Amir10202010/neuromove/hardware/models/enclosure/ПРОВЕРКА-v3.md

# Проверка корпусов v3, 27 октября 2026

Как проверены корпуса для датчиков со штырьками и ESP32 на макетной плате, пока их никто
не напечатал. Проведены три уровня автоматизированной проверки:
геометрия сборки в модели, расчёт защёлки, 1000 случайных отпечатков на корпус. Плюс проверка STL.
Пересчитать: `python3 korpus_v3.py` и `python3 proverka_v3.py` (нужны build123d, scikit-fem, trimesh).
Seed 20261027.

**Итог.** В модели прошли все 60 проверок. На принтере, на котором 15 октября печатали первую
версию, все условия выполняются у 88% отпечатков датчика и 92% отпечатков корпуса ESP32. Почти все
провалы — разброс защёлки, тот же, что у v2. На незнакомом принтере 75%: там чаще всего бортик
крышки не входит в корпус, это лечится XY-компенсацией крышки. Печатью не проверено.

## Что исходные данные, а что допущение

Замер Амирхана 27 октября: датчик со штырьками 22 × 19 × 7 мм, наклон на столе около 11°;
макетная плата 45 × 33 × 9 мм; ESP32 51 × 28 × 13 мм, вместе с макетной платой 51 × 38 × 17 мм;
ремешок не шире 25 мм.

Из замера выведено: хвосты выводов под платой около 2,9 мм. Если плата лежит дальним краем на столе,
а хвостами в 1,3 мм от другого края, то при наклоне 11° под хвостами 14,7 × tg 11° ≈ 2,9 мм. Высота
7 мм с этим сходится: 2,9 + плата 1,6 + пластик штырьков 2,5.

Расхождение с замером: вдоль ряда выводов 19 мм, а восьми выводам с шагом 2,54 мм нужно 20,3 мм.
Ширина корпуса взята по v1, который 15 октября сел на плату. Длина ESP32 51 мм против 52,3 мм
по фото 23 октября: полость рассчитана на плату до 53 мм.

Не мерилось: толщина жилы провода (взято 1,4 мм; в расчёте 1,3–1,5 и отдельно 1,2–1,7), высота гнезда
«папа» над макетной платой (14 мм; в расчёте 13,5–15), где у макетной платы первый ряд и столбец
(по шагу дырок).

## Найдено и исправлено до печати

- **Висящий ряд ESP32 не годится для проводов.** Гнездо «мама» на штырьке висящего ряда уходит на 14 мм
  вниз, а до дна там 9 мм. На этом ряду D32 и D33, шина груди. Шина 1 перенесена на D19 и D18
  правого ряда. Позже, 27 октября, прошивка перешла на три шины по умолчанию (D21/D22, D19/D18, программная
  на GPIO16/17), опция `NM_BUS1_RIGHT` убрана; прежняя разводка — `NM_TWO_BUSES`.
  Тест прошивки на компьютере: 108 проверок прошли; с опцией шина 1 на 19 и 18, без неё на 32 и 33.
- **У вывода 3V3 три свободные дырки, а нужно четыре**: VCC трёх датчиков и AD0 «ПР». Ряд d закрывает
  край ESP32: модель показывает, что гнездо в нём упирается в плату на 0,4 мм. Выход — плоская перемычка
  по ряду d из столбца 15 в свободный столбец 16, она проходит под краем ESP32.
- **Опора под висящим краем ESP32 была впритык.** Высота макетной платы гуляет на ±0,3 мм, и у 27%
  отпечатков опора поднимала край ESP32. Теперь опора ниже на 1,6 мм, на ней два слоя вспененного
  скотча: касается у 99,5%.
- **Полость ESP32 53,6 мм была коротка** для платы 53 мм у 8% отпечатков. Стала 54,4 мм.
- **Язычок датчика прижимал провода слабо** у 5% отпечатков при нажиме 0,25 мм. Стал 0,3 мм: прижимает
  у 97,8%, мешает крышке сесть у 1,3%.
- **Над гнёздами на изгиб провода было 4,5 мм**, у 4% гнёзд выше 14,5 мм этого мало. Стало 5 мм.
- **Плата датчика на вспененном скотче гуляла бы по высоте** на ±0,4 мм, вместе с ней провода в пазу.
  Теперь скотч тонкий, а под хвосты выводов канавка в дне.

## 1. Геометрия сборки, `korpus_v3.py`

Датчик, 32 проверки. Плата, хвосты, пластик штырьков и гнёзда входят и корпус не задевают. Плата лежит
на площадке, ниже на 0,3 мм упирается: значит, лежит ровно, не на хвостах. Хвосты не достают дна
канавки и с запасом 0,3 мм. Гнёзда отъезжают не дальше 1,5 мм, на штырьке остаётся 4,5 мм. Ни одна из
трёх крышек не задевает плату, детали до 1,9 мм, пластик и гнёзда. Пять проводов ложатся в паз, язычок
каждой крышки прижимает каждый провод. Гнездо в паз не пролезает: паз 6,52–7,82 мм по высоте, гнездо
6,10–8,64. Защёлка: крышка садится, на 1 мм выше упирается с обеих сторон, повёрнутая не садится,
балки отделены прорезью. Ремешок 25 мм проходит, 28 мм нет.

ESP32, 28 проверок. Макетная плата, ESP32, модуль, USB-C, оба ряда штырьков на месте и ничего не задевают.
Макетная плата, сдвинутая на 1 мм в любую сторону, упирается. Висящий край лежит на опорах через пену,
выше на 0,5 мм упирается в штыри крышки. Все 13 гнёзд по таблице из [`ПЕЧАТЬ-v3.md`](ПЕЧАТЬ-v3.md) стоят
и не задевают ESP32, корпус и крышку. Перемычка в ряду d лежит под ESP32. Три ленты по пять жил лежат
в своих ложбинках, дверца прижимает каждую жилу. Штекер USB-C 12 × 6,5 мм входит. Ремень 40 мм проходит.

## 2. Защёлка и 1000 отпечатков, `proverka_v3.py`

Балки защёлки те же, что в v2. Датчик: балка 24 × 1,3 × 1,8 мм, натяг 0,3 мм, 5,6 Н на выступ,
закрыть около 17 Н, держит около 26 Н, растяжение 1,1%. ESP32: балка 28 × 1,6 × 1,8 мм, 5,9 Н,
закрыть около 18 Н, держит около 28 Н, растяжение 0,9%.

Сверх разброса принтера, как в v2, у каждого отпечатка случайные: плата GY-521 20,0–21,2 × 15,6–16,4 мм,
хвосты 2,5–3,4 мм, пластик штырьков за краем платы на 0–1 мм, ось штырька 1,15–1,4 мм над платой,
гнездо 13,6–14,6 мм длиной и 2,45–2,6 мм в сечении, скотч 0–0,2 мм; макетная плата ±0,3 мм по каждому
размеру; ESP32 51–53 × 28,5–28,9 мм, пластик её штырьков 2,4–2,6 мм; пена на опоре 1,8–2,4 мм.

| Корпус | Все условия |
|---|---|
| Датчик, жила 1,4 ± 0,1 мм | 74,6% |
| Датчик, принтер как 15 октября | 88,3% |
| Датчик, провод не мерили: 1,2–1,7 мм | 70,0% |
| ESP32, жила 1,4 ± 0,1 мм | 75,2% |
| ESP32, принтер как 15 октября | 91,8% |

Что проваливается чаще всего: бортик крышки не входит в корпус на незнакомом принтере (82–84%), это
XY-компенсация; держит слабее 10 Н (около 96%); растяжение балки датчика больше 2% (91,6% на незнакомом,
97,7% на знакомом). Условия про плату, провода и гнёзда выполняются у 97–100% отпечатков.

## 3. STL

Все шесть сеток замкнуты, обход граней верный, каждая деталь из одного куска, лежит на столе плоской гранью.
Снизу без опоры почти ничего: мосты 5 мм² у корпусов (потолок прорезей), у крышек 175–200 мм² — дно букв
и прорези над балками, как в v2.
