Amir10202010/neuromove/железо.md

# NeuroMove — железо

Этот файл описывает аппаратную часть и формат взаимодействия с программной частью
([`софт.md`](софт.md), раздел 1). Актуальные схемы и инструкции по устройству находятся в [`hardware/`](hardware/README.md).

Схема простейшего прототипа для трекера — способ А на одной руке: компоненты, крепление,
запись данных, стоимость и риски — [`прототип.md`](прототип.md).

---

## 1. Что в питче (слайды 5, 6, 11)

- 4–6 блоков размером ~5×3×1 см и весом 30–50 г на эластичных ремешках с липучкой.
- Батарея на 2–3 часа, зарядка через USB-C.
- IMU — 9-осевой модуль Trema на BMX055: акселерометр, гироскоп, магнитометр.
  На скриншоте «Чип и Дип» на слайде 6 — 10 800 ₸.
- Смета команды на один датчик: IMU $4–6, микроконтроллер с Bluetooth $4–6, батарея
  и зарядка USB-C $4–6, корпус и ремешок $3–4, плата и сборка $3–5 — итого ~$18–27.
  Комплект из 4–6 датчиков — ~$70–160, от 100 комплектов — ~$50–100.

⚠️ Смета питча — цена **чипов для своей платы в серии**. Прототип собирают из готовых
модулей в магазине, и стоит он иначе (раздел 6).

## 2. Какой IMU брать для прототипа

| | MPU-6050 (модуль GY-521) | BMX055 (модуль Trema) |
|---|---|---|
| Оси | 6: акселерометр и гироскоп | 9: плюс магнитометр |
| Цена | 1 050–1 650 ₸ | 10 800 ₸ (слайд 6) |
| 5 датчиков | ~5 000–8 000 ₸ | ~54 000 ₸ |
| Ориентацию считает сам | нет — считаем в софте | нет — считаем в софте |
| Где купить | Alash Electronics, AmperMarket, Kaspi; скорее всего есть в запасах | «Чип и Дип» |

Предложение — прототип на MPU-6050. Магнитометр, ради которого берут 9 осей, в помещении
врёт рядом с металлом: кровати, коляски, тренажёры. Для угла в суставе он не нужен — угол
между двумя сегментами считается по гравитации и гироскопу. Если позже понадобится
ориентация «по компасу» — BNO085: он сам сводит датчики внутри чипа, но с ESP32
подключается только по SPI.

## 3. Три способа собрать прототип

| | Как | Плюсы | Минусы | Когда |
|---|---|---|---|---|
| **А. Провода** | один ESP32 на туловище, IMU на плече и предплечье — по проводам (I2C); ESP32 → USB → ноутбук | дёшево; все датчики на одних часах — синхронизация бесплатно; без Bluetooth | провода мешают; ребёнку неудобно | стенд и демонстрация на себе: октябрь — ноябрь |
| **Б. Каждый датчик сам по себе** | в каждом блоке свой ESP32, IMU и аккумулятор; каждый по Bluetooth к компьютеру | как в питче; без проводов | у каждого блока свои часы — нужна синхронизация; 5 подключений Bluetooth одновременно | пилот |
| **В. Датчики и хаб** | блоки шлют данные хабу-ESP32 по ESP-NOW, хаб по USB — в ноутбук | без проводов на ребёнке; одно надёжное подключение к компьютеру; хаб задаёт общее время | ещё один ESP32 и прошивка хаба | если в варианте Б сбоит связь |

Предложение: **А** — к живой демонстрации «датчик на руке → отчёт на экране»,
**Б** или **В** — к пилоту на детях.

## 4. Где стоят датчики

| Датчик | Место | Для чего |
|---|---|---|
| Туловище | грудина | компенсаторные наклоны; опора для угла в плечевом суставе |
| Плечо, левое и правое | середина плеча снаружи | подъём руки: плечо относительно туловища |
| Предплечье, левое и правое | ближе к запястью | сгибание локтя: предплечье относительно плеча |

Одна рука — 3 датчика, две руки — 5. Ноги — следующим шагом: бедро, голень, стопа
дают колено и голеностоп.

## 5. Подключение стенда — способ А

Два MPU-6050 висят на одних и тех же четырёх проводах шины I2C. Различаются только
выводом AD0: он задаёт адрес, по которому ESP32 отличает датчики.

| Вывод GY-521 | IMU №1 — плечо, рядом с ESP32 | IMU №2 — предплечье, по кабелю | ESP32 DevKit |
|---|---|---|---|
| VCC | 3V3 | 3V3 | 3V3 |
| GND | GND | GND | GND |
| SCL | GPIO22 | GPIO22 | GPIO22 |
| SDA | GPIO21 | GPIO21 | GPIO21 |
| AD0 | GND → адрес 0x68 | 3V3 → адрес 0x69 | — |

- Третий и четвёртый датчик (туловище, вторая рука) — на вторую шину I2C: у ESP32 их две,
  выводы второй назначаются программно, например 32 и 33. Адреса там снова 0x68 и 0x69.
- Arduino Uno или Nano на стенде: VCC → 5V, SDA → A4, SCL → A5, остальное так же.
- Кабель до дальнего датчика — до ~50 см, шина на 100 кГц. Если связь сбоит — укоротить кабель.
- ⚠️ LiPo 3.7 В нельзя подавать на вход VIN платы DevKit: её стабилизатор (обычно AMS1117)
  при входе ниже ~4.3 В не держит 3.3 В, и плата перезагружается. Для блока с аккумулятором —
  плата с зарядкой LiPo (XIAO ESP32C3) или пауэрбанк.
- **Плата стенда — классический ESP32 DevKit** (ESP32-WROOM-32, CH340C, USB Type-C), куплена 9 октября:
  выводы как в таблице выше, вторая шина на 32 и 33. Если стенд соберут на ESP32-S3 N16R8, у неё другие
  выводы — шина 0 на GPIO 8 и 9, шина 1 на GPIO 4 и 5. Таблица, сборка и прошивка — [`firmware/README.md`](firmware/README.md).
- Датчики ставятся одинаково: ось X вдоль кости, стрелка на корпусе. Перед тестом —
  3 секунды неподвижно в исходной позе: это ноль.

## 6. Цены на прототип

Цены в тенге — магазины Казахстана на 24 сентября 2026; в долларах — у производителя, без доставки.
Строки «оценка» по магазинам не проверены.

| Компонент | Что | Цена |
|---|---|---|
| Микроконтроллер, **куплен 9.10** | ESP32 DevKit: ESP32-WROOM-32, CH340C, USB Type-C | 3 498 ₸ (Kaspi, MILTECH) |
| IMU, **куплены 9.10** | GY-521 (MPU-6050), 4 шт. | 882 ₸ за штуку (Kaspi, Alash Electronics) |
| Микроконтроллер | ESP32 DevKit (Wi-Fi и Bluetooth LE) | 3 450–4 500 ₸ |
| Микроконтроллер, выбор Малики для стенда | ESP32-S3 N16R8: две шины I2C, 2 × USB-C | 6 500 ₸ (AmperMarket, 29.09) |
| Плата для беспроводного блока, выбор Малики | ESP32-C3 Super Mini: одна шина I2C, зарядки LiPo нет | 1 900 ₸ (AmperMarket, 29.09) |
| IMU | MPU-6050, модуль GY-521 | 1 050–1 650 ₸ за штуку; в AmperMarket 29.09 — 1 950 ₸ |
| IMU, вариант питча | BMX055, модуль Trema | 10 800 ₸ за штуку (слайд 6) |
| IMU, если нужен компас | BNO085 — с ESP32 только по SPI | $29.50 за штуку (Adafruit) |
| Плата для беспроводного блока | XIAO ESP32C3 — с зарядкой LiPo | $4.90 (Seeed Studio) |
| Аккумулятор | LiPo 3.7 В, 300–500 мА·ч | оценка ~1 000–2 000 ₸ |
| Провода | 4-жильный кабель до ~50 см, дюпоны | оценка ~500 ₸ |
| Корпус и крепление | 3D-печать, липучки, мягкая подкладка | оценка ~1 000–2 000 ₸ за блок |
| Эталон для проверки | гониометр — взять у центра; видео сбоку, угол по видео в Kinovea (бесплатная программа) | 0 |

**Стенд способа А** (ESP32 + 3 × MPU-6050 + провода): ~7 000–10 000 ₸,
а если MPU-6050 и ESP32 есть в запасах — почти ноль. Куплено 9 октября: плата и 4 датчика за 7 026 ₸;
полный список стенда с проверенными ценами — [`прототип.md`](прототип.md), раздел 2.

## 7. Безопасность — для детей обязательно

- Только питание от аккумулятора или пауэрбанка; ничего на ребёнке не подключено к розетке.
- Корпус закрыт, аккумулятор недоступен, нет мелких деталей (дети тянут в рот) и острых краёв.
- Провода способа А — только на стенде и на себе, не на ребёнке.
- Прибор только измеряет: никакого тока в тело.
- Датчики на ребёнке — только при враче или инструкторе.

## Источники цен — проверено 24 сентября 2026

- MPU-6050 (GY-521): [Alash Electronics — от 1 050 ₸](https://alash-electronics.kz/product/giroskop-gy-521-na-baze-mpu-6050),
  [AmperMarket](https://ampermarket.kz/sensors/proximity/gyroscope-gy-521-mpu-6050/),
  [Kaspi](https://kaspi.kz/shop/p/akselerometr-arduparts-kz-giroskop-gy521-mpu-6050-1023--136326815/)
- ESP32 DevKit: [Alash Electronics — от 3 450 ₸](https://alash-electronics.kz/product/esp-woom-32),
  [с USB Type-C — от 4 500 ₸](https://alash-electronics.kz/product/esp-wroom-32-wi-fi-bluetooth-usb-type-c),
  [AmperMarket](https://ampermarket.kz/arduino/esp32-wi-fi-bluetooth/)
- XIAO ESP32C3 — [$4.90, Seeed Studio](https://www.seeedstudio.com/Seeed-XIAO-ESP32C3-p-5431.html)
- ESP32-S3 N16R8 — [AmperMarket, 6 500 ₸](https://ampermarket.kz/boards/esp/esp32-s3-n16r8/);
  ESP32-C3 Super Mini — [AmperMarket, 1 900 ₸](https://ampermarket.kz/boards/esp/esp32-c3-super-mini-weld/);
  GY-521 — [AmperMarket, 1 950 ₸](https://ampermarket.kz/sensors/proximity/gyroscope-gy-521-mpu-6050/) — проверено 29 сентября 2026
- BNO085 — [$29.50, Adafruit](https://www.adafruit.com/product/4754);
  про I2C с ESP32 — [руководство Adafruit](https://learn.adafruit.com/adafruit-9-dof-orientation-imu-fusion-breakout-bno085/arduino)
- BMX055 (Trema) — цена со скриншота на слайде 6, по магазину не сверялась.
