Amir10202010/neuromove/питч/README.md

# Питч NeuroMove — сентябрь 2026

15 слайдов питча команды для НИШ-инкубатора, получены 24 сентября 2026.
Слайды 1 и 15 заменены 26 сентября по PDF из Canva от 24 сентября (автор — Малика):
на титуле добавлен Амирхан, у слайда 15 новый заголовок. Остальные слайды в PDF те же.
Разбор, что в нём поправить, — [`../README.md`](../README.md), раздел 6.

| Слайд | Что на нём |
|---|---|
| [01](01.jpg) | Титул: «Система объективной оценки движения у детей с ДЦП на основе носимых IMU-сенсоров». NIS IB & NIS Nura Astana; капитан — Кеуденбай Малика, hardware — Хасенов Санжар, software — Сағындық Амирхан; выпуск 2028 |
| [02](02.jpg) | Проблема: «больше 20 тыс. детей с ДЦП в Казахстане»; по протоколу РК оценивают шкалами GMFCS, GMFM и модифицированной шкалой Эшворта; шкалы балльные и субъективные |
| [03](03.jpg) | Проблема: шкалы не дают градусов объёма движений, симметрии, ротации, компенсаторных наклонов; врач не видит, где терапия работает, а где плато; родители не видят динамику |
| [04](04.jpg) | Решение: 4–6 датчиков на запястьях, локтях, коленях, голеностопах; отчёт за 10–15 минут; ROM, симметрия, плавность, компенсации; «не замена шкалам, а дополнение». Фото — коммерческий датчик из MedicalEXPO |
| [05](05.jpg) | Датчики: ~5×3×1 см, 30–50 г, ремешок на липучке; приложение на ПК, казахский и русский, PDF и веб-интерфейс; батарея 2–3 часа, USB-C. Картинка сгенерирована OpenAI |
| [06](06.jpg) | Как работает IMU: акселерометр, гироскоп, магнитометр; модуль Trema на BMX055 («Чип и Дип», 10 800 ₸); таблица «метрика → датчик → как считаем» |
| [07](07.jpg) | Макет интерфейса «NeuroMove KZ»: датчики на плечах и предплечьях, ROM, симметрия, плавность, наклон туловища, MotorScore 72/100, история тестов, экспорт PDF. Сгенерирован OpenAI |
| [08](08.jpg) | Второй макет, на английском: анализ руки, индекс симметрии, тренд прогресса, MotorScore. Сгенерирован OpenAI |
| [09](09.jpg) | Ребёнок с датчиками и планшетом с отчётом — «связка датчиков и веб-интерфейса на ПК». Сгенерировано OpenAI |
| [10](10.jpg) | Целевая аудитория: родители и дети, врачи («10–15 минут вместо 30–60»), реабцентры |
| [11](11.jpg) | Смета: ~$18–27 за датчик, $70–160 за комплект, $50–100 при серии от 100; «на стадии идеи, ищем спонсоров и команду» |
| [12](12.jpg) | Как встраиваться: пилот в 1–2 центрах, B2B «оборудование + подписка», B2G с Минздравом, обезличенная статистика; модель сотрудничества с центрами |
| [13](13.jpg) | План на инкубацию: прототип на 2–4 датчиках, алгоритм ROM/симметрии/плавности, веб-интерфейс с отчётом, пилот на 5–10 детях, согласие центра, живая демонстрация на Demo Day |
| [14](14.jpg) | Что нужно от программы: менторство по медтеху, экспертиза в железе и обработке сигналов, финансирование, выход на B2G |
| [15](15.jpg) | «Отзыв врача-реабилитолога»: сообщение в мессенджере от 15 сентября 2026 — заведующий отделением реабилитации Центра неврологии и реабилитации «Aspasia», Алматы |

Картинки на слайдах 5, 7, 8, 9 сгенерированы — это макеты, не работающий прибор.
На слайдах 2, 3, 10 — стоковые фото.
