Amir10202010/neuromove/website/src/assets/README.md

# Картинки стартовой страницы

| Файл | Что на нём | Где |
|---|---|---|
| `movement-study-1536.webp` (100 КБ), `-768` (27 КБ) | Рука взрослого с датчиком на предплечье и ремешком на плече | первый экран, `features/welcome/HeroPhoto.tsx` |
| `sensor-concept-1536.webp` (173 КБ), `-768` (57 КБ) | Датчик: светлый корпус на тканевом ремешке | сцена «Датчики», `features/welcome/sections/Kit.tsx` |

**Это концепт-изображения, сгенерированные 27 сентября 2026** для версии страницы, сделанной
на другом компьютере. Модель и датчик вымышлены: это не снимки настоящего устройства, не пациент
и не участник исследования. На странице так и подписано — «концепт-изображение», «концепт корпуса».
Корпус, материалы и размеры — направление дизайна, а не характеристики: прототип собирает команда
(`../../../железо.md` — там реальные датчики, цены и способы сборки).

Чего по этим картинкам **не говорить**: что устройство готово, что его носили дети, что это фото
с занятий или из клиники.

Картинки подключены через `import`, а не лежат в `public/`: так Vite кладёт их в обычную сборку
с хешем в имени, а в демо одним файлом (`npm run build:demo`) — прямо внутрь HTML. Иначе
`demo/NeuroMove.html`, открытый с диска, остался бы без фото.

⚠️ На фото — взрослый, а продукт — для детей с ДЦП. Если жюри или врач спросит — честный ответ:
это иллюстрация того, где стоят датчики, снимков с детьми нет и без согласия родителей и этического
комитета не будет.

Знак NeuroMove — `src/ui/Logo.tsx` (для приложения) и `public/brand/` (SVG для презентаций:
знак, знак со словом, иконка вкладки). В `index.html` иконка вкладки вшита строкой — так она есть
и в демо одним файлом.

Монограмма `nm` — плавная линия с терракотовой точкой соединения. SVG без пустых полей;
в интерфейсе линия наследует цвет текста, а в тёмной шапке точка становится светлее.
`LogoMark` встроен в страницу и не требует загрузки отдельной картинки, в том числе в офлайн-демо.
При изменении геометрии обновлять также SVG в `public/brand/`; компактный знак для вкладки
хранится в `favicon.svg` и дублируется как data URL в `index.html`.
