Amir10202010/neuromove/website/docs/DESIGN_SYSTEM.md

# Дизайн-система NeuroMove

Одна система на стартовую страницу и приложение. Токены — `src/styles/tokens.css` (приложение)
и переменные `--lp-*` в `src/styles/landing.css` (страница); рисунки — `src/figures/`;
секции с данными — `src/styles/instrument.css`. История решений — `EXPERIENCE.md`, аудит перед
этим проходом — `DESIGN_AUDIT.md`, референсы — `REFERENCE_STUDY.md`.

## 1. Направление — выбор 17 октября 2026

Сравнивали три разных направления, а не три оттенка одного.

| | A. «Протокол измерения» | B. «Кино» | C. «Клинический журнал» |
|---|---|---|---|
| Суть | Сайт и приложение — откалиброванный прибор: шкалы, риски, моно-подписи, волосяные линии, числа из системы, один цвет у измеряемого | Тёмные полноэкранные кадры, огромная светлая типографика, закреплённые сцены, разборное устройство | Страница как научная статья: заголовки с засечками, «Методы → Результаты → Ограничения», таблицы, сноски |
| Связь с продуктом | Прямая: продукт и есть измерительный прибор | Слабая: нужна настоящая съёмка, которой нет | Сильная для врачей и жюри |
| Отличие от рынка | Высокое: никто из референсов не показывает работающий алгоритм | Низкое: так выглядят Neuralink и Palantir | Среднее |
| Честность | Высокая: визуал рисуется из данных | Низкая: держится на сгенерированных картинках | Высокая |
| Семьям | Понятно, если числа сопровождаются словами | Холодно | Сухо, много текста |
| Риски | Перегрузить деталями | Пустая красота, «ИИ-лендинг» | Скучно, мало продукта; кириллица и казахские буквы у шрифтов с засечками проверены хуже |
| Производительность | SVG и DOM, без библиотек | Видео и WebGL | Лёгкая |

**17 октября выбрано A** — с дисциплиной доказательств из C. **18 октября Амирхан это отверг**:
страница «выглядит как фигня», «как в neuralink» — и попросил вернуть сцену «Как это работает»
с разборной моделью датчика и сделать тёмные фоны чисто чёрными. Ошибка была в выборе: я разобрал
Neuralink и пошёл в «инженерную документацию» (плотные графики, моно-подписи, рамки), а Амирхану
нужен язык самого Neuralink. Поэтому с 18 октября основа — **B «Кино»** по замерам neuralink.com
(раздел 4): чёрный и белый, тонкие крупные заголовки, мало текста на экран, крупный предмет.
От A остались данные там, где они уже есть («Проверка», «Данные»), и честные подписи.

**Вечером 18 октября — второй проход** по просьбе Амирхана: «картинки, анимации и иллюстрации
ужасно выглядят», страницу сократить. Референсы — сайты носимых медицинских приборов
(Apple Health, Oura, Whoop, Hinge Health, Sword Health; `REFERENCE_STUDY.md`, раздел «18 октября,
вечер»). Что взяли: у каждого утверждения своя картинка, а не абзац (Hinge Health: точки, дуга);
число крупно и тонко рядом с маленькой инфографикой; сноска, откуда число (Apple, Oura); скелет
из линий как язык движения (Sword) — у нас кадрами во времени, из модели движения.
Одиннадцать сцен стали девятью: «Отчёт» слит с «Семьям», «Данные» — карточка в «Проверке».

**Поздно вечером 18 октября** светлые секции стали чисто белыми вместо тёплой «бумаги» `#f3f1eb`,
серые на них — нейтральными, без зелени (просьба Амирхана: «как у Neuralink»). Страница теперь
в двух цветах, белом и чёрном, и одном акценте. Экраны приложения внутри планшета остаются в своих
токенах (`tokens.css`): это настоящий интерфейс, страница не должна его перекрашивать.

## 2. Принципы

1. **Каждое число — из системы.** Цифры страницы считаются функциями приложения на демо-данных
   (`story.ts`), график «Проверки» — из сырых файлов прогона (`proofData.ts`, сверка — тест).
2. **Рисунок вместо слова, слово рядом с числом.** «145°» без картинки ничего не говорит, картинка
   без подписи — украшение.
3. **Подпись говорит, что настоящее, а что нет.** «Пример из демо, данные смоделированы»,
   «схема-концепт датчика», «независимая модель, не люди».
4. **Цвет только у измеряемого.** Правая рука — оранжевый, левая — синий (`--right`, `--left`),
   киноварь — результат проверки, правила, «смотрите сюда» в гиде. Остальное на странице —
   белый, чёрный и нейтральный серый; в приложении — графит и бумага.
5. **Линии вместо карточек.** Секции, списки, шаги разделены волосяными линиями 1 px.
   Карточка — только у того, что в жизни лист или экран (отчёт, планшет, рисунок движения).
6. **Одна главная кнопка на экране.** На странице — «Попробовать демо».
7. **Тексты без длинного тире**, имена вместо кодов, «демо» в приложении говорит одна полоса
   (решения Амирхана 15 и 17 октября).

## 3. Цвет

### Приложение (`tokens.css`)

| Слой | Токен | Значение |
|---|---|---|
| Рамка окна, боковая панель | `--frame`, `--side` | `#eeebe4` |
| Рабочий лист | `--sheet` | `#faf9f6` |
| Карточка | `--surface` | `#ffffff` |
| Текст: основной, второй, третий | `--text`, `--text-2`, `--text-3` | `#1d211f`, `#4d534b`, `#5c6159` (не ниже 4,5:1 на всех слоях) |
| Линия | `--border`, `--border-strong` | `#e5e1d8`, `#d3cdc1` |
| Стороны тела | `--left`, `--right` (+ `-soft`, `-text`) | `#2a78d6`, `#eb6834` |
| Демо и гид | `--demo` | `#b7452c` (киноварь знака) |
| Состояния | `--good`, `--warn`, `--critical`, `--info` | всегда с иконкой и словом |

### Страница (`landing.css`, `.lp`)

| Тема секции | Фон | Текст / приглушённый / подпись | Где |
|---|---|---|---|
| `lp-white` | `#ffffff` (с позднего вечера 18 октября — все светлые секции; до того часть была «бумагой» `#f3f1eb`) | `#0b0b0c` / `#55555c` (7,4:1) / `#6e6e76` (5,1:1) | первый экран, «Сегодня», датчики, тест вживую, «Семьям», «Проверка», подвал |
| `lp-dark` | `#000000` (с 18 октября; до того графит `#191c1a`) | `#ffffff` / 72 % / `#86868e` | «Как это работает», «Специалистам», финал |
| карточка `lp-card`, `lp-study` | `#0b0b0c` / `#0a0a0b` | `#ffffff` / 74 % / `#8e8e96` | карточки «Проверки» на белом, рисунки движений на чёрном |

Ритм: белые и чёрные секции чередуются, соседние белые секции сливаются в одно поле, как у Neuralink; на белой «Проверке» — почти чёрные карточки, как
карточки исследований у Hinge Health (у них тёмно-зелёные). Киноварь на тёмном — `#dc6440` (`--lp-accent-hi`), на светлом — `#b7452c`.
Серые тона модели датчика на чёрном — нейтральные, без зелени; зелёная только плата.

## 4. Типографика

| Роль | Шрифт | Размер, начертание |
|---|---|---|
| Заголовки страницы | Inter Display (ось оптического размера) | `lp-d1` 44–104 px / 300, `lp-d2` 36–76 px / 300, трекинг −0,05…−0,055 em, интерлиньяж 1,0 |
| Подпись раздела | Inter | 16 px / 400, серая (`--lp-faint`) — как «Implant» у Neuralink; без капслока и моно |
| Абзац страницы | Inter Display | `lp-lead` 17–19 px / 400, интерлиньяж 1,42 |
| Интерфейс | Inter | 14,5 px основной, 13 px подписи, кнопки 38 px высотой (44 px пальцем) |
| Числа-приборы | Inter Display, цифры одной ширины | угломер, таймер, показание прибора 46 px / 330 |
| Выноски модели, оси графиков, даты на линии времени | JetBrains Mono | 10,5–12 px, прописные с разрядкой |
| «Рис. N» и подписи под рисунками | Inter | 13 px / 400 |

Замеры neuralink.com 18 октября (1440 × 900): один шрифт (UntitledSans) на всё; заголовок первого
экрана 48 px / 500, заголовки секций 44 px / 300, заголовки шагов на странице Technology 80 px / 300,
трекинг −0,06 em, интерлиньяж 1,0; абзац 16–18 px, интерлиньяж 1,15–1,2; подписи 16 px, серые
`#797981`; фон тёмных секций `#000`. Кириллица шире латиницы, поэтому у нас трекинг −0,05…−0,055 em
и интерлиньяж абзаца 1,42.

Почему не другой шрифт: рассматривали Onest, Golos, Manrope, IBM Plex Sans, Geologica и шрифт
с засечками для направления C (Source Serif 4). Inter остаётся: полная кириллица с казахскими
буквами, ось оптического размера в одном файле (Inter Display на заголовках без второго
семейства), шрифт вшит в офлайн-демо. Смена шрифта сейчас — переделка всех экранов и демо
без выигрыша для человека. У JetBrains Mono 17 октября добавлена расширенная
кириллица: казахские буквы в моно-подписях раньше брались из системного шрифта (аудит, A7).

## 5. Сетка, отступы, скругления, глубина

- Страница: колонка до 1320 px, поля `clamp(20px, 5vw, 72px)`, секции `clamp(110px, 16svh, 180px)`
  сверху и снизу. Заголовок секции — `lp-split`: слева подпись и заголовок, справа абзац по нижнему краю.
- Приложение: шаг 4 px (`--s-1` … `--s-12`), лист с отступом 8 px от рамки.
- Скругления: 6, 9, 12, 16 px в приложении; 14–22 px у листов страницы; 999 px у кнопок-«пилюль».
- Глубина: тоном и линией. Тень — только у того, что лежит поверх (окна, меню, гид) и у листа отчёта.

## 6. Рисунки и приборы

**Система рисунков** (`src/figures/`, подробно — `EXPERIENCE.md`): одна геометрия ребёнка ~8 лет,
контур 1,5 px при любом размере, датчик — светлый корпус на тёмном ремешке со светодиодом.
С 8 ноября 2026 части тела — рисованные кривые (`geometry.smooth`) в системе координат сегмента:
голова в профиль с ухом и короткой стрижкой (`--fig-hair`), кисть с большим пальцем, колено, стопа.
Спереди руки лежат под корпусом — плечо продолжает линию трапеции. Датчики стоят как на прототипе
(`прототип.md`, корпус v3): грудина — корпус «портретом» на ремне 38 мм, стрелка вниз; плечо —
наружная сторона посередине; предплечье — тыльная сторона ближе к запястью; основание с «ушками»
под ремешок, стрелка оси X к кисти. Провода не рисуются: тот же рисунок служит и проводному
стенду (способ А), и беспроводным блокам (способ Б).

**Сцена «Как это работает»** (`SensorModel.tsx`, `HowItWorks.tsx`) — разборная модель датчика
на чёрном, четыре шага (надеть, двигаться, измерить, увидеть), слои расходятся по шагам. Это
схема-концепт корпуса, так и подписано. Прибор «Из сигнала в градусы», стоявший здесь 17 октября,
снят по просьбе Амирхана; код — в коммите `a15749b`.

**Рисунки и инфографика страницы** (с вечера 18 октября; стили — `instrument.css` и `landing.css`):

| Где | Рисунок | Что показывает | Откуда данные |
|---|---|---|---|
| Тест вживую | планшет с экраном теста и тур из трёх пунктов | выбранный пункт подсвечивает свою часть экрана: угломер, отметки «прошлый раз» и «цель» на дуге, фигурку | экран — компоненты приложения (`ProductScreen.tsx`); подсветка встаёт по настоящим размерам частей |
| Семьям | лист отчёта со шкалой угла | рука сейчас (оранжевая), как было в начале курса (пунктир), прибавка (сектор), цель врача (ромб) | история Алихана (`story.ts`) |
| Специалистам | хронофотография, 4 рисунка | один повтор каждого движения, кадр каждые 0,1 с: веер руки, след кисти точками через равное время, шкала от сустава, пунктир — пик другой руки | модель движения демо (`studyData.ts`, тест `studyData.test.ts`) |
| Проверка | клин угла | ошибка локтя до правки 41° (штриховка) и после 1,6° (киноварь), предел 5° пунктиром | `proofData.ts` ← `docs/ENGINEERING_10H/data/*.json`, сверка `proofData.node.test.ts` |
| Проверка | 60 точек | 55 выполненных сценариев — белые, 5 известных ограничений — кольцом | тот же тест сверяет 60 / 55 / 5 с файлом прогона |
| Проверка | путь данных | граница «компьютер клиники», датчики → NeuroMove → хранилище, перекрытый выход в интернет | CSP из `vite.config.ts`, тест `e2e/trust.spec.ts` |
| Проверка | шкала стенда | полоса ±5° — критерий против ручного угломера | критерий записан до замера |

Правила рисунков: SVG в «родной» рамке, линии 1–2,5 px, подписи и числа — HTML поверх рисунка
(не растягиваются, берут шрифт страницы); у каждого рисунка подпись, что настоящее, а что модель.
Хронофотография — по снимкам Этьена-Жюля Марея (1880-е): тело в промежуточных кадрах втрое
бледнее руки, чтобы главным был веер движения, а не стопка голов.

## 7. Движение — как на страницах-презентациях Apple

С 18 октября (ночь). Амирхан: «хочу, чтобы сайт был как на презентации Apple». Записал видео
прокрутки страниц Apple Watch Series 12 и iPhone 18 Pro, разобрал по кадрам и замерил стили
в браузере (`REFERENCE_STUDY.md`, раздел «Движение Apple»). Цвет и шрифты остаются как у Neuralink
(чёрный, белый, тонкие заголовки); движение — как у Apple.

**Что делает Apple — пять приёмов.**

1. **Появление текста.** Заголовок или абзац оживает, когда его верх доходит до ~80 % высоты экрана:
   подъём на 30 px за 0,65 с и прозрачность 0 → 1 за 0,8 с, оба с плавным разгоном и торможением.
   Блок целиком, без разбивки на слова.
2. **Сцена от прокрутки.** Экран закреплён на 1,1–1,5 высоты прокрутки; картинка в нём
   увеличивается, отъезжает или поворачивается ровно настолько, насколько прокрутили; заголовок
   проявляется посреди сцены («Heartcore innovation», «Eye-opening control», «Witness your fitness»).
3. **Раскрытие во весь экран.** Скруглённая карточка с фото или видео растёт до краёв экрана.
4. **Устройство поднимается и встаёт.** Снизу, под углом, к середине экрана — ровно («Our finest
   unibody of work»).
5. **Видео, которое «проигрывает» прокрутка.** Кадр зависит от положения страницы; прокрутка
   назад отматывает.

**Как это у NeuroMove.**

| Где | Приём Apple | Как |
|---|---|---|
| Весь текст | 1 | `data-reveal`: подъём на 30 px, прозрачность за 0,8 с, `cubic-bezier(.42, 0, .58, 1)`, линия появления — 82 % высоты экрана. Заголовки целиком: «слова из-под шторки» убраны |
| Первый экран | 1 + анимация на открытии | заголовок, фраза, кнопки, сноска появляются по очереди с шагом 0,15 с; шкала угла рисуется на фото, угол считается до 144°; при прокрутке фото чуть приближается и гаснет под «Сегодня» |
| «Сегодня» | 5 | слова фразы темнеют вместе с прокруткой |
| «Датчики» | 2 + 3 | фото закреплено и раскрывается из карточки (поля 17 % и 23 %, скругление 34 px) во весь экран, картинка отъезжает с 1,16 до 1; с середины сцены поверх поднимается заголовок; сцена — экран и 1,3 экрана прокрутки |
| «Как это работает» | 2 + 4 | модель поднимается снизу и вырастает, пока сцена въезжает; дальше слои расходятся и собираются вместе с прокруткой, «камера» приближается к плате на «измерить» и отходит на «увидеть»; текст шагов прокручивается рядом |
| «Тест вживую» | 4 | планшет поднимается снизу под углом 30° и выпрямляется к середине экрана; тур под ним — как галерея Apple с полосой хода |
| «Семьям» | 3 + 5 | лист отчёта поднимается и растёт до середины экрана; рука на шкале идёт от начала курса к «сейчас» вместе с прокруткой |
| «Специалистам» | 5 | хронофотографию «проигрывает» прокрутка: кадры появляются по мере пути карточки, след тянется за ними, в конце — дуга и число |
| «Проверка» | 4 + 1 | карточки поднимаются вместе с прокруткой (без прозрачности: чёрное на белом не проходит через серый); клин ошибки, точки и стрелка стенда оживают, когда карточка доходит до линии появления |
| Финал | 2 | дуга угломера заполняется, пока секция поднимается |
| Верхняя панель | — | полупрозрачная с размытием, как у Apple: под ней видно, как проезжает страница |

Сцены от прокрутки — без библиотек: `position: sticky`, CSS-переменные прогресса (`data-progress`
в `motion.ts`, один обработчик прокрутки на кадр), `useStepProgress` для модели и
`useScrollProgress` для числа на шкале. Двигаются только `transform`, `opacity` и `clip-path`.

«Уменьшить движение» в системе: текст сразу на месте, фото датчика сразу во весь экран и не
закрепляется, модель меняется шагами без «камеры», рука на шкале и рисунки движений сразу целиком,
тур не идёт сам.

## 8. Взаимодействие и доступность

- Шаги сцены «Как это работает» можно нажать под моделью — страница прокрутится к тексту шага.
- Тур под планшетом — кнопки с `aria-pressed`: нажатие показывает свою часть экрана, и тур
  дальше сам не идёт; фокус с клавиатуры и наведение ставят тур на паузу.
- Открытое окно (вступление демо, подтверждение) держит фокус: переход между экранами его не отнимает.
- Рисунки — `aria-hidden`: всё, что на них, сказано текстом рядом (число, подпись, легенда).
- Фокус с клавиатуры виден на всех элементах; цели не меньше 40 px.
- Контраст подписей не ниже 4,5:1 на всех трёх темах секций.

## 9. Тексты

- Не выдумывать: клиентов, отзывов, сертификатов, «точности на людях» нет и на странице нет.
- Где факта нет — сказать, что будет проверено и как («критерий для стенда 5°, записан до замера»).
- Без длинного тире, без «впервые», без «революционный». Сначала смысл, потом термин.
- Даты — из журнала (`log/`), а не «недавно».
- Казахский — вычитывает носитель (открытый вопрос, `README.md`).
