Amir10202010/neuromove/website/docs/DESIGN_AUDIT.md

# Аудит дизайна NeuroMove — 17 октября 2026

Что проверено: стартовая страница (`#/`) и экраны врача в браузере на 1440 × 900 и 375 × 812
(сервер разработки, демо-данные), код `src/features/welcome/`, `src/styles/`, `src/figures/`,
словари. Каждая находка ниже увидена на экране или подтверждена в консоли браузера, а не выведена
из кода.

## Что уже сильное и остаётся

| Что | Почему держим |
|---|---|
| Честность: «прототип», «концепт», демо отделено от клиники | Для медицинского продукта на стадии прототипа это и есть доверие. Ни одного выдуманного клиента, отзыва, сертификата |
| Каждое число страницы — из данных демо | `story.ts` считает теми же функциями, что карточка пациента. Поменялись данные — поменялась страница |
| Простой вид экранов врача, «Показать подробности», гид-подсказка | Решения Амирхана 15 и 17 октября. Не трогаем |
| Система рисунков `src/figures/` | Одна геометрия ребёнка, контур 1,5 px. Её и берём для новых визуализаций |
| Палитра «бумага, графит, киноварь», токены, контраст | Уже в питче и в знаке. Контраст проверяет axe в сквозных тестах |
| CSP `connect-src 'none'` | Обещание «данные не уходят» закреплено технически и проверено тестом |

## Находки

Серьёзность: **критично** — ломает главный смысл страницы; **высоко** — заметит жюри, трекер или
врач; **средне** — портит качество; **низко** — мелочь.

| # | Где | Что не так | Серьёзность | Решение |
|---|---|---|---|---|
| A1 | Стартовая, «Сегодня» | Сравнение «На глаз: кажется, лучше» и «NeuroMove: на 17° выше» **никогда не показывается**. Блок появляется после загрузки демо-данных, а наблюдатель появления раздаёт отметки только тем блокам, что были на странице при первой отрисовке. В браузере: блок в окне (`top: 92`), `opacity: 0`, отметки `data-in` нет. На месте главного довода страницы — 600 px пустой бумаги | критично | Наблюдатель следит и за блоками, которые появились позже (`MutationObserver`) |
| A2 | Стартовая, «Тест вживую» | Экран теста на странице не совпадает с приложением после 17 октября: в квадрате значка 42 px написано полное имя «Алихан», есть «Симулятор», «Запись», «Шаг 2 из 4 · поражённая», старая раскладка (этапы в шапке). В приложении шаг слева с дорожкой шагов, угломер и фигурка справа | высоко | Экран собран заново по раскладке `LiveMain` из тех же компонентов |
| A3 | Стартовая, «Как это работает» | Разборная модель корпуса на чёрном с закреплёнными шагами повторяет страницу Technology у Neuralink (открыта 17 октября) и показывает корпус, которого нет. Сигнал под моделью — синусоиды «для вида» (`SignalLines`: «иллюстрация, не запись пациента»). На шаге 4 отчёт лежит поверх тени модели. Сцена длиной 3 168 px. То, что отличает продукт, — как сырые числа датчика становятся градусами и фразой отчёта, — не показано | высоко | ~~Сцена заменена прибором «Из сигнала в градусы»~~. **18 октября отменено**: Амирхан попросил вернуть сцену с моделью, она ему нравилась. Модель подписана «схема-концепт датчика», фон — чисто чёрный |
| A4 | Стартовая, телефон | На первом экране 375 × 812 фото взрослой руки занимает 60 % высоты. Под ним заголовок, а фраза о продукте обрывается на краю, кнопки демо не видно: за первые 812 px не понятно, что это и что нажать | высоко | Фото ниже, заголовок плотнее: заголовок, фраза и кнопка демо помещаются в первый экран |
| A5 | Стартовая | Доверие держится на словах. Самое сильное, что есть у команды, — проверка формул на независимом эталоне 2 октября (60 сценариев, критерии записаны до прогона, найдена и исправлена тихая ошибка локтя до 41°) — лежит в `docs/ENGINEERING_10H/` и на странице не видно. Гарантия «данные не уходят» показана одной строкой текста | высоко | Новые секции «Проверка» (график из сырых данных прогона) и «Данные» (путь данных и граница) |
| A6 | Стартовая | Три секции подряд построены одинаково: заголовок и строки с линейками («Семьям», «Специалистам», «Честно»). «Специалистам» — пять строк текста без единого изображения продукта, хотя у приложения есть значки четырёх движений | средне | «Специалистам» — четыре движения рисунками из системы, «Честно» разделено на «Проверку» и «Данные» |
| A7 | Казахский язык | JetBrains Mono подключён без расширенной кириллицы (`fonts.css`). Қ, Ғ, Ә, Ө, Ү, Ң, Һ в моно-подписях («ШЫНТАҚТАҒЫ БҰРЫШ», «4 ҚАДАМНЫҢ 1-ҚАДАМЫ») берутся из системного шрифта: буквы разного рисунка и ширины в одном слове | средне | Добавлен набор `cyrillic-ext` |
| A8 | Стартовая, финал | ~~Шкала угломера уходит за нижний край секции~~. **При перепроверке не подтвердилось**: шкала целиком, полукруг стоит на нижнем крае намеренно. Первый снимок был сделан посреди прокрутки, когда дуга ещё заполнялась | — | Не меняли |
| A9 | Тексты | «Понятно без врача» («Семьям») спорит с «Что они значат для ребёнка, объясняет врач» («Отчёт») и «Выводы делает врач» | средне | «Понятно без медицинских слов» |
| A10 | `index.html` | Нет Open Graph: ссылка в Telegram или WhatsApp (так её отправят трекеру и жюри) придёт без заголовка и описания | низко | `og:title`, `og:description`, `og:type`, `og:locale` |
| A11 | Стартовая | Длина 14 176 px на 1440 × 900 (15,7 экрана), из них 3 168 px — одна сцена с моделью | низко | 17 октября стало 13 763 px. 18 октября сцена с моделью вернулась, заголовки стали крупнее: **15 514 px** — длиннее, чем до прохода. Открыто |
| A12 | Первый экран | Фото — сгенерированное изображение взрослого спортсмена, продукт — для детей. Выбор Амирхана 28 сентября, подписано «концепт» | к сведению | Фото остаётся. Новых сгенерированных картинок не добавляем: новые визуализации рисуются из данных |

## Экраны приложения

Экраны врача после 14–17 октября — одна система: лист поверх рамки окна, статус-кольца, одна главная
кнопка, простой вид. Пересобирать их не нужно, решения Амирхана о простом виде, именах и «демо в одной
полосе» остаются. Что найдено:

| # | Где | Что | Серьёзность | Решение |
|---|---|---|---|---|
| B1 | Казахский, моно-подписи | см. A7: «4 ҚАДАМНЫҢ 1-ҚАДАМЫ», «ДЕНЕ» в шапках шагов и подписях схемы датчиков | средне | шрифт |
| B2 | Подробности теста и отчёта, три языка | Подпись «что меряем» у сгибания локтя: «подъём предплечья минус подъём плеча». Это формула до 2 октября; с правки F1 локоть — поворот в плоскости шарнира (`core/pipeline.ts`, `elbowFlexion`). Текст врал о методе | средне | «Сгибание в плоскости локтевого сустава от прямой руки» на ru, kk, en |
| B3 | Вход в демо | Найдено при проверке, было и раньше (сверено на файле демо из прошлого коммита): после «Попробовать демо» приложение переводило фокус в `<main>` через кадр после открытия окна вступления — фокус уходил с кнопки «Начать» на экран под окном, Tab шёл по странице за окном | высоко для клавиатуры | Открытое окно держит фокус (`App.tsx`), сквозной тест |
| P1 | Скорость, телефон | Замер на рабочей сборке, 375 × 812, процессор ×4, «медленный 4G» (`scripts/perf-landing.mjs`): LCP 2,96 с — фото первого экрана ждёт весь скрипт 857 КБ. CLS 0,32 на первом открытии: сравнение «на глаз / NeuroMove» и лист отчёта появляются после расчёта демо и сдвигают страницу (так было и до прохода), плюс 0,035 дала колонка показаний нового прибора — моя ошибка, найдена этим же замером | высоко | Предзагрузка фото, экраны приложения — отдельным куском, место под поздние блоки и показания занято заранее |

Что ещё проверено и в порядке: консоль без ошибок на стартовой странице и в приложении, тест вживую
на симуляторе от «Надеть датчики» до отчёта, угломер и фигурка двигаются вместе (локоть 26° и 99°
сверены по кадрам).

## Чего на странице нет и не будет

Логотипов клиентов, отзывов, числа пользователей, сертификатов, партнёрств и «точности на людях»:
их нет на самом деле. Пустые страницы «Безопасность», «Цены», «Компания» тоже не создаём — у
прототипа нет фактов для них. Где факта нет, страница говорит, что он будет проверен и как.

## Итог прохода 17 октября

| # | Сделано | Как проверено |
|---|---|---|
| A1 | Наблюдатель появления следит и за блоками, появившимися после загрузки данных (`motion.ts`) | сквозной тест `e2e/landing.spec.ts`: блок виден, `opacity: 1` |
| A2 | Экран теста на странице собран по раскладке `LiveMain`: буквы имени, этапы, шаг, повторы, ход теста, угломер, фигурка | сквозной тест: значок — две буквы, нет «Симулятор», «Запись», «поражённая» |
| A3 | ~~Сцена с моделью корпуса заменена прибором «Из сигнала в градусы»~~ — снято 18 октября, код прибора и его тесты в коммите `a15749b` | — |
| A4 | Первый экран на телефоне: заголовок, фраза и кнопка демо помещаются в 375 × 812 | снимок 375 × 812 |
| A5 | Секции «Проверка» (график из сырых файлов прогона, три числа, линия времени с датами) и «Данные» (схема границы и правило браузера) | `proofData.node.test.ts` сверяет все 24 числа графика с файлами прогона; сквозной тест подписей графика и дат |
| A6 | «Специалистам» — четыре движения рисунками системы; «Честно» разделено на «Проверку» и «Данные» | снимки 1440 и 390 на трёх языках |
| A7 | У JetBrains Mono подключена расширенная кириллица | снимок казахской страницы |
| A9 | «Понятно без медицинских слов» | — |
| A10 | Open Graph в `index.html` | — |
| A11 | Страница 14 176 → 13 763 px на 1440 × 900, хотя секций на одну больше | замер в браузере |
| B2 | Подпись метода у локтя исправлена на трёх языках | — |
| B3 | Фокус остаётся в открытом окне | сквозной тест: после «Попробовать демо» и Tab фокус внутри окна вступления |
| P1 | LCP 2,96 → 2,42 с, CLS 0,32 → 0,006, скрипт первого экрана 857 → 629 КБ (257 → 197 КБ сжатого); экраны приложения (231 КБ) грузятся в свободное время после отрисовки | `scripts/perf-landing.mjs` на `vite preview`: три замера подряд 2,42–2,45 с; длинных задач во время работы прибора нет |

## 18 октября: направление отвергнуто

Амирхан посмотрел страницу после прохода 17 октября: «до сих пор сайт выглядит как фигня»,
«почему ты не посмотрел reference». Просьбы: вернуть «Как это работает» с разборной моделью датчика
и сделать тёмные фоны чисто чёрными, «как в neuralink».

Почему так вышло. Neuralink я открывал, но взял у него доказательства с датами, а язык страницы —
у Linear и Stripe: моно-подписи прописными, «Рис. N», плотные графики, рамки. Получилась
инженерная документация. Neuralink делает обратное: чёрный и белый, тонкие крупные заголовки,
серые подписи обычным регистром, одна мысль на экран.

| Что | Было 17 октября | Стало 18 октября |
|---|---|---|
| «Как это работает» | прибор «Из сигнала в градусы» | разборная модель датчика, как 28 сентября; серые тона модели нейтральные, без зелени |
| Тёмные секции | графит `#191c1a`, текст цвета бумаги | `#000`, белый текст, серые подписи |
| Заголовки | 370, трекинг −0,04 em | 300, трекинг −0,05…−0,055 em, интерлиньяж 1,0 — по замерам neuralink.com |
| Подписи разделов | моно 11 px прописными | 16 px обычным регистром, серые |
| Меню | разделы по центру | знак слева, разделы и пилюля «Демо» с обводкой справа |

Замеры — `REFERENCE_STUDY.md`, раздел «Замеры Neuralink». Что не сделано и почему —
`log/2026-10-18-neuromove-как-у-neuralink.md` в корне репозитория.

## 18 октября, вечер: картинки и анимации

Амирхан: «нынешние анимации, инфографика и иллюстрации ужасно выглядят, нет ощущения, что это
сильная компания», страницу сократить. Разбор по блокам, со снимков 1440 × 900 до правки:

| Блок | Почему выглядело дёшево | Что стало |
|---|---|---|
| Тест вживую | под планшетом три колонки текста с чёрными кружками-номерами; такие же кружки на самом экране — читалось как инструкция к прибору | тур из трёх пунктов: выбранный подсвечивает свою часть экрана (угломер, отметки на дуге, фигурку), остальное приглушено; полоса пункта заполняется, пока он показан. Планшет — тонкая рамка, светлый край корпуса, тень в три слоя, наклон 20° выпрямляется при прокрутке |
| Отчёт | полоска «начало → сейчас → цель» с кружком: обычный индикатор загрузки, к руке отношения не имеет | шкала угла: рука сейчас, пунктир — как было, сектор — прибавка, ромб — цель; число внутри шкалы, подписи — легендой |
| Семьям | планшет с экраном для ребёнка и три строки текста — третья секция подряд «картинка + список» | слито с «Отчётом»: заголовок, абзац и лист |
| Специалистам | четыре мелких значка-фигурки в карточках на бумаге — как иконки в приложении, а не довод | хронофотография на чёрном: один повтор из модели движения, кадр каждые 0,1 с, след кисти, шкала от сустава, пик другой руки пунктиром. Видно не только «144°», но и то, что рука идёт в два приёма и корпус помогает |
| Проверка | график в осях с сеткой, подписями осей и легендой у концов линий — как в научной статье, мелко | карточки: клин угла 41° → 1,6° с пределом 5°; 60 точек (55 белых, 5 кольцом); 5° со шкалой стенда |
| Данные | схема из пяти рамок со стрелками и подписью «Рис. 2» мелким шрифтом | карточка в «Проверке»: граница «компьютер клиники», три узла, перекрытый выход в интернет, четыре правила |
| Анимации | у всех блоков одно и то же: подъём на 32 px и проявление | у каждого рисунка свой жест: кадры хронофотографии по очереди, клин раскрывается, точки выщёлкиваются, стрелка стенда успокаивается в полосе; заголовки секций — словами из-под шторки; общий подъём — 20 px |

Длина страницы: 15 514 → 13 814 px на 1440 × 900, сцен 11 → 9.

Найдено при проверке и исправлено:

- подпись «Интернет» на карточке данных была полупрозрачной — контраст 3,4:1, axe отметил как серьёзное;
  стала серой `#8e8e96` (6:1);
- на телефоне число «41°» налезало на подпись карточки, «1,6°» — на сноску под рисунком: у рисунка
  поля сверху и снизу на узком экране;
- шкала у хронофотографии локтя уходила за край рамки — рисунок локтя крупнее и выше.

## 18 октября, ночь: движение как на презентациях Apple

После отката ночного прохода «как у Neuralink» (коммит `d5a703d`) Амирхан попросил: «посмотри
презентации Apple и сделай, чтобы у меня было так же». Разбор Apple — `REFERENCE_STUDY.md`,
раздел «Движение Apple».

| Было (вечер 18 октября) | Почему не как у Apple | Стало |
|---|---|---|
| Блок всплывал на 20 px за 0,9–1,1 с с быстрым стартом и длинным хвостом, ещё до середины экрана | у Apple движение короче и плавнее, начинается, когда текст дошёл до 80 % экрана | подъём на 30 px, 0,65–0,8 с, плавный разгон и торможение, линия 82 % |
| Заголовки секций выезжали словами из-под «шторки» | у Apple заголовок появляется целиком | целиком |
| Фото датчика стояло в колонке рядом с текстом | у Apple главная картинка — во весь экран, и прокрутка её «снимает» | сцена: фото раскрывается из карточки во весь экран, заголовок поднимается поверх |
| Модель датчика меняла положение по таймеру (1,2 с) при смене шага | у Apple разборная модель следует за прокруткой | слои и «камера» — от прокрутки, модель въезжает снизу |
| Рука на листе отчёта считалась по таймеру, когда лист показался | у Apple такие вещи «проигрывает» прокрутка | рука и число идут вместе с прокруткой, лист поднимается и растёт |
| Кадры хронофотографии проявлялись по таймеру через 70 мс | — | кадры «проигрывает» прокрутка, назад — отматывает |
| Чёрные карточки «Проверки» проявлялись на белом | по пути были серыми | поднимаются вместе с прокруткой, без прозрачности |
| Точки «выщёлкивались», стрелка стенда качалась на пружине | у Apple нет пружин | точки заполняются по очереди, стрелка плавно встаёт в полосу |
| Сплошная верхняя панель | у Apple — полупрозрачная с размытием | полупрозрачная с размытием |
