Amir10202010/neuromove/website/docs/ENGINEERING_10H/FINAL_REPORT.md

# Итог инженерного прохода 2 октября 2026

Старт 07:04 (+05). Работа шла с 07:04 до 09:41 по отметкам часов, потом проверка в браузере
(конец не записан), затем перерыв до сообщения Амирхана; закрытие — по часам до 19:47.
Ход по времени — `LIVE_PROGRESS.md`. Время в документах только по `date`; три раза за день оно
было записано «наперёд» или примерно, и каждый раз исправлено (`DECISION_LOG.md`).

## 1. Что сделано

Главное — независимый эталон углов (`src/verification/`): своя кинематика на кватернионах, другие
оси мира, модель MPU-6050 по даташиту. Прежняя проверка шла на симуляторе с теми же допущениями,
что и формулы, и не могла их опровергнуть. Эталон нашёл ошибку локтя до 41°.

| Блок | Итог |
|---|---|
| Точность углов | 60 сценариев C1–C17 и крайние случаи на 8 датчиках; критерии записаны до прогона; 55 выполнены, 5 — известные ограничения (F2, F3, F4) |
| Инварианты | пропавший датчик не выглядит живым, демо не становится клиникой, нет двойного сохранения, нет нулей вместо пропусков, чужие поправки не применяются, перевёрнутый датчик замечается |
| Хранилище | схема по версиям, проверка записей при загрузке, нехватка места, предпросмотр архива |
| Прошивка | отпечаток модуля, таймаут шины 10 мс, модель времени шины, образцы протокола для приложения |
| Корпус | найдено, что кабель упирался в крышку; исправлено, проверка сборки в `render.mjs` |
| Проверки | 240 юнит-тестов, 25 сквозных, 16 из 16 мутаций, 108 проверок прошивки, 5 сборок, fuzz |
| Документы | план, бэклог, эксперименты, находки F1–F21, решения, блокеры, оси, трассировка, приёмка железа, стартап-документ |

## 2. Находки

21 находка, `FINDINGS.md`. Критичные: F1 (локоть до −41° без пометки), F5 и F18 (пропавший
датчик выглядел живым), F6 (нули в выгрузке). Две находки — мои собственные регрессии, пойманные
тестами до коммита (F12, F18). Одна найдена глазами в браузере (F21), одна — ревью кода (F19).

## 3. Что проверено и что нет

| Проверено | Не проверено |
|---|---|
| формулы на независимой модели тела и датчика | настоящая плата, датчики, кабель |
| разбор потока на выводе самой прошивки (образцы от поддельных датчиков) | Web Serial с настоящим ESP32 |
| прошивка на компьютере и сборкой на двух ядрах | прошивка на плате |
| корпус: сетки и сборка в OpenSCAD | печать и примерка |
| приложение в Chrome на компьютере и в раскладке телефона | Firefox, WebKit, Safari, экранный диктор |
| | люди: добровольцы, реабилитологи, дети |

## 4. Ответы на вопросы задания

**Насколько точен прибор?** На модели в покое средняя ошибка 0,05–1,1° на восьми датчиках
с ошибками по даташиту, в быстром движении средняя квадратичная около 3°. На железе и людях —
неизвестно.

**Что было опаснее всего?** Тихие ошибки: число без пометки. Локоть при плече назад (F1),
замёрзший датчик (F5, F18), нули в выгрузке (F6), калибровка с движением (F7).

**Что изменилось в алгоритме?** Только локоть (поворот в шарнире) и проверки вокруг угла.
Версия алгоритма `nm-core 0.2.0`. Остальные формулы не трогались: эксперименты показали,
что они в пределах критериев.

**Какие ограничения остались?** Перекрёстная чувствительность датчика (около 1°), переразгибание
локтя при висящем плече, вальгус с пронацией (−8…−10°), углы как дуга от позы калибровки
(теперь видно в отчёте).

**Что делать Санжару?** Купить детали и пройти `HARDWARE_ACCEPTANCE.md`, особенно шаг 6:
станок с «плечом», отклонённым на 10°.

**Что делать команде?** Решить, какой проект главный; показать демо реабилитологам; задать
новые вопросы интервью (`STARTUP.md`, разделы 7 и 9).

**Как повторить проверки?** `npm test`, `npm run e2e`, `npm run experiments`, `npm run mutate`
в `website`; `test/run.sh` в `firmware`.

## 5. Что дальше

| Порядок | Что | Кто |
|---|---|---|
| 1 | Приёмка железа, шаги 1–6 | Санжар |
| 2 | Станок: «плечо» вертикально и с отклонением | Санжар, Амирхан |
| 3 | Показ демо двум реабилитологам | Малика |
| 4 | Добровольцы против гониометра (SMART M1, M2) | команда |
| 5 | Оси сустава по движению для F3 и F4, если станок подтвердит F4 | Амирхан |

## 6. После закрытия

Вечером 2 октября, при подготовке документа для команды, найдена F22: карточка пациента и отчёт для семьи
называли разную прибавку за курс (17° и 18°). Исправлено, добавлен сквозной тест: теперь 240 юнит-тестов
и 26 сквозных. Документ — `NeuroMove-бизнес-и-тех-план.docx`; исходники генератора документа в репозитории больше не хранятся.
