Amir10202010/neuromove/основа-и-план.md

# NeuroMove: научно-техническая основа и план развития

> Справочная версия научно-технического документа команды от 9 октября 2026 года.
> Текущую реализацию смотрите в README папок `website/`, `firmware/` и `hardware/`.

Прототип для оценки движений руки у детей с ДЦП.
Версия от 9 октября 2026 года.

*Документ фиксирует раннюю проектную основу; отдельные планы и состав участников могли измениться.*

## 1. Научно-техническая основа

### 1.1. Какую задачу решаем

Сейчас движения руки у ребенка с ДЦП оценивают по шкалам и ручным угломером - гониометром. Шкалы дают баллы, а не градусы. Гониометр у детей со спастическим ДЦП ошибается на 10-14° при повторном замере в тот же день и до 18-28° в разные дни [1]. Разные специалисты к тому же меряют по-разному [2]. Поэтому прибавку в 5-10° за месяц занятий врач просто не видит.

Мы делаем прибор, который меряет движения руки в градусах: подъем руки вперед и в сторону, сгибание в локте и наклон корпуса, которым ребенок помогает себе поднять руку. Прибор не ставит диагноз и не заменяет шкалы. Он добавляет к ним точные цифры и динамику по занятиям. В исследованиях носимые датчики и 3D-анализ движения тоже рассматривают как дополнение к клинической оценке руки при ДЦП [3, 4].

### 1.2. Физический принцип

Мы используем инерциальные датчики MPU-6050 на модуле GY-521. В одном чипе два прибора:

- акселерометр меряет ускорение. Когда рука не двигается, он видит силу тяжести и по ней понимает, как наклонен датчик. Со временем он не уплывает, но дергается при каждом рывке;
- гироскоп меряет скорость поворота. Он гладкий, но его ошибка накапливается, и угол понемногу уплывает.

Мы объединяем их фильтром. На каждом шаге поворачиваем прежнее направление «вверх» по гироскопу и на 2% подтягиваем его к акселерометру. Получается гладкий угол без дрейфа. Датчик опрашивается 100 раз в секунду, диапазоны - 4 g и 1000 °/с, встроенный фильтр датчика - около 44 Гц.

Магнитометр (компас) мы не используем. В зале реабилитации рядом металл: кровати, коляски, тренажеры, и компас там врет. Для угла в суставе он не нужен.

### 1.3. Как считаем углы

Перед тестом человек сидит прямо, руки вдоль тела, и 3 секунды не двигается. Это калибровка позы: углы в этой позе считаются нулем, а среднее показание гироскопа - его смещением, которое мы вычитаем весь тест. Если за эти 3 секунды было движение, калибровка повторяется.

| Что в отчете | Как считаем | Что проверили |
|---|---|---|
| Подъем руки вперед и в сторону | Угол между направлением «вверх» в датчике плеча сейчас и в позе калибровки. Не зависит от того, вперед, в сторону или по диагонали поднята рука. | На модели с перекосом ремешка на 2-5° средняя ошибка 0,1-1,5°, самая большая 3°. Простая формула по наклону одной оси датчика давала до 10°, поэтому мы ее заменили. |
| Сгибание в локте | Поворот в шарнире локтя. Ось шарнира берем из датчика на плече, углы плеча и предплечья считаем в плоскости этого шарнира. | Первая формула, разница наклонов плеча и предплечья, ошибалась до 41°, если плечо отведено назад или в сторону. Мы нашли это 2 октября на независимой модели и заменили формулу. Сейчас при отклонении плеча до 20° ошибка не больше 1,6°. |
| Наклон корпуса | Наклон датчика на груди от позы калибровки во время подъема руки. | Нужен, чтобы видеть, поднимает ребенок руку сам или помогает себе корпусом. |

### 1.4. Калибровка датчиков

У каждого MPU-6050 есть заводская ошибка нуля: до 50 мg по осям X и Y и до 80 мg по оси Z, а масштаб может отличаться на 3% [5]. Без поправок угол в покое ошибается в среднем до 4,2°, отдельные значения - до 6,5°. Поэтому каждый датчик один раз калибруем в шести положениях, это около 2 минут. Поправки хранятся в плате вместе с отпечатком датчика: если датчики перепутать местами, плата это заметит. С поправками средняя ошибка в покое - до 1,1°.

### 1.5. Показатели в отчете

| Показатель | Как считаем |
|---|---|
| Объем движения (ROM) | Наибольший угол в каждом повторе. В отчет идет медиана повторов, чтобы один неудачный повтор не портил число. |
| Повторы | Повтор засчитывается, когда угол поднялся выше 80% ожидаемого размаха и вернулся ниже 20%. Два порога не дают дрожанию руки считаться повтором. |
| Плавность | SPARC - мера плавности по профилю скорости [6]. Рывок (jerk) не используем: у детей с ДЦП он ненадежен [7]. |
| Компенсация корпусом | Наибольший наклон корпуса во время подъема руки, в градусах. |
| Симметрия | Объем движения слабой руки, деленный на объем сильной, в процентах. Нужен второй комплект датчиков, поэтому в прототипе на одну руку ее пока нет. |
| Качество записи | Каждый отсчет пронумерован, поэтому любая потеря видна. Если данных не хватает, отчет так и пишет, а не выдает число. |

Общий индекс MotorScore из питча мы пока не считаем. Его можно вводить только с открытой формулой и после сверки с оценкой врачей на пилоте.

### 1.6. Как устроен прототип

Три датчика стоят на груди, на плече и на предплечье. Они соединены проводами с платой ESP32 на поясе, а плата по USB-кабелю - с ноутбуком. У MPU-6050 только два адреса, поэтому на одной линии связи помещаются два датчика. Плечо и предплечье сидят на первой линии, грудь на второй. У ESP32 две такие линии.

Плата ничего не считает. 100 раз в секунду она отправляет сырые числа с каждого датчика и номер отсчета. Углы считает приложение в браузере Chrome. Так мы можем исправить формулу без перепрошивки платы и пересчитать старые записи. Сырые записи храним всегда, даже неудачные.

Имен в записях нет, только код участника. Данные не уходят с компьютера: в приложении нет кода, который отправляет их в интернет, и это проверено тестом.

Плата ESP32 и 4 датчика куплены 9 октября за 7 026 ₸. Весь стенд вместе с проводами, ремешками, корпусами с 3D-принтера и станком для проверки выходит около 11 тысяч тенге.

### 1.7. Что уже сделано и что еще не проверено

| Часть | Что сделано | Что еще не проверено |
|---|---|---|
| Приложение | Работает с 26 сентября на симуляторе датчиков: тест в реальном времени, отчеты, история занятий, отчет для семьи. 240 автоматических тестов и 26 сквозных. | Работа с настоящей платой. |
| Расчет углов | Проверен на независимой модели тела и датчика: 60 сценариев, 55 в пределах критериев, 5 - известные ограничения. В покое средняя ошибка 0,05-1,1°, в быстром движении около 3°. | Настоящие датчики и люди. |
| Прошивка платы | Готова с 2 октября: 108 проверок на компьютере с поддельными датчиками. Сборка под купленную плату проверена 7 октября. | Запуск на плате. |
| Корпус датчика | Модель для 3D-печати готова. | Печать и примерка. |

Известные ограничения формул: при переразгибании локтя с опущенным плечом и при вальгусе локтя вместе с поворотом предплечья ошибка может доходить до 8-10°. Мы показываем это в отчете и проверяем на станке.

### 1.8. Почему точность достижима

По обзору 66 работ, носимые датчики меряют сгибание локтя и запястья с ошибкой меньше 5°, если продумать крепление и калибровку. В сравнении с оптической системой на живых людях ошибка на локте бывает до 15° [8]. По метаанализу, сгибание локтя и поворот предплечья - самые трудные движения для таких датчиков [9]. Поэтому локоть мы проверяем первым и показываем с оговоркой, пока нет своих данных.

### 1.9. Как доказываем точность

Пороги мы записали до первого замера и после замера не меняем. Они совпадают с нашей SMART-целью.

| Проверка | Как | Порог |
|---|---|---|
| Станок | Две рейки на петле с известным углом: 0°, 30°, 60°, 90° и 120°, каждый угол 3 раза. Потом то же, когда «плечо» отклонено на 10° назад и в сторону. | Ошибка не больше 3° на каждом угле. С отклоненным плечом не больше 5°. |
| Добровольцы | 10 здоровых добровольцев по 3 повтора, рядом гониометр. | В среднем не больше 5°. |
| Повторяемость | Снять датчики, надеть заново и повторить. | Разница не больше 5°. |
| Время | Надеть датчики, откалибровать, пройти тест. | Не больше 15 минут. |
| Связь | 10 минут записи с резкими движениями. | Потерь меньше 0,1%. |

Точность мы доказываем на станке и на здоровых людях, а не на детях. У ребенка с ДЦП сам гониометр ошибается больше, чем наш порог [1]. На пилоте с детьми мы проверим другое: повторяемость, время и то, как дети переносят датчики.

### 1.10. Безопасность

- Прибор только измеряет. Никакого тока в тело.
- Стенд на проводах на детей не надеваем. Для детей будет беспроводная версия с аккумулятором в закрытом корпусе, без мелких деталей и острых краев.
- Датчики на человеке - только при враче или инструкторе.
- Прибор не ставит диагноз и не заменяет врача.

## 2. План развития

### 2.1. Задания трекера с 7 октября по 8 ноября

Для каждого задания мы заранее записали, что будем считать результатом.

| Задание и срок | Что делаем | Результат | Кто |
|---|---|---|---|
| 1. Закупить компоненты - до 11 октября | Плата ESP32 и 4 датчика GY-521 куплены 9 октября за 7 026 ₸. До 11 октября докупаем липучку 20 мм для ремешков, провода и термоусадку, около 1 800 ₸. Кабель для датчиков берем из старых USB-кабелей. | Все детали стенда на руках. | Санжар |
| 2. Собрать прототип: железо и программа - до 16 октября | Прошиваем плату и проверяем ее без датчиков. Паяем кабели прямо к датчикам и подключаем их к плате. Калибруем каждый датчик в шести положениях. Подключаем плату к приложению по USB. | Приложение видит 3 датчика из 3. Запись 60 секунд без потерь, это 6 000 отсчетов. Угол в локте меняется вживую, когда сгибаем руку. | Санжар - железо, Амирхан - подключение к программе, Арман - консультация |
| 3. Апробировать демо на Санжаре, Амирхане и Малике - до 23 октября | Каждый надевает датчики, проходит калибровку и тест: подъем руки вперед, в сторону и сгибание в локте, по 3 раза. Потом снимаем датчики, надеваем заново и повторяем. Засекаем время и записываем все проблемы. | Тест у каждого записан полностью. Время с надеванием не больше 15 минут. После переодевания датчиков угол отличается не больше чем на 5°. Если не уложились, записываем, сколько вышло. | вся команда |
| 4. Рабочая демонстрация сгибания локтя и других показателей - 23-30 октября | Проверяем точность на станке. Показываем вживую угол в локте, число повторов, объем движения, наклон корпуса и плавность. Снимаем видео демонстрации. | Станок: ошибка не больше 3° на каждом угле, с отклоненным плечом не больше 5°. Видео на 1-2 минуты: датчик на руке, угол на экране. | Санжар и Амирхан |
| 5. Апробация на реальном кейсе под присмотром реабилитолога - до 8 ноября | Реабилитолог сам проводит тест: надевает датчики, калибрует, смотрит отчет и сравнивает угол со своим гониометром. Мы записываем время, проблемы и его ответы: какое решение он принял бы по отчету и какая прибавка в градусах для него важна. | Тест прошел полностью при специалисте. Записаны его отзыв и разница с гониометром. Это первый из трех специалистов для нашей SMART-цели. | Малика договаривается со специалистом до 30 октября, на встрече вся команда |

Кого меряем 8 ноября. Стенд на проводах на ребенка мы не надеваем, это наше правило безопасности. Поэтому реальный кейс - это взрослый: сам специалист, его коллега или взрослый пациент с письменным согласием. Детей меряем только на пилоте после 11 декабря, беспроводными датчиками, с согласием родителей и одобрением центра. Если трекер ждет кейс с ребенком, это надо заранее обсудить с ним и с центром.

С 20 октября по 10 ноября у Амирхана школьный этап олимпиады по информатике и подготовка к нему. Поэтому программа должна заработать с платой до 16 октября. Дальше Амирхан только исправляет ошибки, а стенд ведет Санжар.

### 2.2. До Demo Day 11 декабря

| Срок | Что делаем | Результат |
|---|---|---|
| 9 ноября - 4 декабря | Проверяем точность на 10 здоровых добровольцах против гониометра и повторяемость. Печатаем корпуса датчиков. Показываем демо еще минимум двум специалистам, хотя бы один из них из Астаны. | Результат проверки записан, даже если порог не выполнен. Есть отзывы трех специалистов. |
| до 4 декабря | Договариваемся с центром в Астане о пилоте. | Письмо центра о пилоте на 5-10 детях: дата начала, условия, ответственный специалист. |
| 11 декабря | Demo Day. | Демонстрация вживую, результаты проверки точности, письмо центра. |

### 2.3. После Demo Day

| Когда | Что делаем | Зачем |
|---|---|---|
| декабрь - январь | Собираем один пробный беспроводной блок: плата ESP32-C3 Super Mini, датчик, аккумулятор 300-500 мА·ч, модуль зарядки с защитой, закрытый корпус. Проверяем связь и время работы, потом собираем 3 блока. | Безопасная версия для детей. Цель: потерь не больше 1% на расстоянии 3 м и 2-3 часа работы без зарядки. |
| январь - март 2027 | Пилот на 5-10 детях с ДЦП от 4 лет, уровни MACS I-III, в центре Астаны. При враче, с согласием родителей и одобрением центра. | Доля полных записей, время теста, как дети переносят датчики, повторяемость у детей, отзывы врачей. |
| после пилота | Вторая рука и симметрия, отчет в PDF на казахском и русском. MotorScore - только если его формула совпадет с оценкой врачей. | Готовый продукт для центра, а не прототип. |
| до продажи | Разбираемся, считается ли прибор медицинским изделием и как его регистрировать в Казахстане. | Продавать центрам можно только после этого. |

Пилот не докажет, что ребенку стало лучше благодаря прибору. Он покажет, что прибор меряет точно и повторяемо и укладывается во время приема.

### 2.4. Риски плана

| Риск | Что делаем |
|---|---|
| Датчик или плата пришли нерабочими. | Один датчик запасной. Плата и датчики есть в AmperMarket в Астане, их можно купить в тот же день. |
| Провод отходит, когда рука двигается. | Паяем, закрываем термоусадкой, у корпуса прихватываем стяжкой. Плата сама перезапускает связь и считает потери. |
| Датчик съезжает на руке, и угол меняется от надевания к надеванию. | Ставим метки маркером, затягиваем ремешок, датчик предплечья ставим ближе к запястью. Проверяем, надевая датчики 5 раз подряд. |
| Станок не проходит порог 3°. | Записываем результат как есть. Проверяем, как стоят датчики и откалиброваны ли они. Если нужно, находим ось локтя по самому движению, как в статье [10]. |
| Нет реабилитолога к 8 ноября. | Малика договаривается заранее, до 30 октября. Запасной вариант - специалист из нашего списка в Астане или врач «Aspasia» по видеосвязи. |
| У Амирхана мало времени с 20 октября. | Программа работает с платой до 16 октября. Дальше нужны только исправления. |

### 2.5. Бюджет

Бюджет команды - 25 тысяч тенге. На плату и датчики потрачено 7 026 ₸. Еще около 4 тысяч уйдет на ремешки, провода, термоусадку, печать корпусов и станок, так что весь стенд стоит около 11 тысяч. Остаток, около 14 тысяч, идет на пробный беспроводной блок.

## Источники

1. McDowell B.C., Hewitt V., Nurse A., Weston T., Baker R. The variability of goniometric measurements in ambulatory children with spastic cerebral palsy. Gait & Posture, 2000, 12(2), 114-121. https://pubmed.ncbi.nlm.nih.gov/10998607/
2. Herrero P. и др. Reliability of goniometric measurements in children with cerebral palsy: A comparative analysis of universal goniometer and electronic inclinometer. A pilot study. BMC Musculoskeletal Disorders, 2011, 12:155. https://pmc.ncbi.nlm.nih.gov/articles/PMC3160434/
3. Mailleux L. и др. Clinical assessment and three-dimensional movement analysis: An integrated approach for upper limb evaluation in children with unilateral cerebral palsy. PLOS ONE, 2017, 12(7), e0180196. https://doi.org/10.1371/journal.pone.0180196
4. Francisco-Martínez C. и др. Upper Limb Movement Measurement Systems for Cerebral Palsy: A Systematic Literature Review. Sensors, 2021, 21(23), 7884. https://www.mdpi.com/1424-8220/21/23/7884
5. InvenSense. MPU-6000 and MPU-6050 Product Specification, PS-MPU-6000A-00, rev. 3.4, раздел 6.2. https://www.radiolocman.com/datasheet/pdf.html?di=102365&p=12
6. Balasubramanian S., Melendez-Calderon A., Roby-Brami A., Burdet E. On the analysis of movement smoothness. Journal of NeuroEngineering and Rehabilitation, 2015, 12, 112. https://link.springer.com/article/10.1186/s12984-015-0090-9
7. Vanmechelen I. и др. Reliability and Discriminative Validity of Wearable Sensors for the Quantification of Upper Limb Movement Disorders in Individuals with Dyskinetic Cerebral Palsy. Sensors, 2023. https://pmc.ncbi.nlm.nih.gov/articles/PMC9921560/
8. Walmsley C.P. и др. Measurement of Upper Limb Range of Motion Using Wearable Sensors: A Systematic Review. Sports Medicine - Open, 2018, 4, 53. https://pmc.ncbi.nlm.nih.gov/articles/PMC6265374/
9. Li J. и др. Concurrent validity of inertial measurement units in range of motion measurements of upper extremity: A systematic review and meta-analysis. Wearable Technologies, 2024. https://www.cambridge.org/core/journals/wearable-technologies/article/concurrent-validity-of-inertial-measurement-units-in-range-of-motion-measurements-of-upper-extr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
10. Seel T., Raisch J., Schauer T. IMU-Based Joint Angle Measurement for Gait Analysis. Sensors, 2014, 14(4), 6891-6909. https://doi.org/10.3390/s140406891
