Amir10202010/neuromove/website/docs/DEMO.md

# NeuroMove — сценарий показа

Состояние на 17 октября 2026. Два сценария: короткий, 3 минуты по гиду, и полный, 7 минут для
трекера и жюри. Все цифры на экране принадлежат демо-пациентам и **воспроизводимы**: история каждого
посчитана симулятором с зерном `ключ ребёнка + номер сеанса + зерно движений` (`data/seed/demo.ts`),
поэтому после «Сбросить демо» на экране те же числа (даты сдвигаются на сегодня). Ключ P01–P06
внутренний: на экране у детей имена, и от имени числа не зависят.

Что это демо, на экране говорит только тёмная полоса сверху. Пометок «Демо-данные» и «Симулятор»
на экранах нет, гид не повторяет «это симуляция». Сказать вслух, что ребёнок и датчики
смоделированы, ведущему стоит один раз, в начале (шаг 1). Второстепенное (протокол, диагноз,
длительность, полнота записи) лежит за «Показать подробности»: открыть, если спросят.

Подготовка за 10 минут — `docs/DEPLOYMENT.md`, раздел 8.

## Демо-пациенты — что на ком показывать

Все вымышлены, данные смоделированы тем же движком, что и живой тест.

| Ребёнок (ключ) | История | Что показать |
|---|---|---|
| Алихан (P01) | 8 лет, гемиплегия справа, 9 сеансов, рост 127° → 144° | главный путь, гид, отчёт для семьи |
| Айша (P02) | плато | наблюдение «плато»: 4 сеанса в пределах 6° |
| Нурислам (P03) | обе стороны, потери связи | полнота записи, качество данных |
| Томирис (P04) | откат после перерыва | наблюдение «откат к прошлому сеансу» |
| Данияр (P05) | только исходный тест | что видно после первого визита |
| Амина (P06) | новый пациент | пустые состояния: истории ещё нет |

## Сценарий 1 — 3 минуты, по гиду

Гид не дублирует кнопки приложения. На каждом шаге светлым остаётся только то, о чём он говорит,
остальное приглушено; рядом — подсказка: заголовок и не больше одной короткой фразы. Если шаг
просит действие, заголовок говорит, что сделать («Начните тест»), а настоящая кнопка обведена
киноварью. Если шаг только объясняет — в подсказке «Далее».

| # | Что нажать | Что сказать | Что на экране |
|---|---|---|---|
| 0 | Стартовая страница, «Попробовать демо» | «Сейчас за три минуты проведём тест руки, как специалист на занятии» | вступление: одна фраза и три кадра (пациент, тест, итог), кнопка «Начать» |
| 1 | «Начать», затем «Далее» в подсказке | «Это демо: ребёнок и датчики смоделированы. Алихану 8 лет, правая рука слабее» | светлая карточка «Главное» с тремя рисунками, подсказка «Карточка пациента» |
| 2 | обведённая «Начать тест» в шапке пациента | «Проведём сегодняшний тест» | светлая — одна кнопка, подсказка «Начните тест» |
| 3 | обведённая «Надеть датчики» | «Быстрая проверка: подъём руки и локоть, сначала здоровой рукой» | светлый — план из 4 шагов со значками движений, подсказка «Наденьте датчики» |
| 4 | обведённая «Начать тест», когда все датчики на связи | «Пять датчиков выходят на связь: зелёные огоньки» | схема тела с выносками, справа три пункта подключения; кнопка обводится, когда все пять на связи |
| 5 | в подсказке «Показать обрыв связи» | «Угол в реальном времени. Если связь рвётся, тест встаёт на паузу, прерванный повтор не засчитывается» | калибровка 3-2-1, угломер и фигурка; «Связь с устройством потеряна» → «Связь восстановлена» → «Продолжить» |
| 6 | дождаться конца теста, «Далее» | «Итог одной фразой и строка на движение» | светлый итог сеанса |
| 7 | «Далее» | «Сегодняшний сеанс уже в динамике курса» | светлая — карточка «Главное» с обновлёнными числами |
| 8 | «Готово» | «Кто прибавляет, у кого плато и откат» | список пациентов, затем итог гида «Вы прошли весь путь» и «Пройти ещё раз» |

Тест вживую идёт около минуты (замер 14 октября: 55 с от «Начать тест» до отчёта). Гид переживает
перезагрузку страницы: если вкладку случайно обновили, он продолжит с того же шага. Если ведущий
ушёл с шага на другой экран, гид так и скажет — «Вы ушли с шага…» — и вернёт кнопкой «Вернуться к шагу».

## Сценарий 2 — 7 минут, трекер и жюри

**0:00 — проблема (стартовая страница).** «Сегодня руку ребёнка с ДЦП оценивают на глаз и угломером.
Угломер у таких детей расходится на 10–14 градусов между замерами (McDowell, 2000). Врач видит
„кажется, лучше“ — а прибавка в 5 градусов теряется в ошибке.» Показать сцену «На глаз — NeuroMove».

**0:45 — честно о стадии.** Прокрутить до «Честно»: «Это прототип. Датчики — симулятор, железо
собирает команда, фото — концепт. Точность на людях — следующий шаг.»

**1:15 — живой тест.** Сценарий 1, шаги 1–5. На обрыве связи: «Вот так он ведёт себя в кабинете,
где ребёнок отошёл дальше, чем ловит Bluetooth».

**3:30 — отчёт.** Отчёт сеанса → «Показать подробности»: таблица «движение × сторона», SPARC,
запись угла каждого шага. «Каждую фразу черновика можно сверить с таблицей. ИИ здесь нет.»

**4:30 — семья.** «Отчёт для семьи», затем печать: крупно, простыми словами, на бумаге водяной знак «ДЕМО» (на экране его нет).
«Выводы делает врач.»

**5:15 — доверие к данным.** Заранее, до показа: в отчёте сеанса, записанного вживую в демо,
«Показать подробности» → выгрузка сырых данных CSV (у сгенерированной истории сырых данных нет,
кнопка неактивна). Файл получит имя `neuromove-DEMO-Алихан-….csv`. На показе: «Настройки» → «Клиника»
(в первый раз — онбординг из 4 шагов) → «Новый тест» → «Показать подробности» → источник «Запись CSV»
→ этот файл. На экране: «Это запись из демо: данные смоделированы. В пространство клиники её
загрузить нельзя.» — «Демо никогда не смешивается с настоящими детьми.»

**6:15 — что дальше.** «Датчики» → «Проверка точности» → «Пример: станок на симуляторе» → «Посчитать»:
«Этим инструментом посчитаем точность на стенде. Запись с датчиков, на каждом угле станка — отметка,
на выходе таблица „эталон — прибор — ошибка“ и итог против порога 5°, записанного до замера.
Сейчас это симулятор — так и написано: проверены формулы, а не прибор». SMART v2: стенд из трёх датчиков и ESP32-S3,
проверка на станке и десяти добровольцах к 11 декабря; пилот на 5–10 детях — с согласием родителей
и этическим комитетом центра. Цифр точности на людях не показывать — их ещё нет.

## Если что-то пошло не так

| Что | Что сделать |
|---|---|
| Экран не грузится дольше 5 с | приложение само перейдёт на работу в памяти; показ продолжается |
| Случайно закрыли вкладку посреди теста | открыть снова → «Сеанс был прерван» → «Продолжить сеанс» |
| Демо «испорчено» прошлым показом | «Сбросить демо» в тёмной полосе — мгновенно |
| Нет интернета | `demo/NeuroMove.html` с диска, всё внутри |
| Файл открылся в Safari (на маке так по умолчанию) | Safari не проверяли. Закрыть, правой кнопкой по файлу → «Открыть в программе» → Google Chrome |
| Гид мешает | «Свернуть» (стрелка вниз) в подсказке — затемнение уходит; вернуть — кнопка «Гид · N/8» внизу справа |
| Ушли с шага на другой экран | в карточке гида — «Вернуться к шагу»; если тест уже закрыт — «Начать тест заново» |
| Нужно показать ещё раз | в итоге гида — «Пройти ещё раз»: демо сбросится и откроется вступление |

## Вопросы, которые зададут, и честные ответы

| Вопрос | Ответ |
|---|---|
| Насколько точно? | На симуляторе — ошибка 0.1–1.5°, пик ±3°. На людях не проверено: это первый пункт SMART, порог — не больше 5° против гониометра на здоровых добровольцах |
| Почему не на детях проверяете точность? | У детей с ДЦП сам угломер ошибается на ±10–14°: против такого эталона точность не доказать. На детях проверим повторяемость и переносимость |
| Это медицинское изделие? | Нет, прототип для исследований. Он не ставит диагноз. Какой класс будет у прибора, решит экспертиза; правила — приказ МЗ РК ҚР ДСМ-281/2020 |
| Фото — ваше устройство? | Нет, концепт; так и подписано. Корпуса ещё нет |
| Где хранятся данные? | Только в браузере компьютера центра, без интернета; браузеру запрещено отправлять запросы (CSP). Пароля пока нет — сказано прямо в приложении |
| Чем вы лучше K-Move или Opal? | Не утверждаем, что точнее. Отличие — фокус: рука ребёнка с ДЦП, туловище, курс терапии, отчёт для семьи на казахском и русском, работа без интернета |
| Почему не камера? | Видео детей — чувствительные данные, а камера плохо видит поворот предплечья. Камера (OpenCap и др.) — хорошая альтернатива для исследований, мы её назвали в аналогах |
| Сколько стоит? | Стенд на одну руку — 14 850–18 850 ₸ (цены AmperMarket, 29 сентября). Цену продукта ещё не считали |
