Amir10202010/neuromove/website/docs/EXPERIENCE.md

# NeuroMove — дизайн и опыт

Как выглядит и ведёт себя NeuroMove и почему. Код — `src/features/welcome/` (стартовая страница),
`src/layout/`, `src/features/demo/` (вступление и гид), `src/figures/` (система рисунков),
токены — `src/styles/tokens.css`, стили рисунков — `src/styles/figures.css`.

## Что это сейчас

Прототип в браузере: модель движения даёт сырые сигналы датчиков, приложение считает углы,
повторы и метрики. Нейросигналов нет, ИИ нет, сервера нет, клинической проверки нет, датчики —
на симуляторе (настоящие — по контракту, на стенде не проверены). Всё, что на экране, должно
этому соответствовать: никаких партнёрств, отзывов, одобрений и «точности», которых нет.

## Стартовая страница: движение как на презентациях Apple — 18 октября 2026, ночь

Ночной проход «как у Neuralink» (в покое ничего не движется) Амирхан отверг: «верни анимации,
я хотел, чтобы сайт был как на презентации Apple». Откат — коммит `d5a703d`. Дальше — разбор
страниц Apple по кадрам и замерам (`REFERENCE_STUDY.md`, «Движение Apple») и движение по их
приёмам (`DESIGN_SYSTEM.md`, раздел 7): текст появляется подъёмом на 30 px, когда доходит до
82 % экрана; фото датчика раскрывается во весь экран; модель датчика, рука на листе отчёта
и рисунки движений идут вместе с прокруткой; планшет поднимается и встаёт; панель полупрозрачная.
Цвет и шрифты — прежние, как у Neuralink.

## Стартовая страница: рисунки и анимации — 18 октября 2026, вечер

Амирхан: «картинки, анимации и иллюстрации ужасно выглядят», страницу сократить. Референсы —
сайты носимых медицинских приборов (`REFERENCE_STUDY.md`, раздел «18 октября, вечер»), разбор
по блокам — `DESIGN_AUDIT.md`, тот же раздел.

| Было | Стало | Почему |
|---|---|---|
| Под планшетом три колонки текста с чёрными кружками-номерами, такие же кружки на экране | Тур: выбранный пункт подсвечивает свою часть экрана, полоса пункта заполняется; планшет с тонкой рамкой выпрямляется при прокрутке | номера читались как инструкция; подсветка показывает, о чём пункт, прямо на продукте |
| «Отчёт» и «Семьям» — две секции; на листе полоска «начало → сейчас → цель» | Одна секция «Семьям» с листом; на листе шкала угла с рукой | полоска — индикатор загрузки, к руке отношения не имеет |
| «Специалистам» — четыре мелких значка движений | Хронофотография каждого движения из модели: кадр каждые 0,1 с, след кисти, шкала, пик другой руки | значок говорит «какое движение», рисунок — «как рука его делает» |
| «Проверка» — график в осях; «Данные» — схема из рамок | Карточки: клин ошибки 41° → 1,6°, 60 точек сценариев, путь данных, шкала стенда ±5° | одно утверждение — одна карточка с инфографикой, как у Hinge Health |
| Все блоки появлялись одинаково: подъём на 32 px | У каждого рисунка свой жест; заголовки — словами из-под шторки | одинаковое движение везде выглядит шаблоном |

Сцен стало девять вместо одиннадцати, страница — 13 814 px вместо 15 514 на 1440 × 900.

Поздно вечером светлые секции стали чисто белыми вместо тёплой «бумаги», серые — нейтральными
(просьба Амирхана: «как у Neuralink»). Страница — белый, чёрный и киноварь. Приложение не меняли:
его экраны внутри планшета — в своих токенах.

## Стартовая страница: как у Neuralink — 18 октября 2026, утро

Амирхан отверг проход 17 октября (ниже): «выглядит как фигня», нужно «как в neuralink». Вернули
сцену «Как это работает» с разборной моделью датчика, тёмные секции стали чисто чёрными, заголовки,
подписи разделов и меню — по замерам neuralink.com (`REFERENCE_STUDY.md`, раздел «Замеры
Neuralink»; `DESIGN_AUDIT.md`, раздел «18 октября»).

| Было 17 октября | Стало | Почему |
|---|---|---|
| Прибор «Из сигнала в градусы» | Разборная модель датчика, четыре шага; серые тона модели без зелени | просьба Амирхана: модель ему нравилась |
| Графит `#191c1a` и текст цвета бумаги | `#000`, белый текст, серые подписи | «чисто чёрные, как в neuralink» |
| Заголовки 370, подписи разделов моно прописными | Заголовки 300, интерлиньяж 1,0; подписи 16 px обычным регистром | так у Neuralink, замерено в браузере |
| Меню по центру | Знак слева, разделы и пилюля «Демо» справа | так у Neuralink |

## Стартовая страница: «Протокол измерения» — 17 октября 2026

> Направление отвергнуто 18 октября (раздел выше). Сцена с прибором снята, остальное в таблице
> ниже — сделано и осталось.

Задание: довести страницу до уровня сильной технологической компании, без шаблонов «ИИ-лендинга»
и без выдуманного. Аудит — `DESIGN_AUDIT.md`, референсы — `REFERENCE_STUDY.md`, система —
`DESIGN_SYSTEM.md`. Экраны врача не перестраивали: простой вид, имена и «демо в одной полосе» —
решения Амирхана 15 и 17 октября.

| Было | Стало | Почему |
|---|---|---|
| Сравнение «на глаз / NeuroMove» не показывалось никогда: блок появлялся после загрузки данных, а наблюдатель появления его не видел | Наблюдатель замечает и поздние блоки | главный довод страницы был пустым местом (A1) |
| «Как это работает»: разборная модель корпуса на чёрном, синусоиды «для вида», 3 168 px | ~~Прибор «Из сигнала в градусы»~~ — снят 18 октября, модель вернулась | (A3) |
| Экран теста на странице — версия до 17 октября: «Алихан» в квадрате значка, «Симулятор», «Запись» | Раскладка простого вида приложения, выноски 1–3 к подписям | страница не должна обещать другой продукт (A2) |
| «Специалистам» — пять строк текста | Четыре движения рисунками системы, три строки | в разделе для врачей не было ни одного рисунка (A6) |
| «Честно» — четыре крупные строки и абзац статуса | «Проверка»: график ошибки локтя до и после правки из сырых данных 2 октября, три числа, линия времени с датами. «Данные»: схема границы «компьютер клиники» и правило браузера | доверие числами и схемой, а не словами (A5) |
| Телефон: фото на 60 % экрана, кнопки демо не видно | Заголовок, фраза и кнопка в первом экране 375 × 812 | A4 |

Что отвергли: кинематографичное видео и новые сгенерированные картинки (нет настоящей съёмки),
стены логотипов и «точность на людях» (нет), шрифт с засечками для «журнального» направления
(хуже проверен на казахских буквах, а смена шрифта переделала бы все экраны и демо).

## Направление «Инструмент» — 14 октября 2026

Задача: человек без объяснений за 10–15 секунд понимает, для чего NeuroMove, что сделать первым,
где главное действие, что происходит сейчас и какой будет результат. Палитра и знак прежние
(бумага, графит, киноварь); поменялись композиция, рисунки, состояния и демо.

### Референсы

| | Что взяли | Где у нас |
|---|---|---|
| **Linear** — основной ([linear.app](https://linear.app), [статусы задач](https://linear.website/docs/configuring-workflows.md)) | рабочая область — лист поверх рамки окна, меню на рамке; статус как геометрия — круг заполняется: пусто → сектор → галочка; крупный заголовок над мелкими метаданными; одна главная кнопка; быстрые ответы на действие | каркас (`layout.css`), статус-кольцо `StatusRing` у этапов, шагов теста, подключения, расписания; «Следующий пациент» на главной |
| **Teenage Engineering**, OP–1 field guide ([teenage.engineering/guides/op-1](https://teenage.engineering/guides/op-1)) | одна толщина контура на всех рисунках; светлая заливка, сплошной цвет — только у главного; один кадр — один факт; тонкие выноски с моно-подписями; действие нарисовано (палец, кабель) | вся система рисунков: фигура ребёнка, датчики на ремешках, схема с выносками, значки движений со стрелкой, кадры вступления |
| **Neuralink**, страница Technology ([neuralink.com/technology](https://neuralink.com/technology/)) | технология по одной части за раз: заголовок и одна-две фразы; видно, сколько разделов прошли; можно пропустить | вступление к демо из трёх кадров; этапы теста; лента гида; «Осмотреться без гида» |

Чужие логотипы, тексты и иллюстрации не копировались: взяты принципы, рисунки нарисованы заново
по своей геометрии тела.

### Слои и цвет

Рамка окна и боковая панель `#eeebe4` → рабочая область — лист `#faf9f6` с отступом 8 px,
тонкой линией и скруглением 14 px → карточки белые, плоские, с линией `#e5e1d8` вместо тени.
Тень — только у того, что лежит поверх (окна, меню, уведомления, гид). Контраст текста проверен
на каждом слое: третий уровень `#5c6159` — не ниже 5:1. Цвета сторон тела — только у данных;
текст цветом стороны темнее отметок (`--left-text`, `--right-text`, не ниже 5.7:1 на белом).

### Типографика

Inter — текст интерфейса; **Inter Display** (ось оптического размера того же пакета) — заголовки
страниц, главные фразы, числа-приборы (угломер, обратный отсчёт, таймер); **JetBrains Mono,
прописные с разрядкой** — подписи разделов («ГЛАВНОЕ», «ШАГ 2 ИЗ 4», «СЛЕДУЮЩИЙ ПАЦИЕНТ»)
и выноски на рисунках: интерфейс и рисунки говорят одним голосом.

### Состояния

Каждый экран отвечает на три вопроса: что это (заголовок), что происходит (статус словами и
кольцом), что дальше (одна главная кнопка).

| Состояние | Как видно |
|---|---|
| Ждём (поиск, подключение) | кольцо пунктиром, у датчика — импульс, пока ждём |
| Идёт (этап, шаг, повторы) | кольцо с сектором — доля сделанного |
| Готово | заполненное кольцо с галочкой «встаёт на место»; светодиод датчика вспыхивает один раз |
| Нет устройства, ошибка | пунктирные датчики, красное кольцо с «!», текст причины и «Повторить» |
| Обрыв связи | светодиоды мигают красным, полоска попыток; восстановилось — зелёные огни и «Продолжить» |
| Пусто | рисунок из той же системы и что сделать: «Провести исходный тест», «Добавить пациента» |
| Ушли с шага демо | «Вы ушли с шага…» и «Вернуться к шагу» |

## Система рисунков (`src/figures/`)

Одна геометрия ребёнка лет восьми (`body.ts`): голова крупнее взрослой, рука до кончиков пальцев
примерно равна корпусу; сегменты — сужающиеся капсулы. Слой рисуется в два прохода: силуэт
тушью с обводкой в две толщины, поверх — заливка, поэтому плечо, предплечье и кисть сливаются
в один контур без швов (`Ink.tsx`, `InkLayer`). Контур не масштабируется
(`vector-effect: non-scaling-stroke`): 1,5 px и у значка 32 px, и у фигуры на весь планшет.

| Рисунок | Где | Что показывает |
|---|---|---|
| `RaiseProgress` | карточка пациента, «Следующий пациент», отчёт для семьи, вступление | подъём руки за курс: серый сектор — начало курса, цветной — прибавка, бледная рука — как было, ромб — цель; рука «выезжает» до угла один раз |
| `ArmsCompare` | карточка, строки отчёта | обе руки в одном движении по настоящим углам; неизмеренная рука — опущена и без цвета, а не «0°» |
| `TrunkLean` | карточка | помощь корпусом: пунктир — прямая спина, линия — спина сейчас, сектор — угол |
| `MoveIcon` | план сеанса, ход теста, «Следующий пациент» | поза в конце движения, бледная — в начале, пунктирная дуга со стрелкой — куда |
| `StickFigure` | тест вживую, лендинг | живая фигура 60 раз в секунду: сбоку (подъём, локоть), спереди (отведение), кулак с торца (поворот предплечья); наклон корпуса от 10° — жёлтая дуга |
| `BodyMap` | подключение, «Датчики», обрыв связи | ребёнок спереди, пять датчиков на ремешках с выносками и зарядом; состояние — светодиодом |
| `CalibrationFigure` | калибровка, загрузка демо, знакомство | поза калибровки внутри шкалы из 60 рисок, отвесная линия; пошевелился — риски желтеют, фигура вздрагивает |
| `StatusRing` | этапы, шаги, подключение, расписание, гид | статус одной фигурой |
| `EmptyArt` | пустые состояния | что здесь появится |

Все рисунки в одном месте и во всех состояниях — страница `#/lab` (только в режиме разработки,
в сборку не попадает).

## Движение

Движение показывает причину и следствие и заканчивается само.

- Датчик вышел на связь → светодиод вспыхивает один раз, пункт подключения закрывается галочкой,
  кнопка «Начать тест» становится доступной.
- Калибровка → риски заполняются за 3 секунды, отсчёт 3-2-1; движение → риски желтеют, фигура
  вздрагивает дважды, отсчёт заново.
- Рисунок итога → рука поднимается от «было» до «сейчас» за 0,7 с один раз.
- Подсветка блока гида пульсирует трижды и замирает; импульс у датчика — только пока ждём связи.
- Кнопка при нажатии проседает на 1 px — действие принято.

«Уменьшить движение» в системе — всё сразу на месте: импульсов, вздрагиваний и «выезда» нет.

## Демо

«Попробовать демо», затем вступление: одна фраза о том, что измеряет NeuroMove, три кадра пути
(пациент, тест, итог) с подписью в одно слово и одна кнопка «Начать».

Дальше — гид из восьми шагов **в виде подсказки у элемента** (`features/demo/Coach.tsx`). Первая
версия гида (14 октября) была карточкой над экраном со своей кнопкой действия. Отзыв 15 октября:
на экране сразу три «стартовые» кнопки (в гиде, в шапке, «Новый тест» в меню) и много текста —
непонятно, что читать и что нажимать. Теперь:

- всё, кроме блока, о котором говорит шаг, приглушено затемнением с «окном» (SVG-маска: окна над
  блоком и кнопкой могут перекрываться);
- подсказка стоит рядом с целью, со стрелкой к ней: под, над, справа или слева — где помещается
  и не закрывает подсвеченное; на телефоне — внизу экрана;
- если шаг просит действие, подсказка показывает на **настоящую** кнопку («Нажмите «Начать тест»»),
  кнопка обведена и пульсирует трижды; своей кнопки у гида нет — нажимать нечего, кроме нужного;
- если шаг только объясняет, в подсказке одна кнопка «Далее»;
- текст — одна-две короткие фразы; во время калибровки — своя фраза («три секунды неподвижно»).

Затемнение не ловит щелчки: по экрану можно ходить, гид заметит, что вы ушли с шага, и вернёт.
В конце «Вы прошли весь путь» с числами сегодняшнего теста и «Пройти ещё раз». Сценарий показа:
`DEMO.md`.

### «Демо» говорит одна полоса (15 октября)

Второй отзыв 15 октября: в демо на каждом шаге напоминали, что это демо, и объясняли симуляцию,
а пациента называли кодом «P01». Теперь о демо говорит **только тёмная полоса сверху**: «Демо»,
одна строка про симуляцию, «Гид», «Сбросить демо». Убрано:

| Где | Было | Стало |
|---|---|---|
| вступление | «Демо · около 3 минут», пометка «ребёнок и датчики смоделированы», «Начать демо» | «Около 3 минут», без пометки, «Начать» |
| подсказки гида | «ДЕМО · ШАГ 2 ИЗ 8», «Это пациент P01», «У P01 быстрая проверка» | «ШАГ 2 ИЗ 8», «Карточка пациента», «Сегодня быстрая проверка руки» |
| итог гида | «Демо пройдено», «Сегодняшний тест P01 сохранён» | «Вы прошли весь путь», «Сегодняшний тест сохранён» |
| карточка пациента, отчёт сеанса | значок «Демо-данные» | нет |
| тест вживую | значок «Симулятор» у кода пациента | нет |
| главная | «Добрый день, Демо-специалист», значок «Демо» у следующего пациента | «Добрый день», без значка |
| боковая панель | «Демо-пространство» под именем, «NeuroMove Kit · симулятор» | имя без подписи (в демо это «Врач-реабилитолог»), «Комплект NeuroMove» |
| загрузка | «Готовим демо-данные», «Симулируем N сеансов…» | «Открываем приложение», «Готовим карточки пациентов» |
| лист печати, отчёт для семьи | водяной знак «ДЕМО» на экране и на бумаге | только на бумаге: лист уходит из приложения без полосы |

Там, где слово «демо» нужно для дела, оно осталось: стартовая страница («Попробовать демо»),
меню пространств, «Настройки», отказ загрузить запись из демо в пространство клиники, имена
выгружаемых файлов `neuromove-DEMO-…`.

В текстах интерфейса нет длинного тире: фразы переписаны на двоеточие, запятую или точку на всех
трёх языках, пустая ячейка таблицы показывает короткое «–».

### Имена вместо кодов и простой вид (17 октября)

Третий отзыв: «не хочу, чтобы пациенты назывались P01, P02, P03», «Без имён: пациенты хранятся
по кодам — может, лучше не код», и список лишнего: протокол у последнего сеанса, «Чем меньше, тем
лучше», «Оранжевым отмечено…», «Около 3 минут», заголовок вступления, «вживую», «Сегодня быстрая
проверка…», «Нажмите «…»», «· поражённая», строка «Четверг, 15 октября · P01 · Правая рука»,
«≈ 2 мин вместе с калибровкой», «Запись», «Шаг завершён», строка диагноза в отчёте о сеансе.
И общее: «облегчи, чтобы кучи всего не было сразу».

**Имена.** Дети в демо — Алихан, Айша, Нурислам, Томирис, Данияр, Амина (вымышленные, только имя).
Значок пациента — две буквы имени («Ал»). В клинике поле «Код» стало «Имя» с подсказкой «Только
имя, без фамилии»; архивы и записи со старыми кодами читаются. Внутри у детей демо остался ключ
P01–P06: от него зависит зерно движений, поэтому числа демо не изменились.

**Простой вид.** Правило: на экране то, что нужно сейчас; второстепенное — за «Показать
подробности», один переключатель на всё приложение.

| Экран | Осталось | Ушло в подробности или убрано |
|---|---|---|
| вступление | одна фраза, три рисунка с подписью в одно слово, «Начать» | «Около 3 минут», заголовок-призыв, описание под каждым кадром |
| гид | номер шага, заголовок, одна фраза там, где она что-то добавляет | «Нажмите «…»» (кнопку показывает обводка), «Ждём все пять датчиков…», фраза на шагах-действиях |
| главная | приветствие, следующий пациент (имя, фраза, рисунок, «Начать тест»), расписание, «Требуют внимания» | цифры дня (в подробности), таблица «Как идут дела» (есть в «Аналитике»), диагноз и протокол у пациентов, план «≈ 2 мин», сноска о наблюдениях |
| карточка пациента | имя, возраст и диагноз, «Главное» с тремя рисунками, наблюдения | курс и следующий визит (в подробности), протокол у последнего сеанса, «Чем меньше, тем лучше» |
| пациенты | имя и возраст, последний сеанс, подъём руки, следующий визит | форма ДЦП, GMFCS/MACS, число сеансов, фильтр (в подробности) |
| новый тест | имя пациента, протокол, план из шагов, «Надеть датчики» | повтор пациента карточкой, подзаголовок, описания протоколов, «прошлый раз», датчики, «≈ 2 мин», строка с датой (в подробности или убраны) |
| тест вживую | имя, этапы, таймер, шаг, инструкция ребёнку, угломер, фигурка | протокол и диагноз в шапке, «Время записи», «Запись», «Шаг завершён», подпись под фигуркой, «Этап 1 из 4», «Дальше калибровка…», строка ожидания |
| отчёт о сеансе | дата, «Главное» и строка на движение, «Печать», «Отчёт для семьи» | протокол и «Завершён» (остались «Неполный» и «Из файла»), строка о пациенте, «· поражённая», «Запись полная · время · повторы» (видна только неполная), «Новый тест» (есть в меню), оговорка (в подробности) |
| сеансы | дата, имя, подъём руки, «Неполный», если так | протокол, длительность, полнота, статус, фильтр протокола (в подробности) |
| аналитика | одна фраза о группе и список | подзаголовок; выгрузка CSV и оговорка (в подробности) |

Ничего из удалённого не было единственным источником данных: всё есть в подробностях, в карточке
пациента или в печатном отчёте.

## Две версии страницы и как их свели — 28 сентября 2026

| | Прежняя (27 сен) | С другого компьютера (27–28 сен) | Итог |
|---|---|---|---|
| Страница | одна история в девяти сценах, три языка, цифры P01 из данных | сайт из семи страниц, только английский, портал выбора пространства | **история прежней страницы**, десять сцен |
| Первый экран | рисунок-скелет ребёнка | фото руки с датчиком | **фото** + шкала угла на локте |
| «Как это работает» | фигурка ребёнка спереди | разборная модель датчика | **модель**, шаги — прежние |
| Знак | угол в суставе на бирюзовом квадрате | два «сустава», метки киноварью | **новый знак** |
| Приложение | бирюза и фиолетовое демо | тёмно-зелёная панель, шрифт 8–12 px | **новая тема**: бумага, графит, киноварь |

## Принципы

- **Сначала человек и предмет, потом механизм.** Фото руки → датчик на ремешке → как он устроен →
  экран теста → отчёт.
- **Каждое число — из данных.** Цифры страницы и рисунков — демо-пациента P01, посчитанные теми же
  функциями, что в приложении.
- **Честные подписи.** «Концепт-изображение», «концепт корпуса», «демо работает на симуляторе».
- **Для обычного человека.** Одна главная кнопка на экране; на кнопках — действия простыми словами
  («Новый тест», «Надеть датчики», «Начать тест»); подписи гида и экрана совпадают; сложное —
  за «Показать подробности».

## Граница

Это рабочее место для показа и исследований, а не медицинское изделие. Перед клиникой нужны:
проверка на стенде против гониометра, согласия и этический комитет, разбор приватности
и безопасности, вход по паролю, резервные копии.
