Amir10202010/neuromove/website/docs/REFERENCE_STUDY.md

# Референсы — что посмотрели и что взяли

> **18 октября 2026 — поправка.** Направление, выбранное по этому разбору 17 октября, Амирхан
> отверг: страница «выглядит как фигня», нужно «как в neuralink». Я смотрел Neuralink, но взял
> у него доказательства с датами, а не язык страницы. Разбор ошибки и замеры neuralink.com —
> раздел «Замеры Neuralink, 18 октября» в конце; что изменилось на странице —
> `log/2026-10-18-neuromove-как-у-neuralink.md` в корне репозитория.

17 октября 2026. Каждый сайт открыт во встроенном браузере на 1440 × 900, первый экран и два-три
экрана ниже просмотрены глазами, у Neuralink прочитан текст страницы. Куки — отказ от необязательных.
Чужие тексты, логотипы, рисунки и раскладки не копировались: ниже принципы и то, как они
переносятся на NeuroMove.

## Что увидели

| Сайт | Что на самом деле на странице | Почему работает |
|---|---|---|
| [Neuralink](https://neuralink.com/) | Первый экран — съёмка устройства в работе, заголовок внизу слева, одна кнопка-«пилюля». Ниже — «пионеры»: настоящие люди с именем, диагнозом и датой операции. В конце две двери: «Пациенты и близкие» и «Инженеры» | Доказательство — люди и даты, а не эпитеты. Аудитории разведены |
| [Neuralink · Technology](https://neuralink.com/technology/) | Чёрный экран, разборная модель настоящего импланта, слева риски прогресса, «Skip This Section» | Одна часть за раз, можно пропустить. Но модель — их настоящий прибор |
| [Linear](https://linear.website/) | Крупный заголовок слева, под ним сразу настоящий интерфейс продукта. Абзац в два тона (главное — светлым, продолжение — серым). Три рисунка тонкой линией с подписями «FIG 0.1–0.3», между колонками волосяные линии, без карточек | Продукт и есть визуал. Подписи рисунков как в инженерном чертеже |
| [Vercel](https://vercel.com/) | Чёрно-белый, сетка из линий. Каждое утверждение привязано к клиенту и числу («Zapier… 100 million monthly visits») | Цифра с источником вместо прилагательного |
| [Stripe](https://stripe.com/) | В первом экране живое число («Global GDP running on Stripe: 1.7338…%»). У утверждения про банкинг сноска «¹». Видимые направляющие сетки. Настоящие экраны оплаты и график расхода | Живая цифра из системы. Сноска делает обещание точным |
| [Attio](https://attio.com/) | Светлая страница, интерфейс с правдоподобными данными. Слева список задач («Build pipeline», «Convert leads»), справа меняется экран продукта | Один экран продукта отвечает на один вопрос |
| [Ramp](https://ramp.com/) | Короткая фраза-обещание, продукт нарисован серыми схемами интерфейса, плитка «$1M+ saved» с именем клиента | Результат в деньгах с именем клиента |
| [Palantir](https://www.palantir.com/) | Кинематографичное фото на весь экран, серьёзный заголовок по центру, плитки историй с моно-категорией | Тон: серьёзно, без восклицаний |
| [Xsens](https://www.xsens.com/products/motion-capture) (Movella) | Ближайшая технология — датчики движения. Первый экран — CGI-персонажи и оранжевая кнопка, о датчиках ни слова | Пример того, чего не делать: технологию спрятали за картинкой |

## Что берём

| Принцип | Откуда | Как у NeuroMove |
|---|---|---|
| Живое число из самой системы | Stripe | Цифры страницы считаются функциями приложения на демо-данных; в сцене «Как это работает» — живой угол из модели движения. Прибор «Из сигнала в градусы» (17 октября) снят 18 октября |
| Сноска к каждой точности | Stripe | У каждой цифры точности строка «на модели, не на людях» прямо под графиком |
| Подписи рисунков как в чертеже | Linear | «Рис. 1», «Рис. 2» под графиком проверки и схемой данных: что это и откуда данные. С 18 октября — обычным шрифтом, не моно |
| Продукт как визуал | Linear, Attio | Экраны на странице — настоящие компоненты приложения на демо-данных |
| Доказательство с датами | Neuralink | Пациентов у нас нет. Есть журнал проверки: 26 сентября, 2 октября, 9 и 12 октября — что сделано, что нет |
| Аудитории разведены | Neuralink | «Семьям» и «Специалистам» — отдельные секции со своим языком |
| Волосяные линии вместо карточек | Linear, Vercel | Секции, таблицы и списки разделены линиями 1 px, не тенями |

## Чего не берём

| Что | Где видели | Почему не нам |
|---|---|---|
| ~~Разборная модель прибора на чёрном~~ | Neuralink Technology | 17 октября сцену сняли: корпус — концепт. **18 октября вернули**: Амирхану она нравилась, а подпись «схема-концепт датчика» говорит правду (аудит, A3) |
| Стены логотипов, «$1M+», число клиентов | Vercel, Ramp, Attio | У прототипа их нет. Выдумывать нельзя |
| Градиентные ленты, свечения | Stripe | Шум без смысла, спорит с бумагой и графитом |
| CGI и стоковые люди | Xsens | Прячут технологию |
| Кинематографичное видео на весь экран | Palantir, Neuralink | Настоящей съёмки нет. Сгенерированное видео было бы неправдой |
| Всплывающие промо поверх страницы | Vercel (Ship SF) | Закрывает содержание |

## Чем NeuroMove отличается после этого прохода

17 октября здесь было написано, что главное отличие — прибор «Из сигнала в градусы», алгоритм прямо
на странице. 18 октября прибор снят: на странице он читался как инженерный график, а не как
продукт. Остаётся одно отличие, и оно настоящее: страница показывает собственную найденную ошибку
(локоть до 41°) и как её исправили. Так говорит команда, которая проверяет себя раньше жюри.

## Замеры Neuralink, 18 октября

neuralink.com и neuralink.com/technology, 1440 × 900, стили прочитаны из браузера
(`getComputedStyle`), не на глаз.

| Что | Neuralink | NeuroMove с 18 октября |
|---|---|---|
| Фон тёмных секций | `#000` | `#000` (был графит `#191c1a`) |
| Фон светлых секций | `#fff` | `#fff` с позднего вечера 18 октября (была тёплая «бумага» `#f3f1eb`) |
| Текст на чёрном | белый; подписи серые `rgb(121, 121, 129)` | белый; приглушённый — 72 % белого; подписи `#86868e` |
| Шрифт | один, UntitledSans, на всё | Inter / Inter Display (кириллица и казахские буквы) |
| Заголовки шагов на Technology | 80 px, начертание 300, интерлиньяж 1,0, трекинг −0,06 em | `lp-d1` до 104 px, `lp-d2` до 76 px, 300, интерлиньяж 1,0–1,02, трекинг −0,05…−0,055 em |
| Заголовки секций на главной | 44 px / 300 | — |
| Подпись раздела («Implant», «Robot») | 16 px / 400, серая, обычным регистром | 16 px / 400, серая, обычным регистром (была моно, прописными, 11 px) |
| Абзац | 16–18 px, интерлиньяж 1,15–1,2 | 17–19 px, интерлиньяж 1,42 — кириллице нужно больше воздуха |
| Меню | знак слева; разделы и кнопка-«пилюля» с обводкой справа, 16 px | так же; «Демо» — пилюля с обводкой |
| Плотность | одна мысль на экран, много пустоты, крупный предмет | ближе, но ещё нет: 11 сцен и много списков (см. журнал 18 октября) |

Чего у нас нет и что не подделываем: съёмки настоящего устройства и людей. Neuralink держится
на них; у нас — концепт-фото с подписью и рисунки системы.

## 18 октября, вечер — сайты носимых медицинских приборов

Амирхан: «картинки, анимации и иллюстрации ужасно выглядят». Neuralink показывает имплант, у нас —
браслеты и цифры движения, поэтому смотрели тех, кто продаёт носимый прибор и данные о теле.
Снимки — Playwright 1440 × 900, по 7–9 экранов на сайт; куки — отказ от необязательных.

| Сайт | Что увидели | Что взяли |
|---|---|---|
| [Apple Health](https://www.apple.com/health/) | синий первый экран «Meaningful insights. Backed by science.»; дальше разделы по темам: значок, крупный жирный заголовок, абзац; под ним карусель карточек — экран часов или телефона, короткий текст и ссылка на исследование в PDF | у каждого утверждения сказано, откуда оно: «Независимая модель, не люди», «Один повтор из модели движения демо» |
| [Oura](https://ouraring.com/) | кремовый фон, заголовки с засечками, фото руки с кольцом; веер из пяти экранов приложения; «86% участников видят улучшение» со сноской, откуда число (опрос 3 501 человека); тёмный раздел о том, как Oura проверяет точность | число со сноской; раздел о точности — на тёмных карточках |
| [Whoop](https://www.whoop.com/) | огромный тонкий заголовок поверх макросъёмки материала; показатели прямо поверх фото людей: кольцо «45.8», линия с процентами, полосы сна | рисунок и число прямо на чёрном, без рамки графика и осей |
| [Hinge Health](https://www.hingehealth.com/) | тёмно-зелёный экран с точками шагов слева и фото с наложенными карточками справа; три карточки исследований с инфографикой: «2M+» — сетка точек, «68%» — дуга «нет боли → сильная боль», «47%» — столбики по месяцам | карточки «Проверки»: 60 сценариев — сеткой точек, ошибка локтя — дугой |
| [Sword Health](https://swordhealth.com/) | поверх фото человека в упражнении — скелет из линий и счёт повторов «9/10»; большое число экономии и карточки показателей со сносками | скелет из линий как язык движения; у нас он из модели движения и разложен кадрами во времени |
| [Linear](https://linear.website/) | заголовок слева, под ним крупно настоящий интерфейс продукта на тёмном | тур под планшетом: пункт внизу — его часть экрана подсвечена |

Не открылись: Withings (проверка Cloudflare «вы не робот» — проходить её не стали), Function Health
(страница не загрузилась за 2,5 минуты). Eight Sleep закрыла страницу всплывающим окном опроса —
видели только первый экран.

Собственный ход, которого нет у референсов: **хронофотография** движения по снимкам Этьена-Жюля
Марея (1880-е), рисунок — из модели движения демо, а не нарисован руками. Она показывает то, чего
не видно в одном числе: рука поднимается в два приёма, корпус помогает, другая рука выше.

## Движение Apple — замеры 18 октября, ночь

Амирхан: «я хотел анимации не как у Neuralink, а чтобы сайт был как на презентации Apple».
Страницы [Apple Watch Series 12](https://www.apple.com/apple-watch-series-12/) и
[iPhone 18 Pro](https://www.apple.com/iphone-18-pro/): видео непрерывной прокрутки (Playwright,
1280 × 800, ~450 px/с), кадры через 0,5 с, и стили из браузера на свежей странице.

**Появление текста** (заголовки «Heartcore innovation», «Ready. Set. Know», «Get the highlights»,
«Take a closer look» и абзац под ними; одинаково у всех):

| мс после того, как верх дошёл до 80 % экрана | 0 | 100 | 250 | 400 | 600 | 900 |
|---|---|---|---|---|---|---|
| прозрачность | 0,02 | 0,08 | 0,27 | 0,57 | 0,88 | 1,00 |
| сдвиг вниз, px | 29,2 | 25,9 | 16,4 | 5,8 | 0,0 | 0 |

То есть подъём на 30 px за ~0,65 с и прозрачность за ~0,8 с, обе с плавным разгоном и торможением
(близко к `cubic-bezier(.42, 0, .58, 1)`). Блок целиком: ни слов по одному, ни «шторок».

**Закреплённые сцены**: экран 100 % высоты, родитель на 1600–2000 px — то есть 850–1200 px
прокрутки на сцену («Witness your fitness», «Wearable AI Assistant», «Pro camera system»).
Внутри — видео или картинка, которую двигает прокрутка: макросъёмка камеры отъезжает до всего
блока камер, датчик часов вырастает во весь экран зелёным светом, рука на запястье становится
тепловой картой. Заголовок появляется посреди сцены.

**Ещё по кадрам**: скруглённые карточки с фото растут, подходя к середине экрана; телефон
поднимается снизу и поворачивается («Our finest unibody of work»); галереи карточек с точками
хода и кнопкой паузы; список «+ особенность» рядом с закреплённым устройством («Take a closer
look»); абзацы серым с выделенными белым словами; местная панель — полупрозрачная с размытием.

Что из этого взято и где — `DESIGN_SYSTEM.md`, раздел 7.
