Amir10202010/neuromove/website/docs/RESEARCH.md

# NeuroMove — исследование: доказательства, аналоги, требования

Собрано 1 октября 2026 на компьютере B. Метод: веб-поиск, затем каждая ссылка открыта —
текстом (WebFetch) или в браузере, если сайт закрыт от ботов (PubMed, MDPI, Wiley, adilet, Springer).
В таблице источников в конце — как именно проверено. Ничего не взято «по памяти».

Это инженерная записка. Раздел о регуляторике — не юридическое заключение, а список норм,
которые должен прочитать специалист, и гипотез, которые он подтвердит или нет.

---

## 1. Что NeuroMove утверждает и на чём это держится

| Утверждение | Статус | На чём держится |
|---|---|---|
| IMU-датчики могут мерить объём движений руки с ошибкой меньше 5° | **доказано в литературе, с оговорками** | Walmsley 2018: ошибка < 5° достижима при своей калибровке; вживую против оптического захвата — до 15° на локте. Li 2024: локоть и ротация плеча — самые трудные |
| Наш алгоритм даёт ошибку 0.1–1.5° (пик ±3°) | **проверено только на симуляторе** | `src/core`, тесты Vitest на модели MPU-6050 с шумом и перекосом крепления. На людях не проверено |
| Ручной угломер у детей с ДЦП ошибается на ±10–14° и больше | **доказано** | McDowell 2000 (ноги, спастический ДЦП): ±10–14° в тот же день, ±18–28° в разные дни; Herrero 2011: согласие разных специалистов низкое (ICC 0.38–0.48) |
| Цифры дополняют шкалы, а не заменяют их | **поддержано литературой** | Mailleux 2017: клиническая оценка и 3D-анализ движения вместе дают полную картину; 3D показывает отклонения в плече и локте, которых нет в шкалах |
| Плавность по SPARC | **метод из литературы** | Balasubramanian 2015; jerk в литературе ненадёжен и у детей с ДЦП (Vanmechelen 2023) |
| Пять датчиков, 100 Гц, надеть за минуту | **цель прототипа** | контракт imu-csv v1 и симулятор; железа нет, время надевания не мерили |
| «Работает» у детей с ДЦП | **неизвестно** | пилота не было; повторяемость у детей с ДЦП нужно мерить самим |
| Наблюдения (откат 10°, плато, наклон 12°) | **правила команды, не клиника** | пороги не согласованы с врачом |
| Данные не уходят с компьютера | **реализовано и проверено** | нет сетевого кода; CSP `connect-src 'none'`; тест Playwright: `fetch` заблокирован |

---

## 2. Доказательства по существу

### 2.1. Датчики против эталона — взрослые и здоровые

- **Walmsley и др., 2018**, *Sports Medicine – Open*. Систематический обзор: 66 работ. Против роботов
  ошибка ниже 5° по сгибанию локтя и запястья (местами 0.06–1.8°). Против оптического захвата
  вживую разброс больше — до 15° на локте. Вывод авторов: точность меньше 5° возможна, но только
  с продуманным креплением и калибровкой.
  **Для нас:** критерий «не больше 5°» на стенде реалистичен, но выполняется не «из коробки».
  Калибровка «руки вдоль тела» и подъём как угол между направлениями «вверх» (`core/pipeline.ts`)
  — это и есть та самая своя калибровка; её нужно проверить на людях.
- **Li и др., 2024**, *Wearable Technologies*. Метаанализ, верхняя конечность. Сгибание плеча:
  r = 0.969, средняя разница −3.19°. Сгибание локтя: r = 0.954, средняя разница 10.61°.
  Ротация плеча: средняя разница −9.13° (p < 0.0001). Пронация и супинация: ICC 0.821.
  **Для нас:** самые рискованные метрики — сгибание локтя и поворот предплечья. Их стоит проверять
  первыми и показывать с оговоркой, пока нет своих данных.
- **Poitras и др., 2019**, *Sensors*. Систематический обзор, 42 работы. Валидность выше на простых
  задачах; надёжность изучена мало.

### 2.2. Дети с ДЦП

- **Francisco-Martínez и др., 2021**, *Sensors*. Обзор 14 работ об объективной оценке объёма
  движений руки у детей с ДЦП 4–18 лет: оптические системы, носимые датчики, Kinect. Датчики
  и Kinect названы дополнением к клинической оценке.
- **Vanmechelen и др., 2023**, *Sensors*. Дискинетический ДЦП, датчики на плече, предплечье
  и кисти, 22 руки. ICC 0.50–0.98 при дотягивании вперёд и в сторону, 0.40–0.95 при
  «дотянуться и взять». Jerk и выборочная энтропия — наименее надёжны.
  **Для нас:** плавность считаем по SPARC, а не по jerk, — это совпадает с выводом. Но повторяемость
  у детей с ДЦП ниже, чем у здоровых, и порог «±5° через 10 минут» придётся проверить на пилоте.
- **Mailleux и др., 2017**, *PLOS ONE*. Односторонний ДЦП: клиническая оценка и 3D-анализ движения
  вместе дают «полное представление» о руке; 3D видит отклонения в проксимальных суставах,
  которых не видят шкалы. Это опора для позиции «дополняет шкалы».

### 2.2а. Локоть: что делает ребёнок и как считают угол — добавлено 2 октября 2026

Проверено при разборе находок F1 и F4 (`ENGINEERING_10H/FINDINGS.md`); каждая ссылка открыта в браузере.

| Утверждение | Источник |
|---|---|
| У детей с односторонним ДЦП при задаче «рука ко рту» плечо поднимается сильнее; с тяжестью (MACS) растут сгибание и пронация в локте вместе с отклонениями подъёма плеча и наклоном туловища | Mailleux L. et al. *PLoS ONE* 2017;12(7):e0180196, [doi:10.1371/journal.pone.0180196](https://doi.org/10.1371/journal.pone.0180196) |
| Угол вальгуса у здоровых детей 2–12 лет — 5,6–18°, в среднем около 12° | *Indian J Orthop* 2024;58(10):1479–1486, [PMC11420424](https://pmc.ncbi.nlm.nih.gov/articles/PMC11420424/) |
| Угол вальгуса растёт с возрастом (0,42–0,60° в год до 15 лет), у девочек больше на 1,3° | Balasubramanian P. et al. *J Pediatr Orthop B* 2006, PMID 16280718 |
| Угол шарнирного сустава по двум датчикам без магнитометра; ось сустава находится по самому движению; на теле ось датчика трудно совместить с осью сустава; ошибка около 3° на колене против оптики | Seel T., Raisch J., Schauer T. *Sensors* 2014;14(4):6891–6909, [doi:10.3390/s140406891](https://doi.org/10.3390/s140406891) |
| Локоть и предплечье как сустав с двумя степенями свободы: оси находятся автоматически из движения | Laidig D., Müller P., Seel T. *Curr Dir Biomed Eng* 2017;3(2), [doi:10.1515/cdbme-2017-0035](https://doi.org/10.1515/cdbme-2017-0035) |
| Параметры MPU-6050: ноль акселерометра ±50/±80 мg, масштаб ±3 %, перекрёстная чувствительность ±2 %, шум 400 мкg/√Гц и 0,005 °/с/√Гц; фильтр DLPF_CFG = 3 — 44/42 Гц, 4,9/4,8 мс | InvenSense PS-MPU-6000A-00 rev 3.1, разделы 6.1–6.2; RM-MPU-6000A-00 rev 4.0, регистр 26 |

### 2.3. Эталон сам ошибается — почему точность доказываем не на детях

- **McDowell и др., 2000**, *Gait & Posture*. 12 детей со спастическим ДЦП, три опытных
  физиотерапевта, ноги. Ошибка измерения в тот же день и в разные дни — ±10–14° (95% границы);
  для части суставов в разные дни — ±18–28°.
- **Herrero и др., 2011**, *BMC Musculoskeletal Disorders*. Один специалист повторяет себя хорошо
  (ICC 0.83–0.95), разные специалисты — плохо (ICC 0.38 и 0.48).

**Вывод для проекта:** против угломера у ребёнка с ДЦП точность прибора не доказать — эталон
ошибается сильнее, чем мы хотим. Поэтому в SMART v2 (`трекер.md`) точность — на здоровых
добровольцах и на станке, а у детей — повторяемость и переносимость.

### 2.4. Шкалы, рядом с которыми работает продукт

- **GMFCS** — Palisano и др., 1997, *Dev Med Child Neurol*: пять уровней крупной моторики.
- **MACS** — Eliasson и др., 2006, *Dev Med Child Neurol*: как ребёнок пользуется руками.
- **Melbourne Assessment 2** — Wallen, 2014, *Dev Med Child Neurol*: качество движения одной руки,
  уровень функции и структуры по МКФ, «лучшее возможное», а не повседневное.

В приложении GMFCS и MACS — поля карточки пациента; Melbourne Assessment 2 и AHA не
встроены — это инструменты врача, мы их не заменяем.

### 2.5. Масштаб

- **McIntyre и др., 2022**, *Dev Med Child Neurol*: в странах с высоким доходом —
  1.6 на 1000 живорождённых; по ограниченным данным из стран с низким и средним доходом —
  до 3.4 на 1000 (пре- и перинатальный ДЦП).
- **Казахстан:** 16 768 детей с ДЦП за 2018 год (newtimes.kz, 2019, пересказ «Хабар 24») и «порядка
  19 тысяч» (liter.kz, 2021, источник цифры не назван). Свежей официальной цифры в открытом доступе
  не нашлось: в динамических рядах Бюро национальной статистики отдельного ряда по ДЦП нет.
  **Цифру «больше 20 тысяч» из питча по-прежнему нечем подтвердить.**

---
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
