Amir10202010/neuromove/hardware/diagrams/схема-1-датчик.png

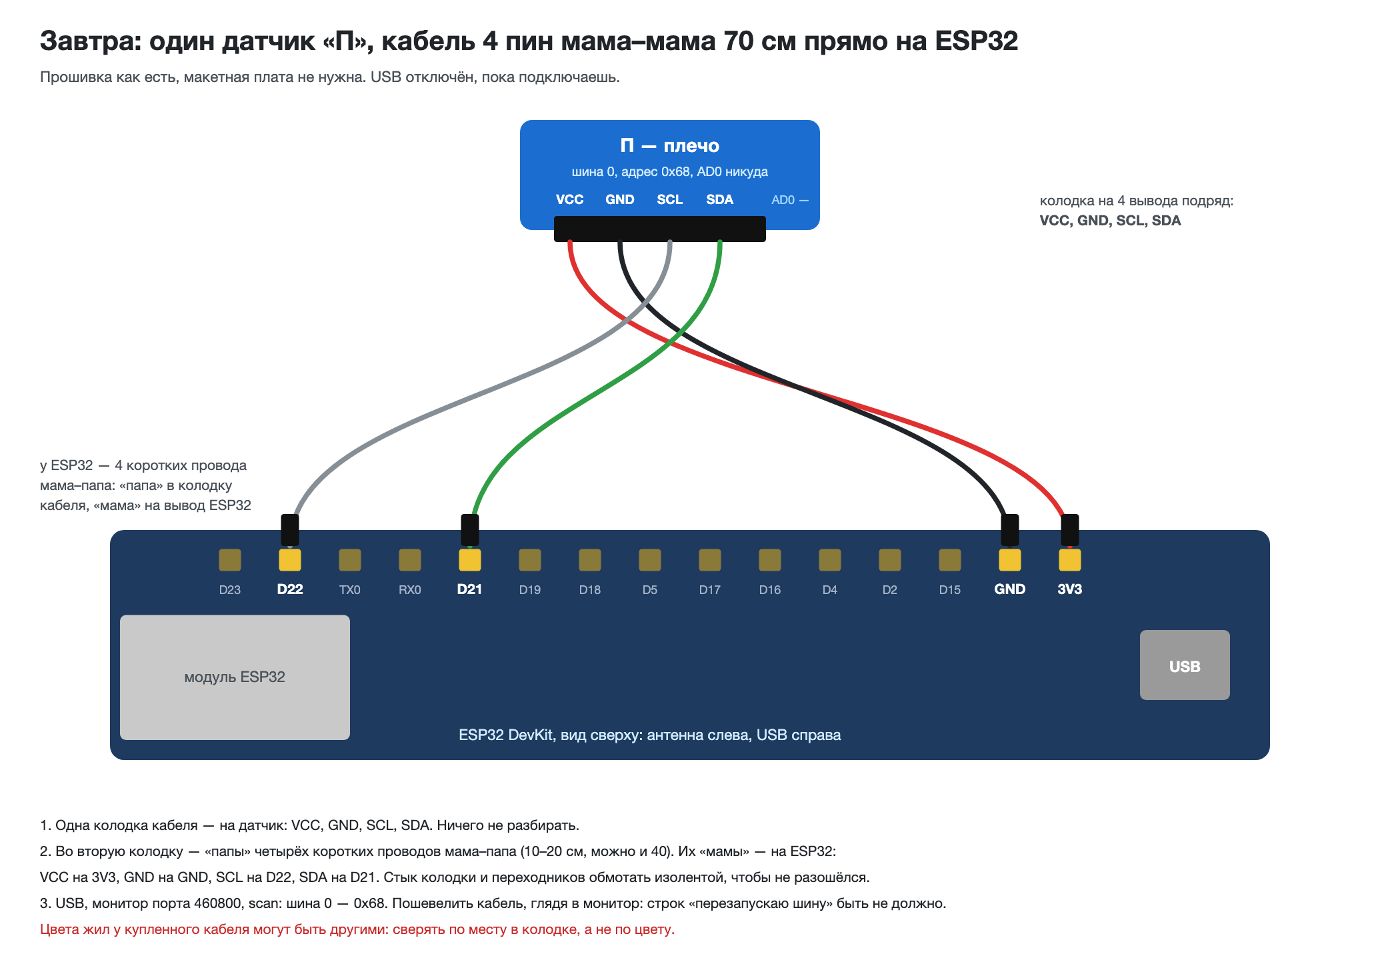
hardware/diagrams/схема-1-датчик.png
