Amir10202010/neuromove/hardware/diagrams/схема-без-пайки.png

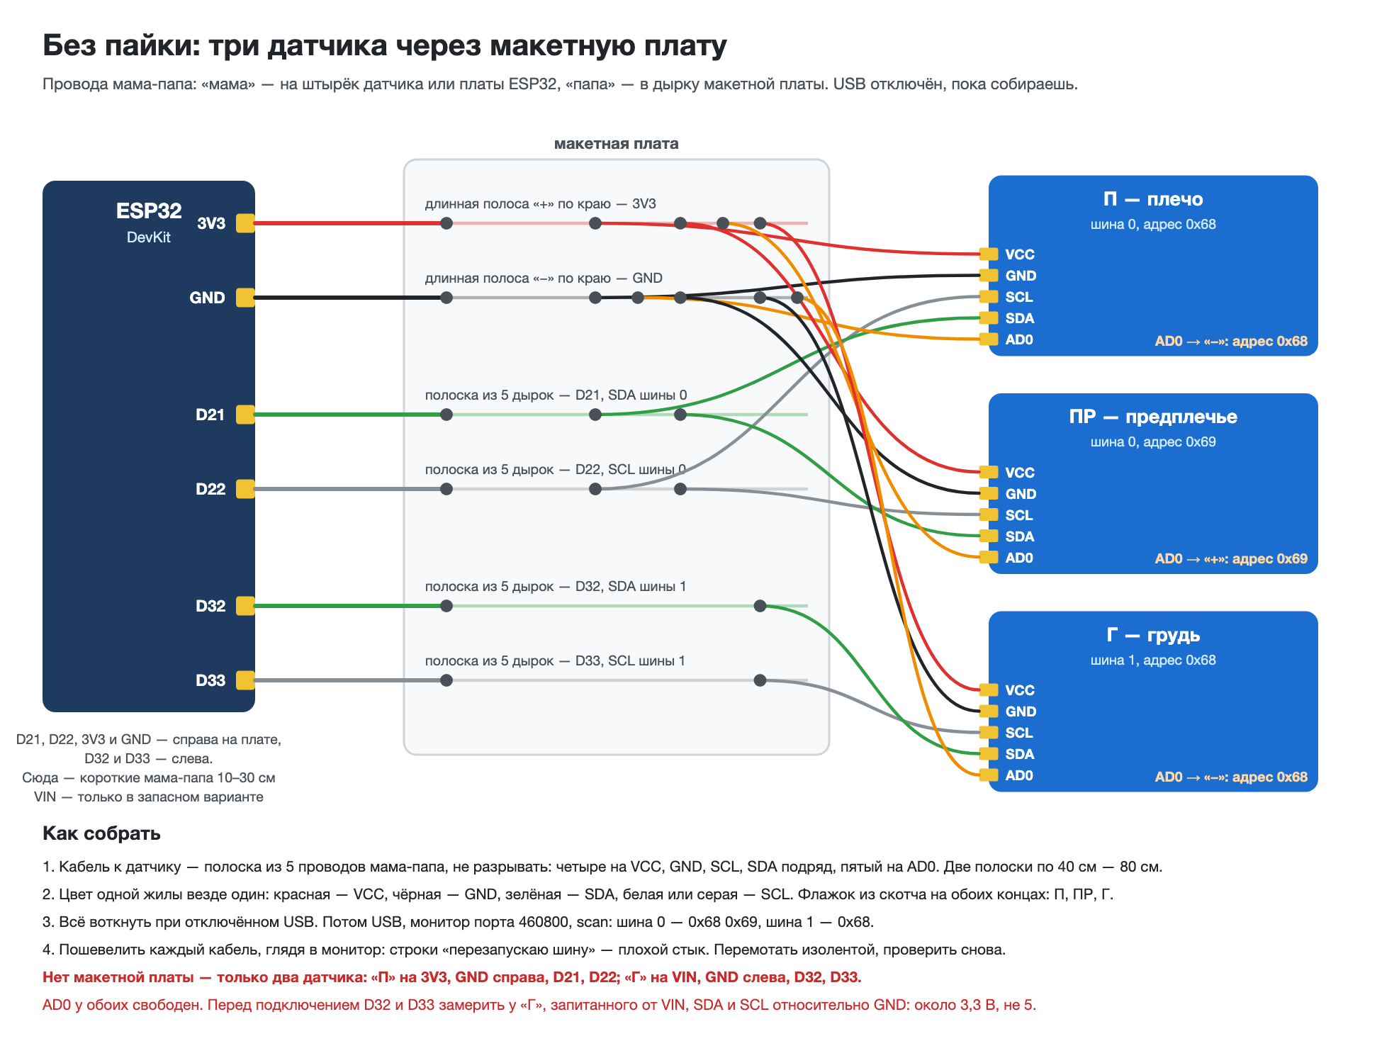
hardware/diagrams/схема-без-пайки.png
