Amir10202010/neuromove/hardware/diagrams/схема-стенда.png

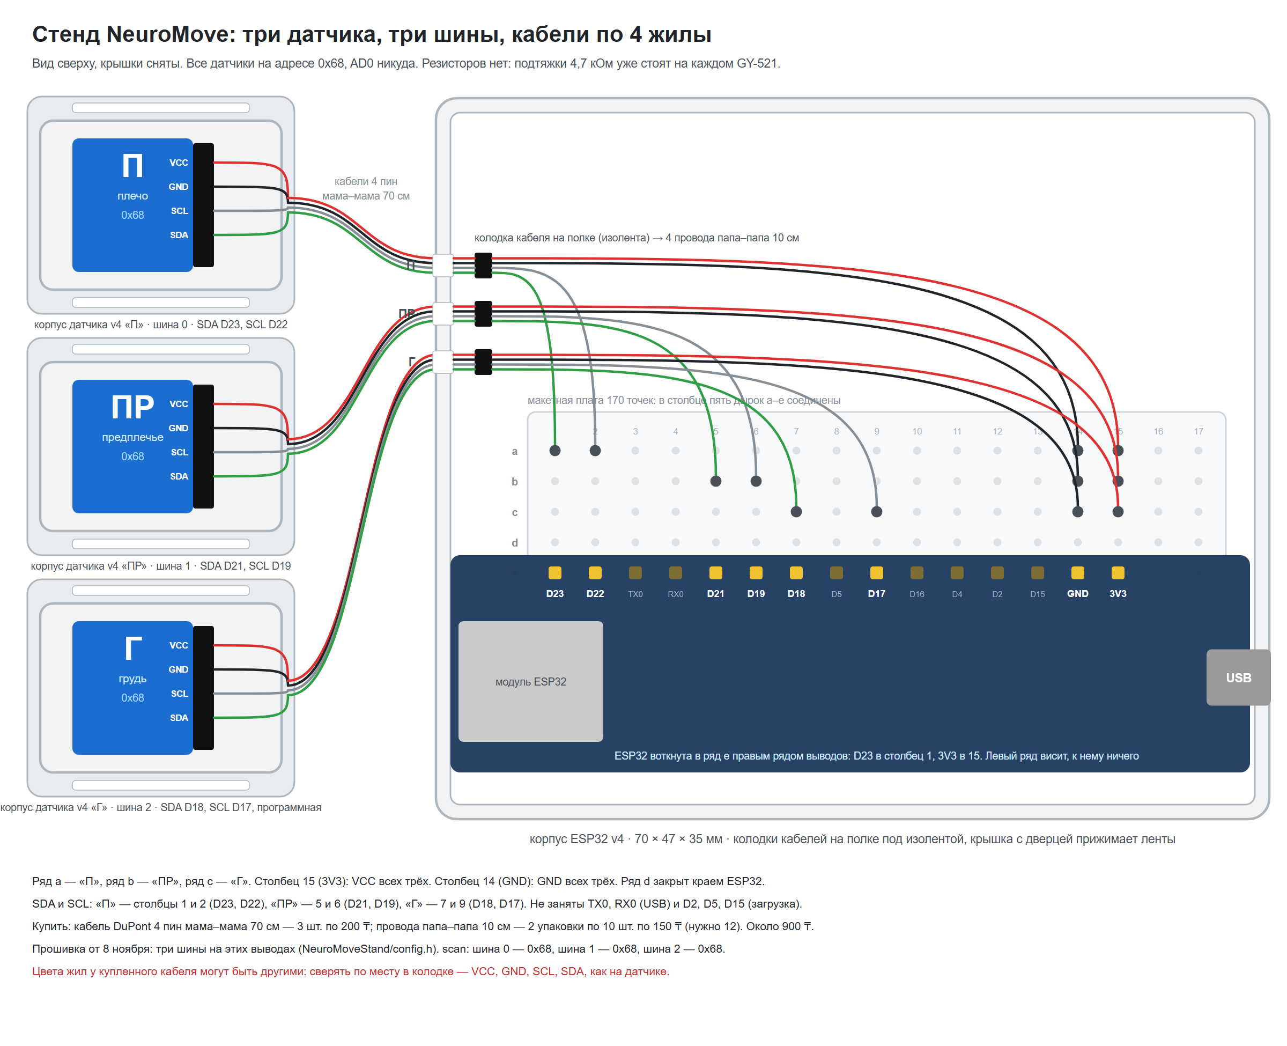
hardware/diagrams/схема-стенда.png
