Amir10202010/neuromove/hardware/models/enclosure/korpus-v3-datchik-vid.png

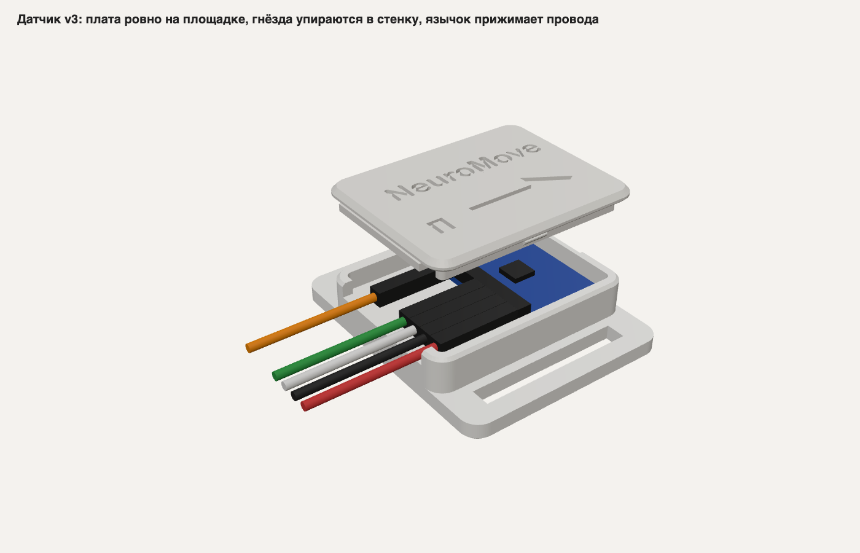
hardware/models/enclosure/korpus-v3-datchik-vid.png
