Amir10202010/neuromove/hardware/models/enclosure/korpus-v3-esp32-sverhu.png

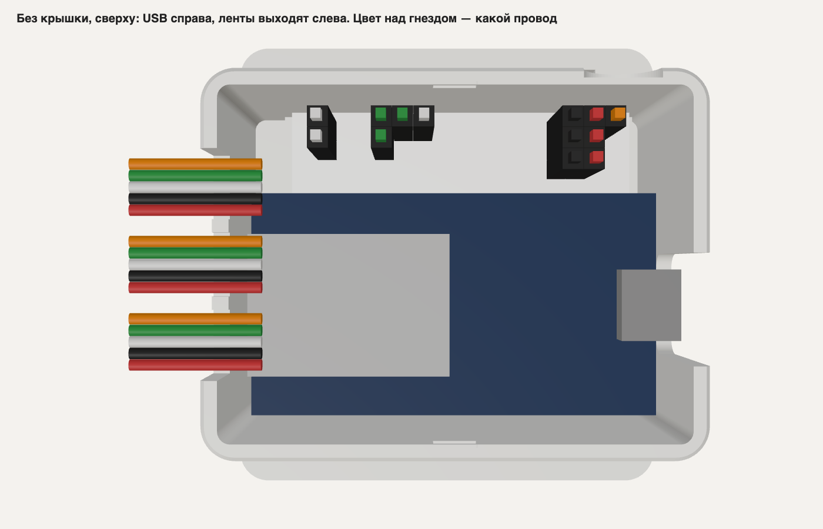
hardware/models/enclosure/korpus-v3-esp32-sverhu.png
