Amir10202010/neuromove/hardware/models/enclosure/korpus-v3-esp32-vid.png

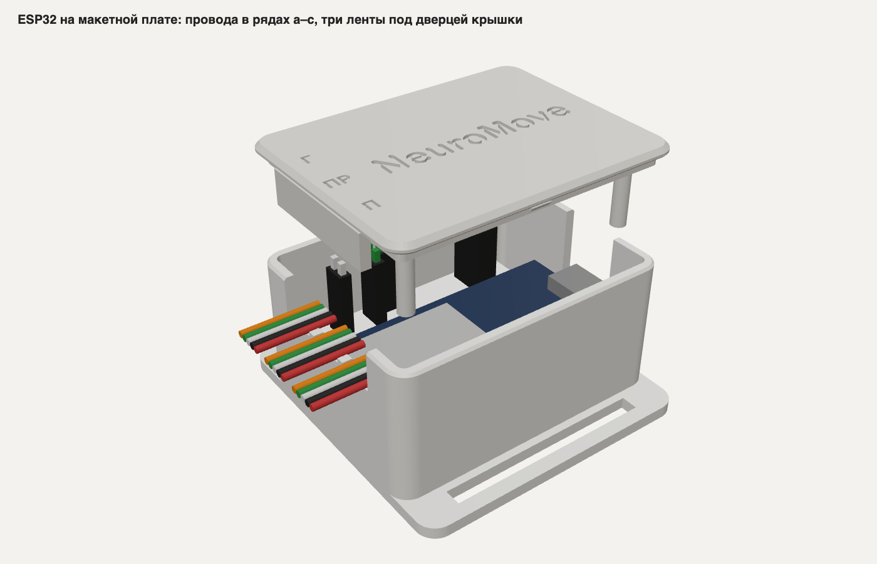
hardware/models/enclosure/korpus-v3-esp32-vid.png
