Amir10202010/neuromove/hardware/models/enclosure/korpus-v3-kryshki-sverhu.png

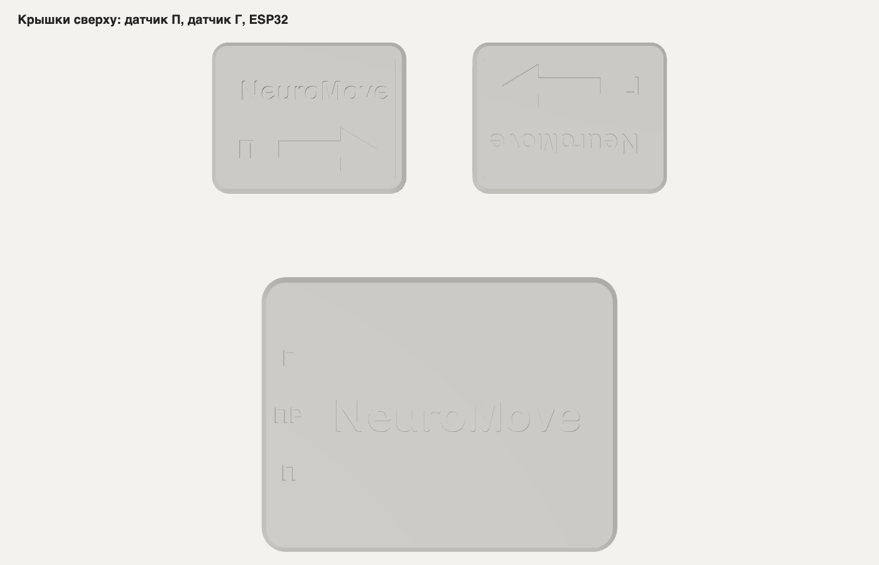
hardware/models/enclosure/korpus-v3-kryshki-sverhu.png
