Amir10202010/neuromove/hardware/models/enclosure/korpus-v4-datchik.png

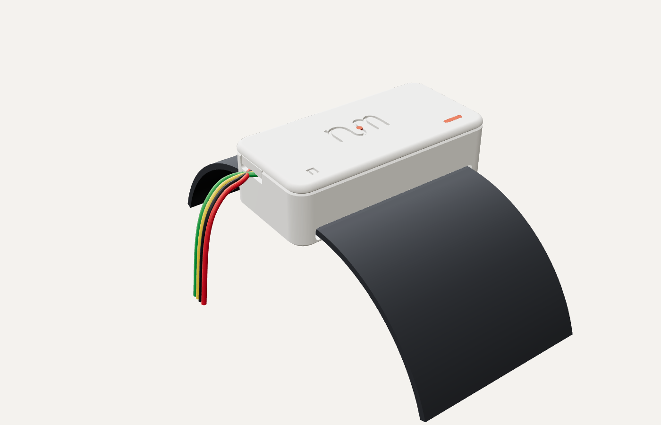
hardware/models/enclosure/korpus-v4-datchik.png
