Amir10202010/neuromove/hardware/models/enclosure/korpus-v4-esp32-usb.png

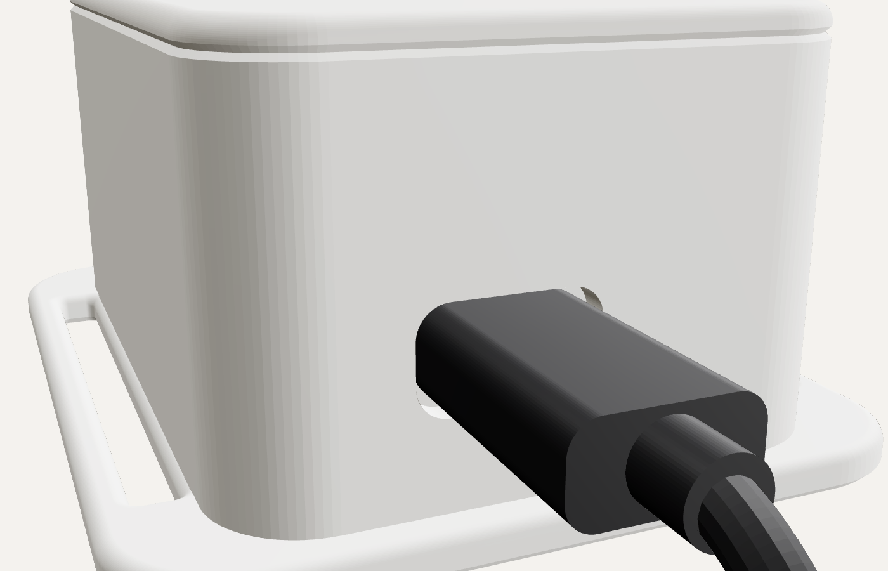
hardware/models/enclosure/korpus-v4-esp32-usb.png
