Amir10202010/neuromove/website/src/assets/movement-study-768.webp

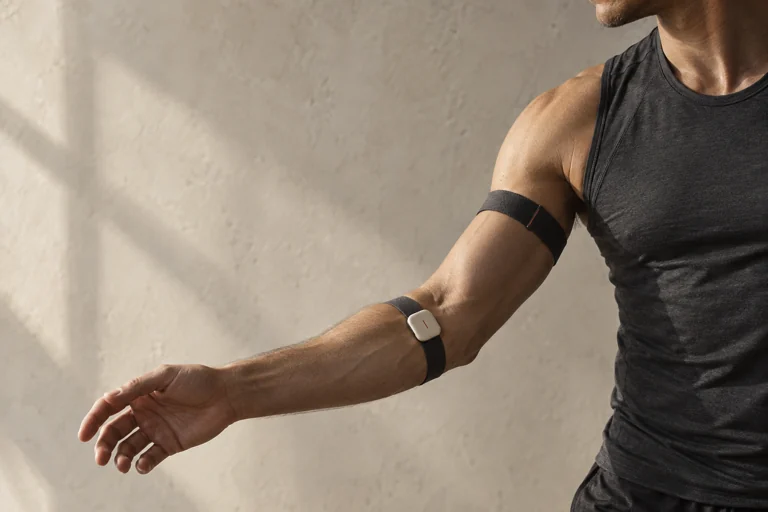
website/src/assets/movement-study-768.webp
