Amir10202010/neuromove/website/src/assets/sensor-concept-768.webp

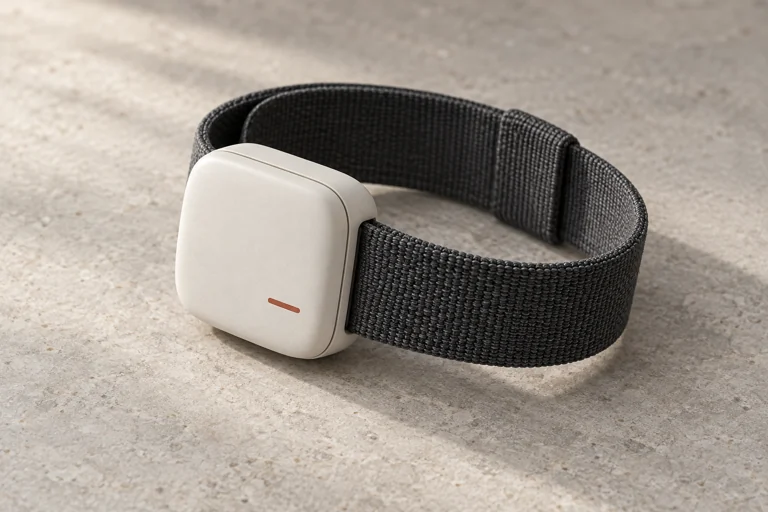
website/src/assets/sensor-concept-768.webp
