Amir10202010/neuromove/питч/01.jpg

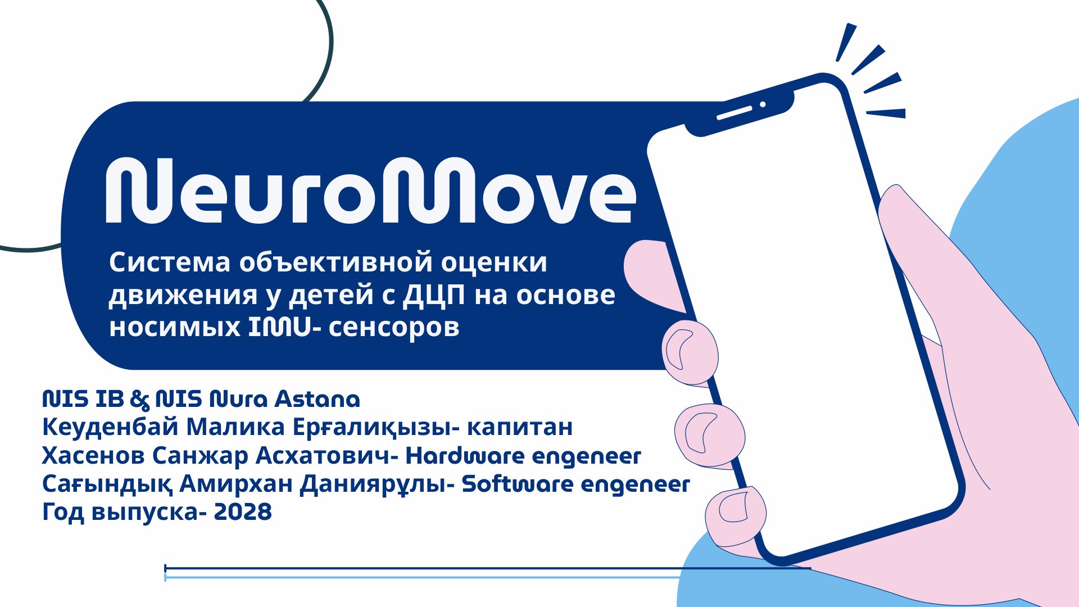
питч/01.jpg
