Amir10202010/neuromove/питч/02.jpg

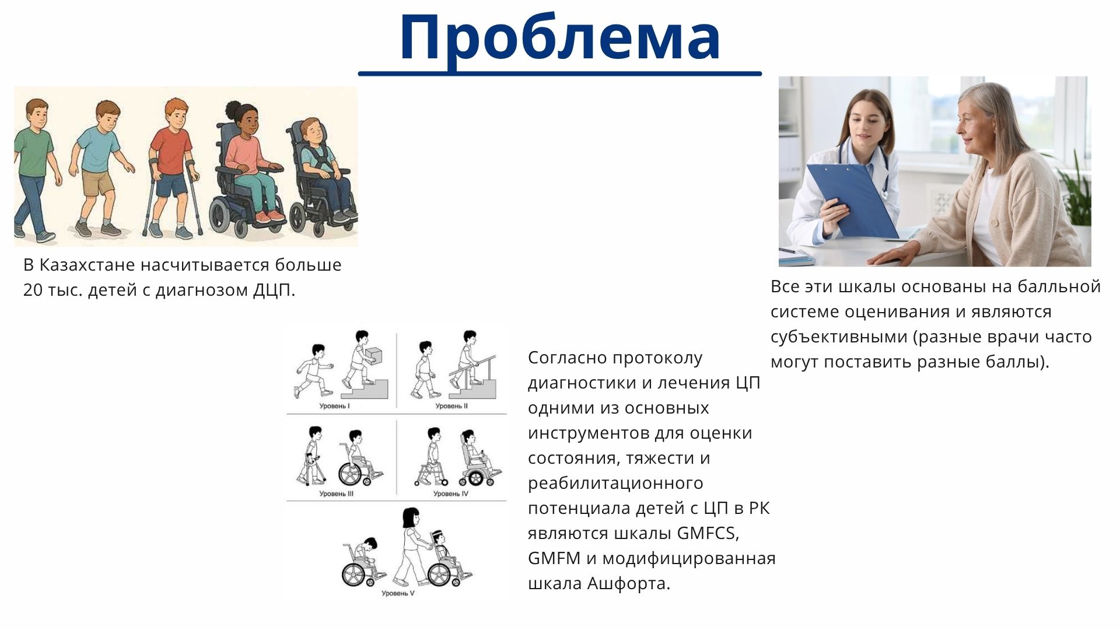
питч/02.jpg
