Amir10202010/neuromove/питч/03.jpg

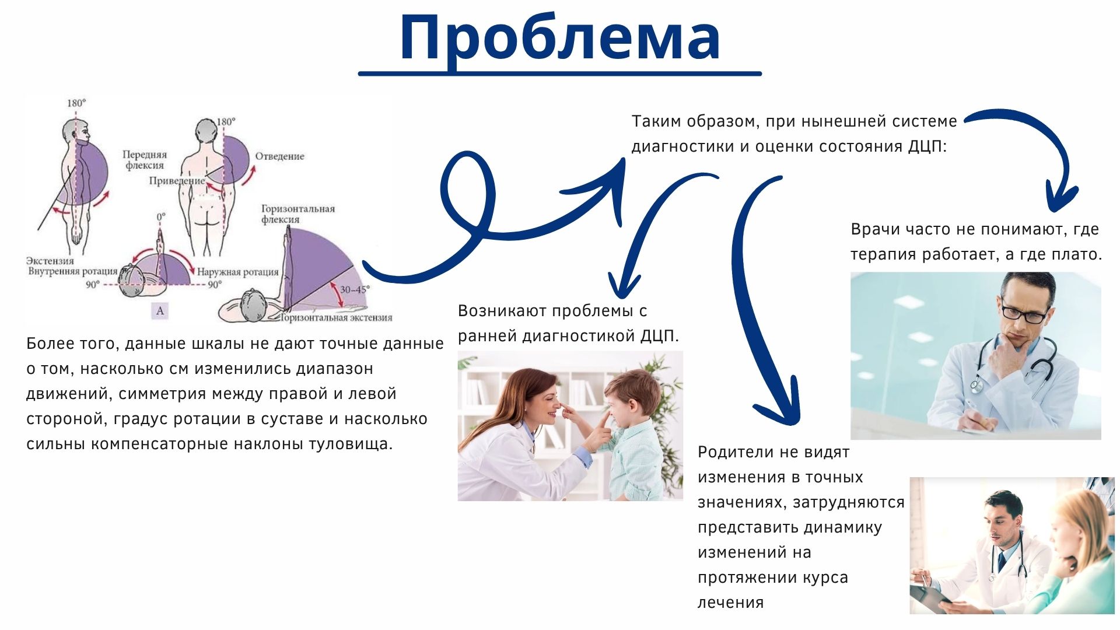
питч/03.jpg
