Amir10202010/neuromove/питч/04.jpg

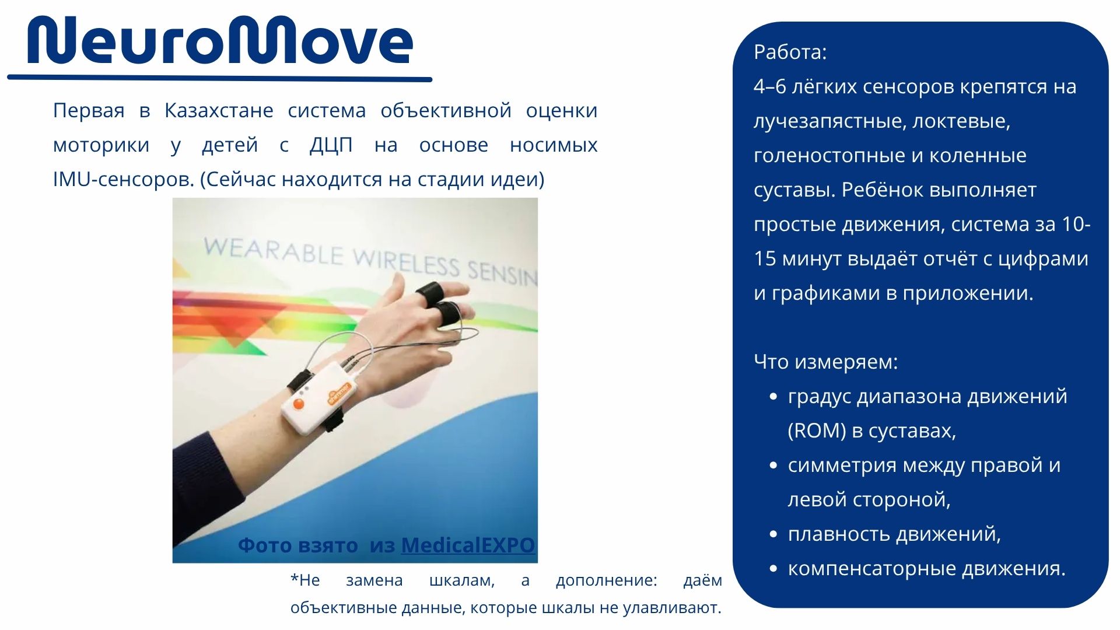
питч/04.jpg
