Amir10202010/neuromove/питч/05.jpg

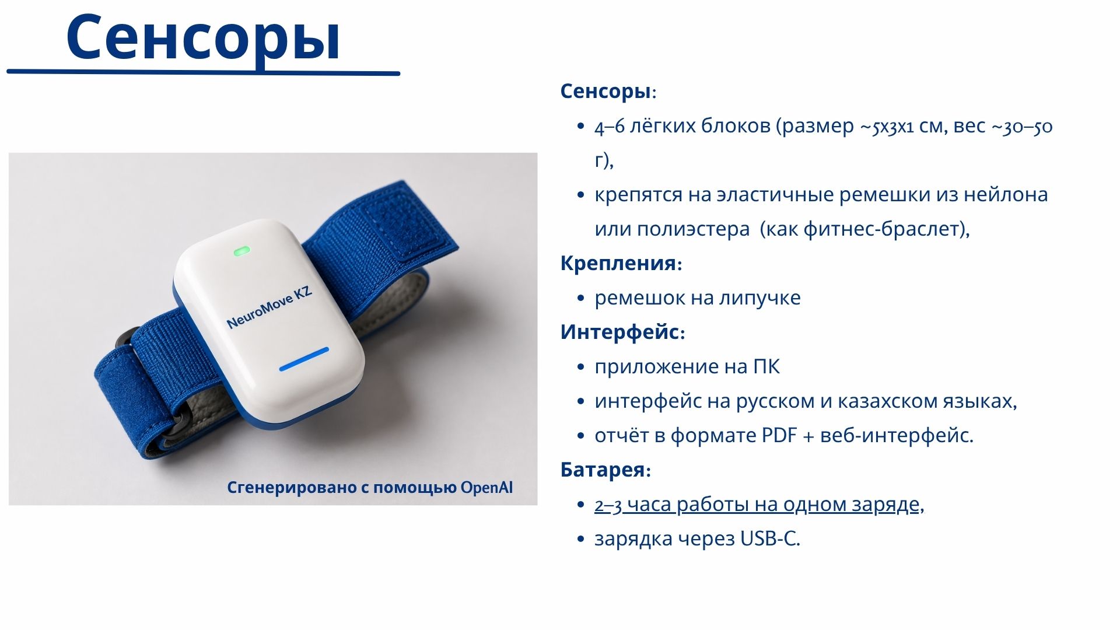
питч/05.jpg
