Amir10202010/neuromove/питч/06.jpg

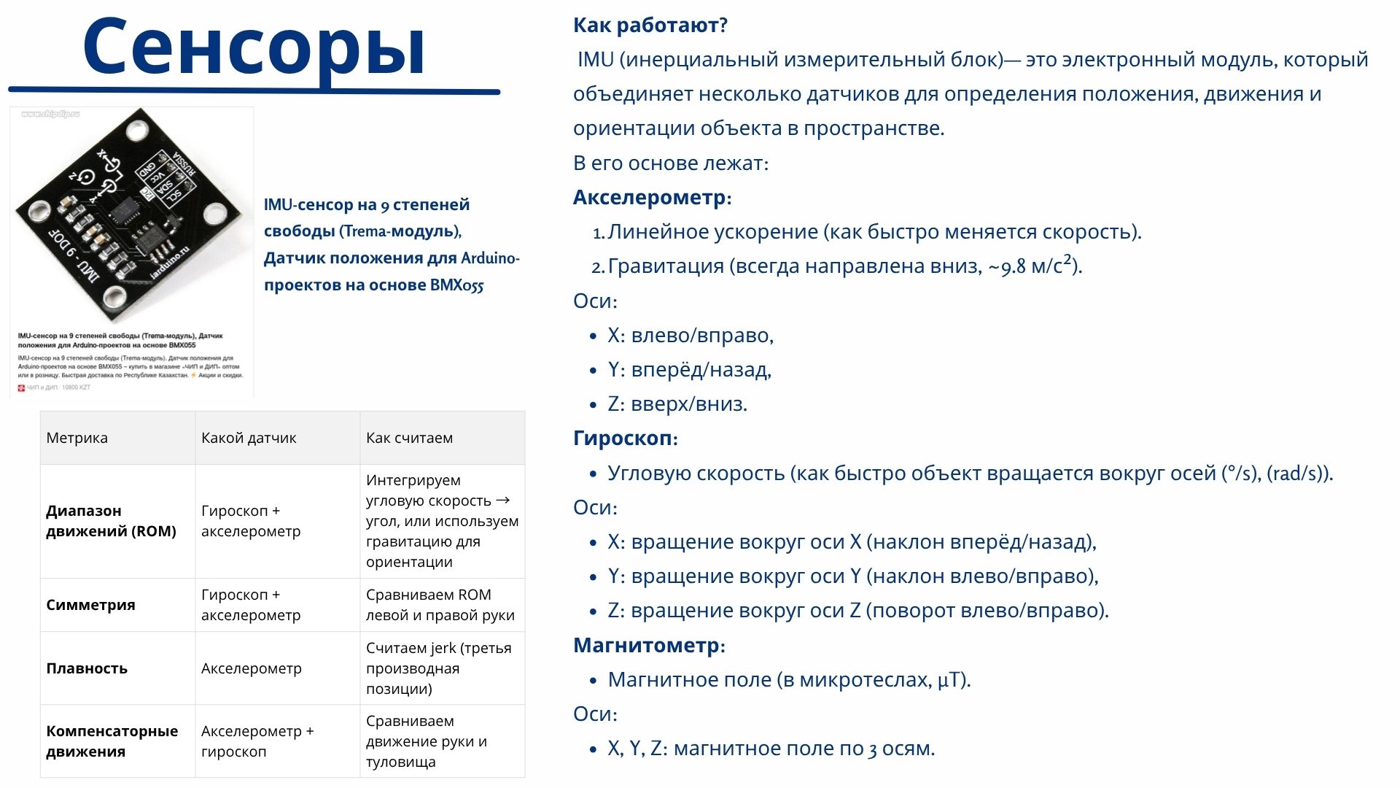
питч/06.jpg
