Amir10202010/neuromove/питч/07.jpg

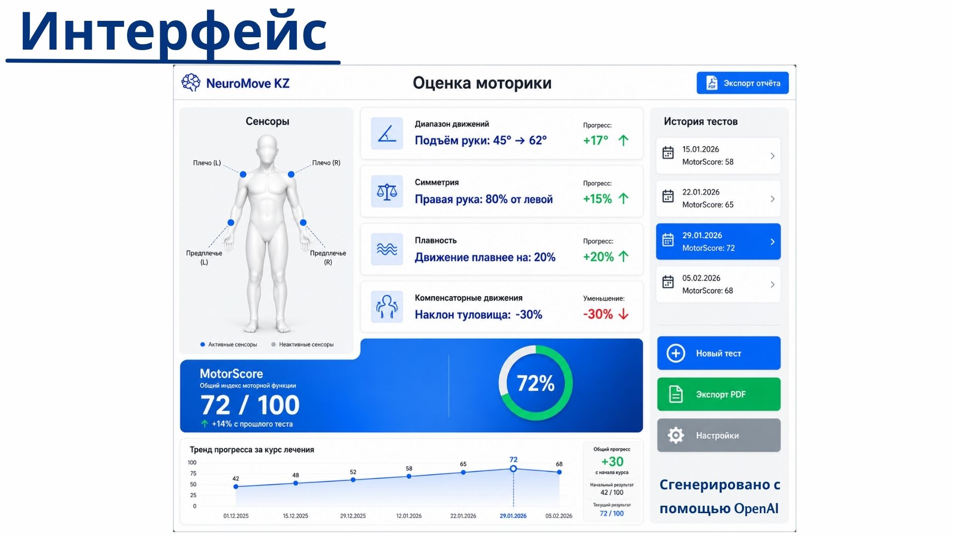
питч/07.jpg
