Amir10202010/neuromove/питч/08.jpg

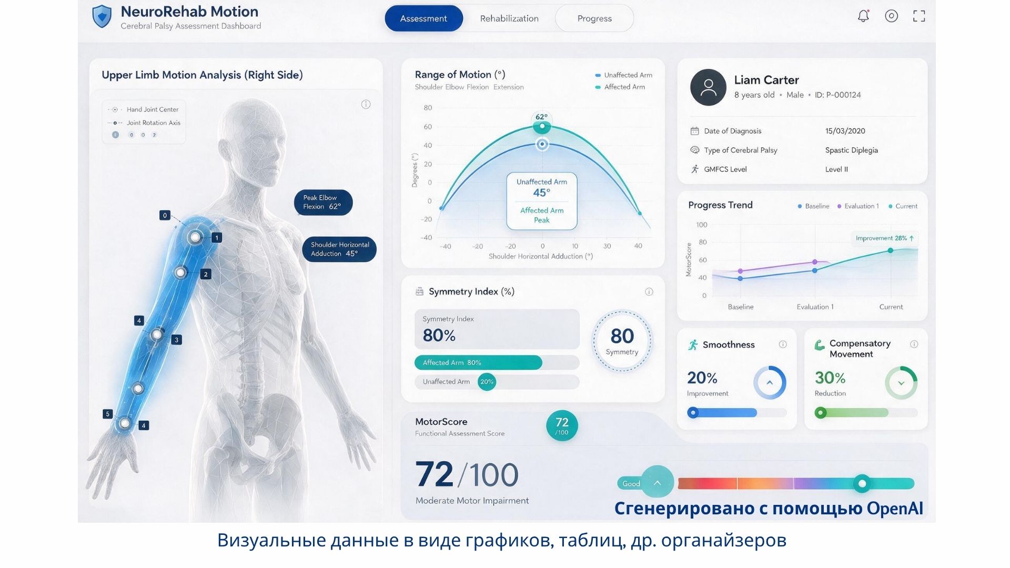
питч/08.jpg
