Amir10202010/neuromove/питч/09.jpg

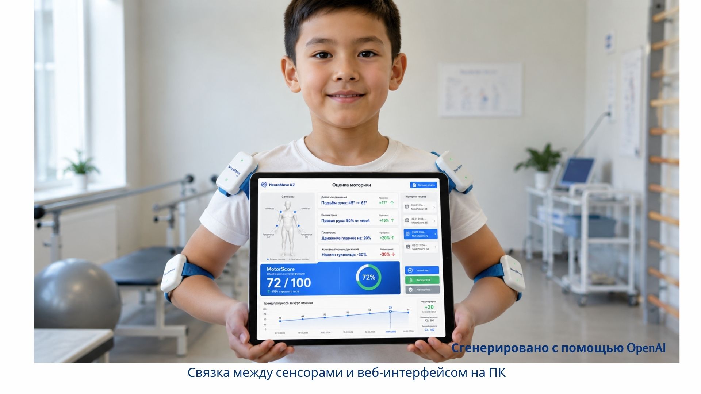
питч/09.jpg
