Amir10202010/neuromove/питч/10.jpg

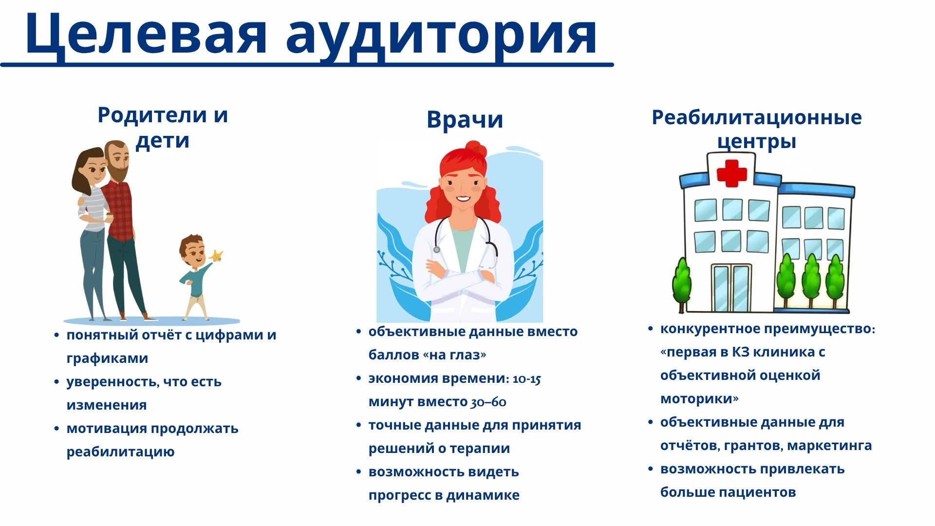
питч/10.jpg
