Amir10202010/neuromove/питч/11.jpg

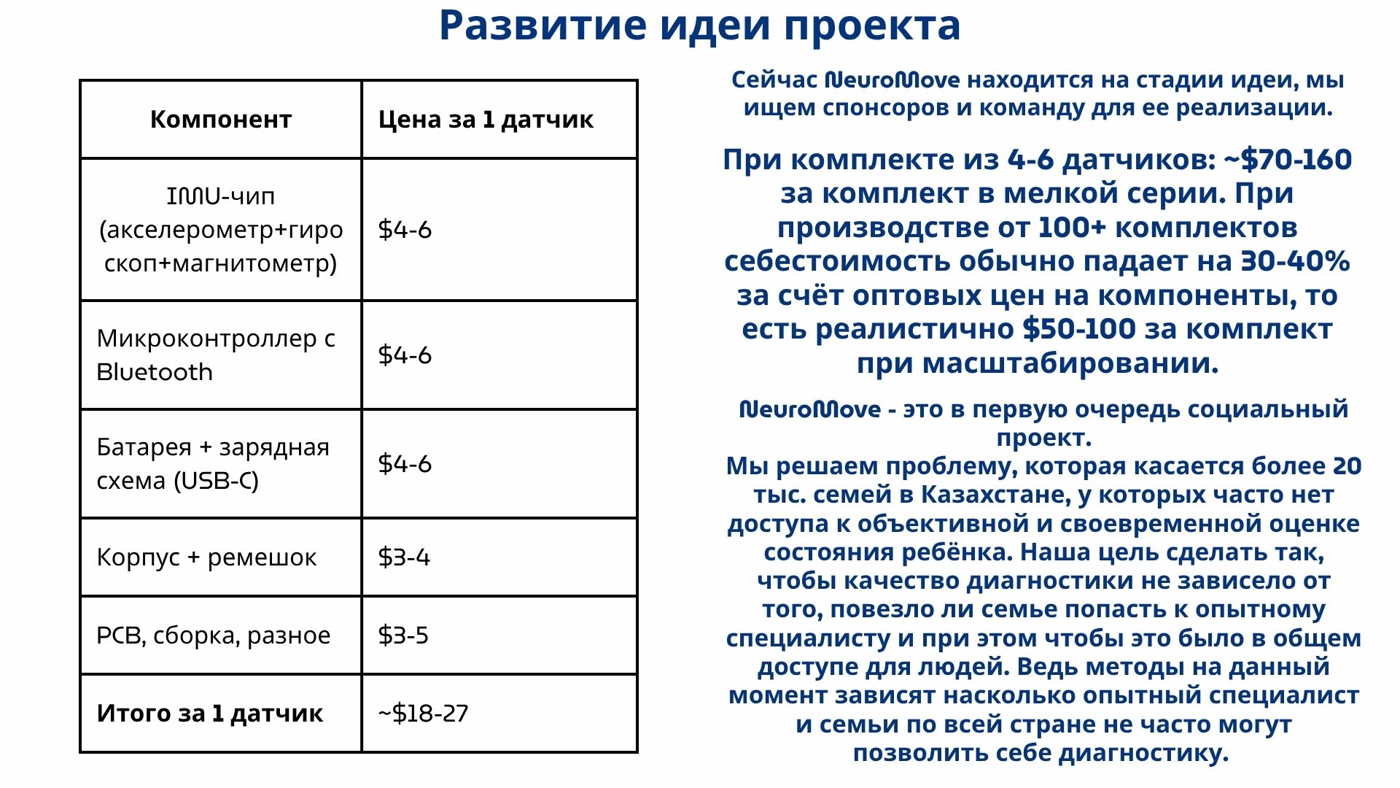
питч/11.jpg
