Amir10202010/neuromove/питч/12.jpg

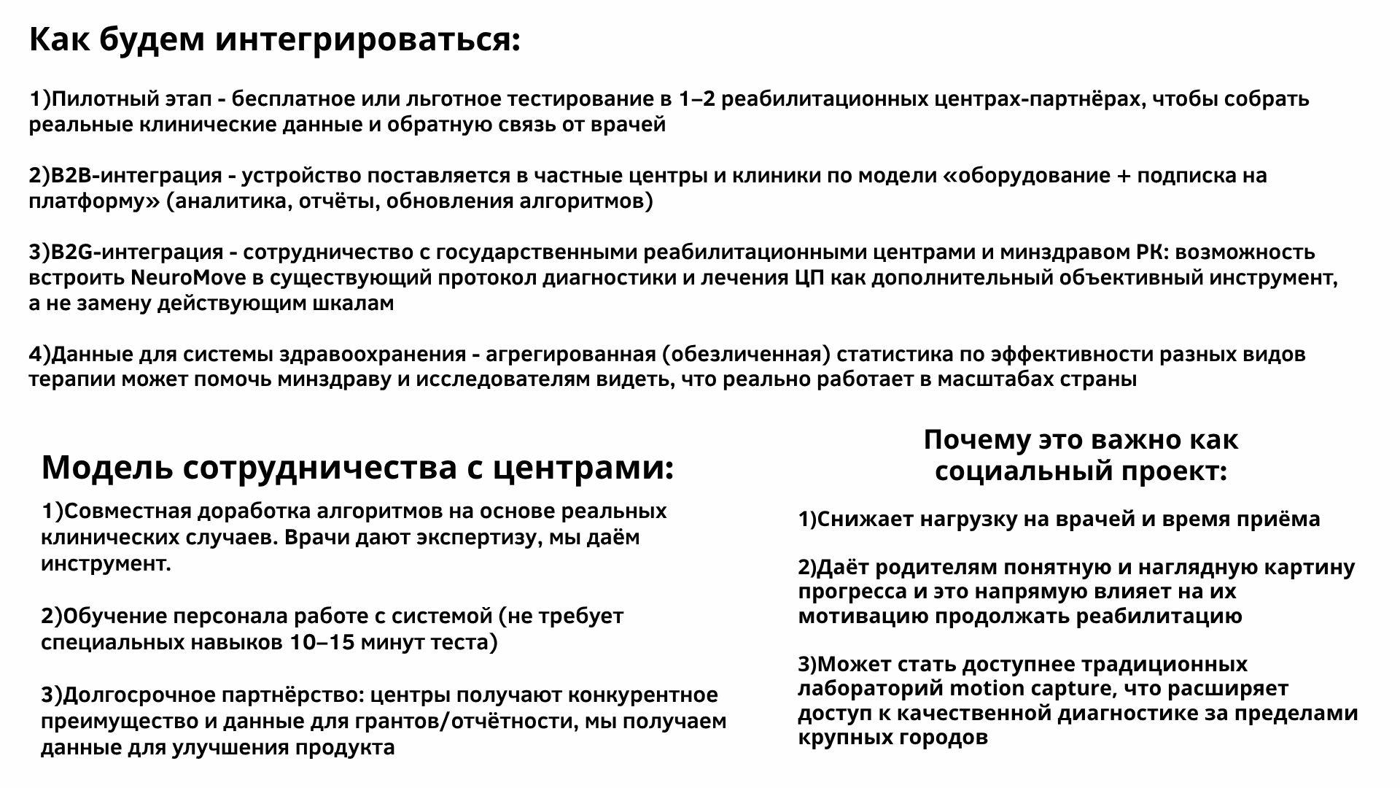
питч/12.jpg
