Amir10202010/neuromove/питч/13.jpg

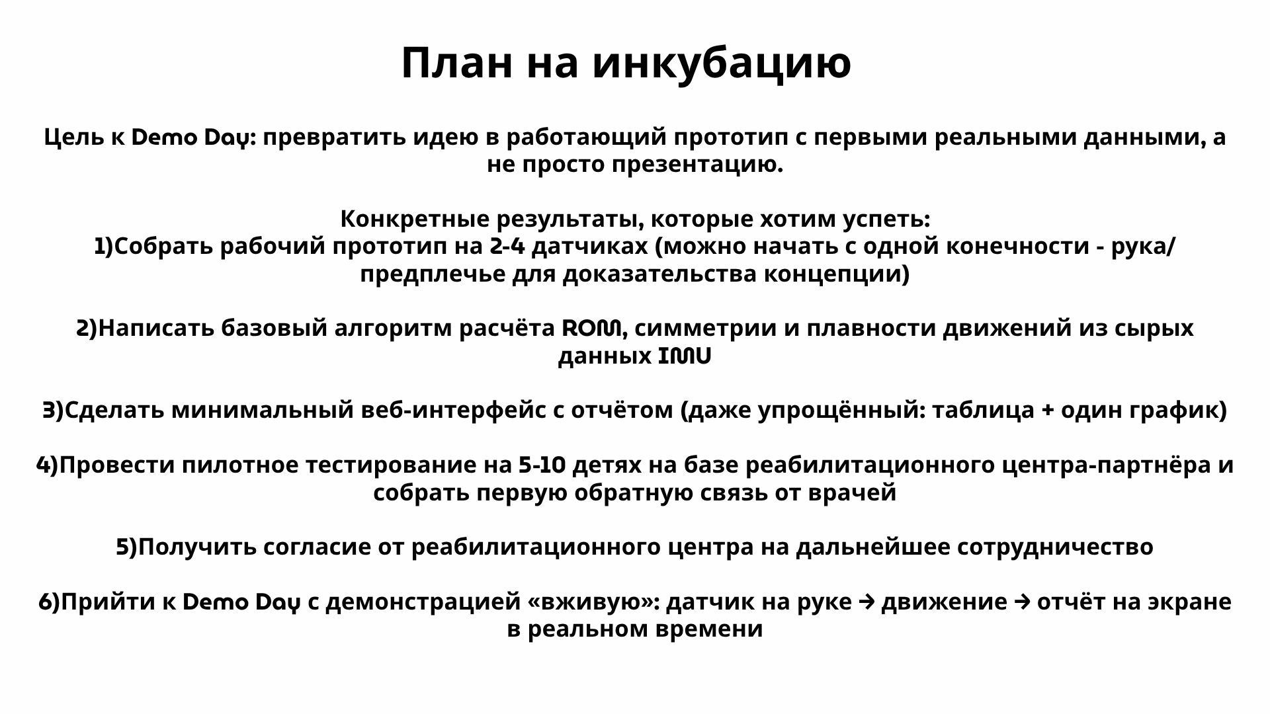
питч/13.jpg
