Amir10202010/neuromove/питч/14.jpg

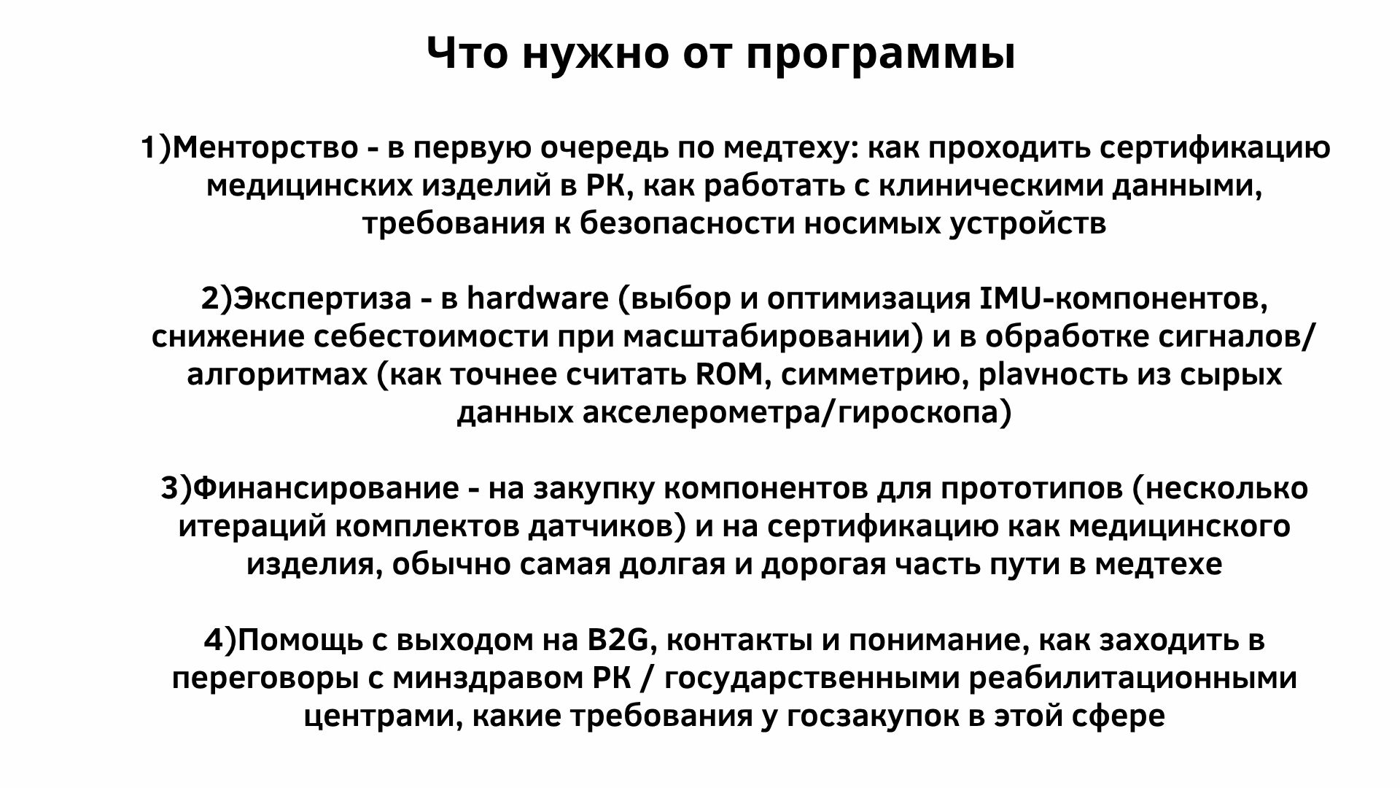
питч/14.jpg
