Amir10202010/neuromove/питч/15.jpg

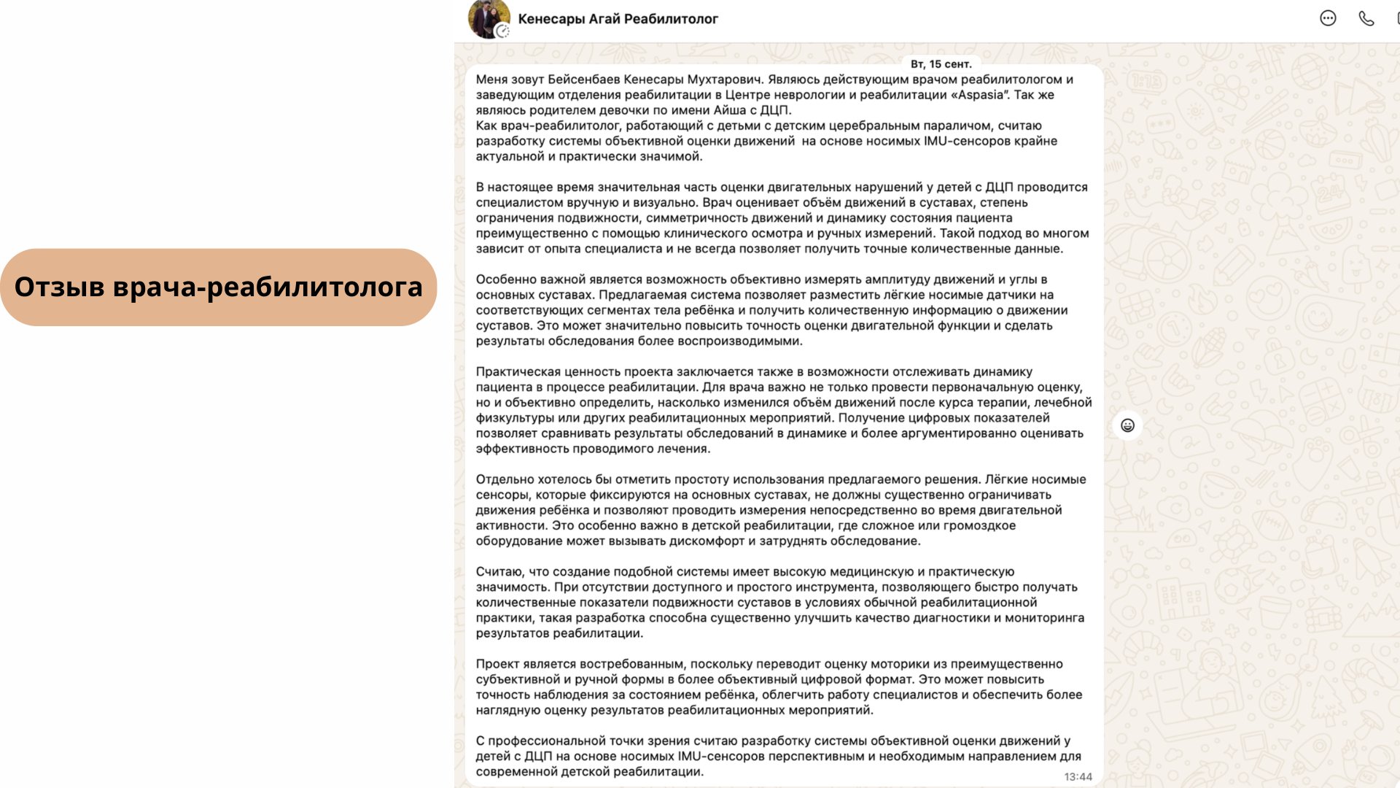
питч/15.jpg
