Amir10202010/neuromove/hardware/models/enclosure/korpus-v4-datchik-kryshka-PR.step

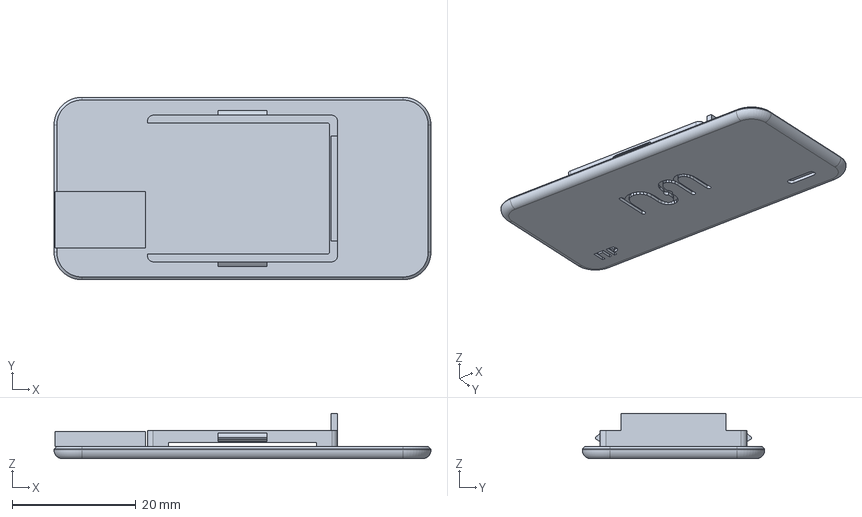
[picture p35: CAD file, 2026-11-08]
hardware/models/enclosure/korpus-v4-datchik-kryshka-PR.step
61.0 x 29.5 x 7.35 mm
