Amir10202010/neuromove/hardware/models/enclosure/print-ready/A1-v4-3-esp32-ready.3mf

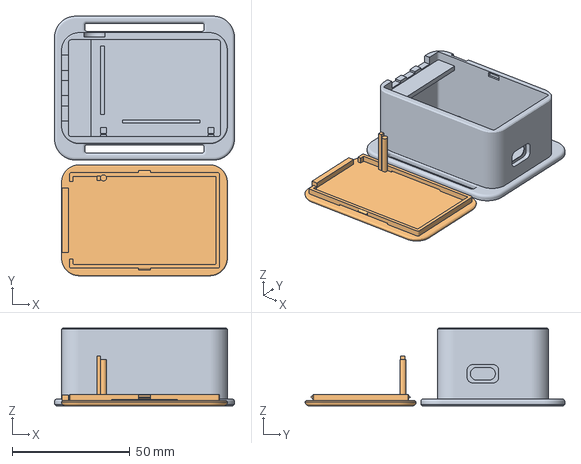
[picture p36: CAD file, 2026-11-08]
hardware/models/enclosure/print-ready/A1-v4-3-esp32-ready.3mf
76.4 x 110.2 x 33.0 mm
korpus-v4-esp32-korpus
esp32-kryshka
