Amir10202010/neuromove/hardware/models/enclosure/print-ready/A1-v4-1-proba-ready.3mf

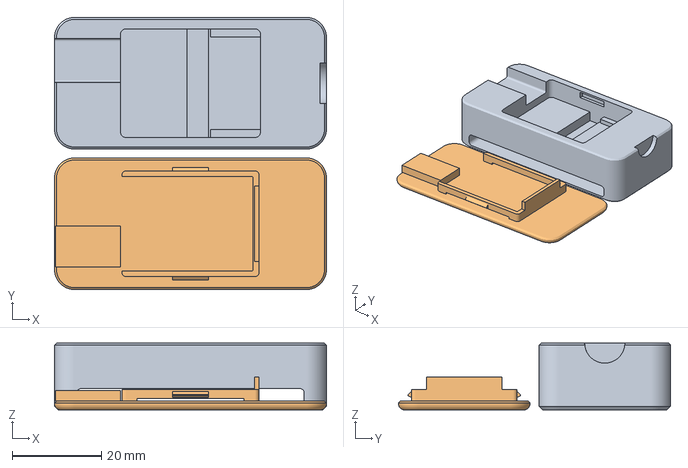
[picture p37: CAD file, 2026-11-08]
hardware/models/enclosure/print-ready/A1-v4-1-proba-ready.3mf
61.0 x 61.0 x 15.0 mm
korpus-v4-datchik-korpus
datchik-kryshka-P
