Amir10202010/neuromove/hardware/models/enclosure/korpus-v4-esp32-korpus.step

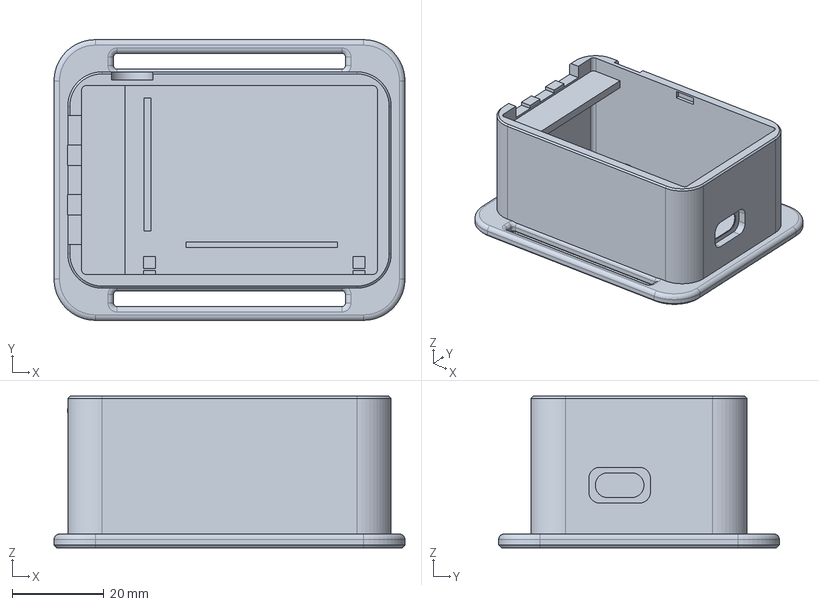
[picture p38: CAD file, 2026-11-08]
hardware/models/enclosure/korpus-v4-esp32-korpus.step
76.4 x 61.1 x 33.0 mm
