Amir10202010/neuromove/hardware/models/enclosure/print-ready/A1-v4-2-datchiki-ready.3mf

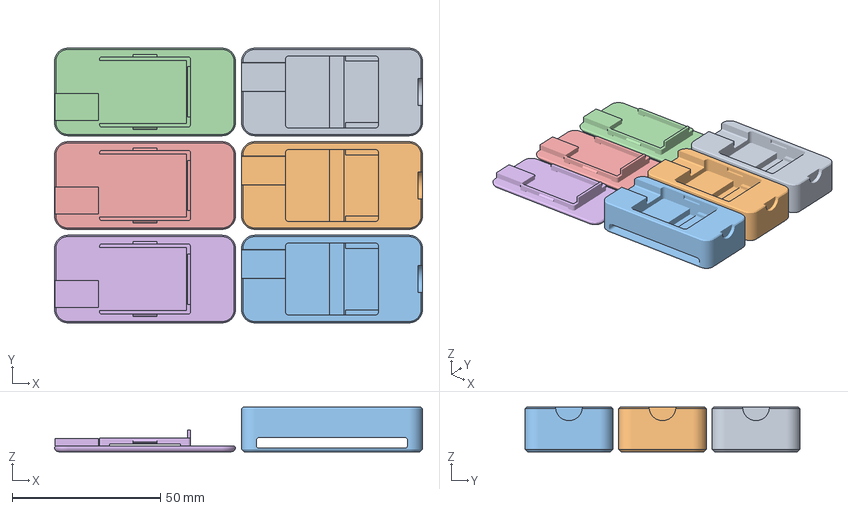
[picture p39: CAD file, 2026-11-08]
hardware/models/enclosure/print-ready/A1-v4-2-datchiki-ready.3mf
124.0 x 92.6 x 15.0 mm
korpus-v4-datchik-korpus x 3
kryshka-P
kryshka-PR
kryshka-G
