Amir10202010/neuromove/hardware/models/enclosure/korpus-v4-esp32-kryshka.step

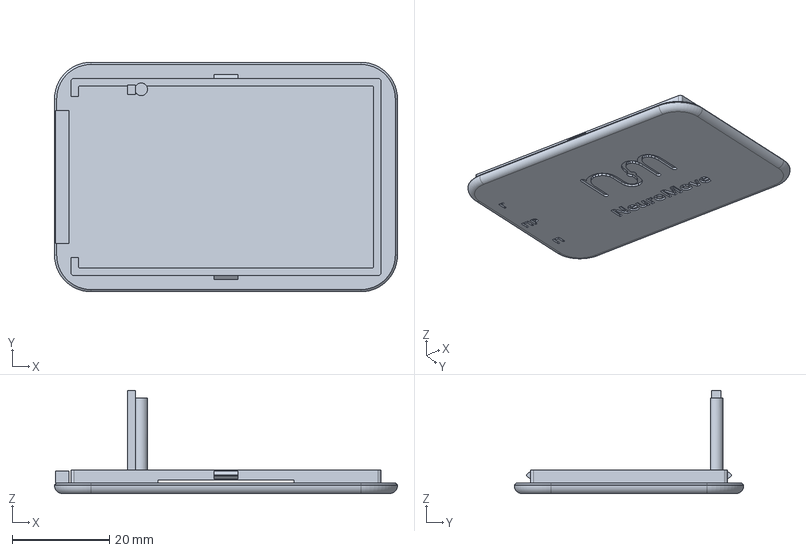
[picture p40: CAD file, 2026-11-08]
hardware/models/enclosure/korpus-v4-esp32-kryshka.step
70.4 x 47.1 x 21.1 mm
