Amir10202010/neuromove/hardware/models/enclosure/korpus-v4-datchik-korpus.step

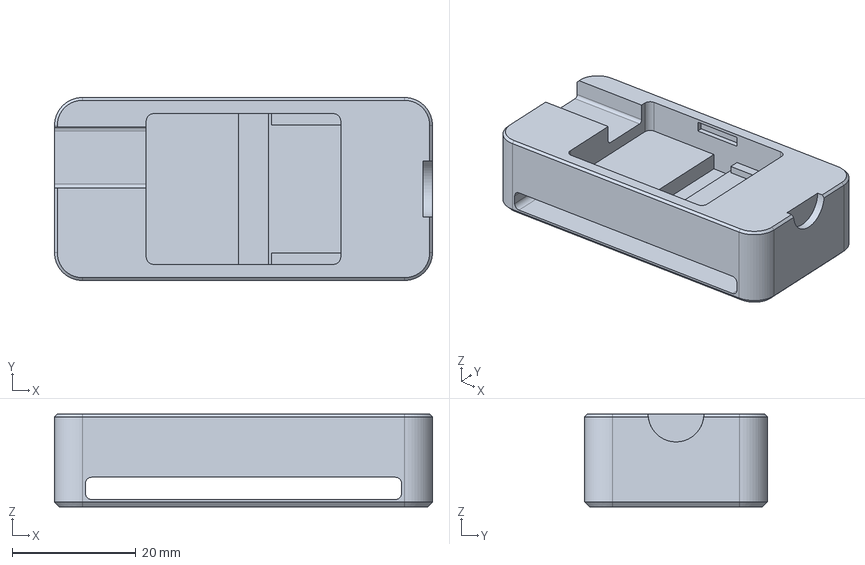
[picture p42: CAD file, 2026-11-08]
hardware/models/enclosure/korpus-v4-datchik-korpus.step
61.0 x 29.5 x 15.0 mm
