Amir10202010/neuromove/hardware/models/enclosure/korpus-v4-datchik-vkladysh-G.stl

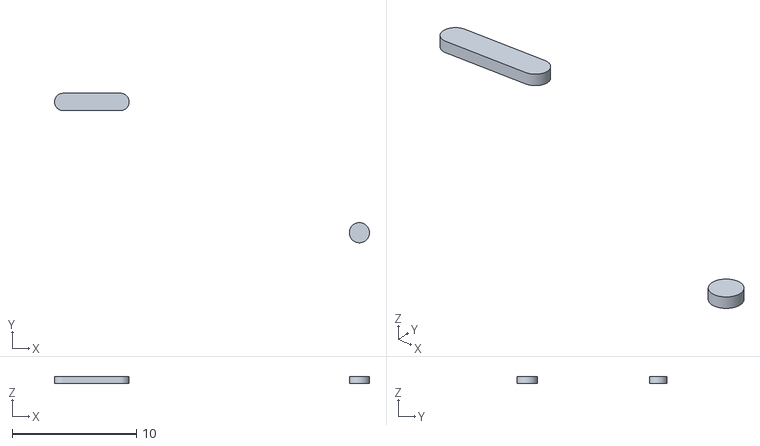
[picture p43: CAD file, 2026-11-08]
hardware/models/enclosure/korpus-v4-datchik-vkladysh-G.stl
25.3 x 12.0 x 0.6
