Amir10202010/neuromove/hardware/models/enclosure/print-ready/A1-2-datchiki-G38-ready.3mf

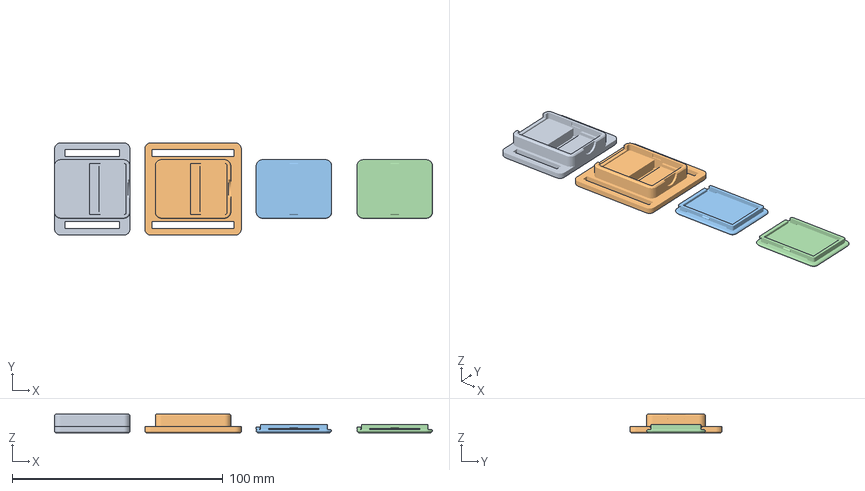
[picture p44: CAD file, 2026-10-29]
hardware/models/enclosure/print-ready/A1-2-datchiki-G38-ready.3mf
179.2 x 43.8 x 8.94 mm
1-korpus-v3-datchik-korpus
2-korpus-v3-datchik-G-remen-38mm
3-korpus-v3-datchik-kryshka-PR
4-korpus-v3-datchik-kryshka-G
