Amir10202010/neuromove/hardware/models/enclosure/korpus-v4-esp32-vkladysh.stl

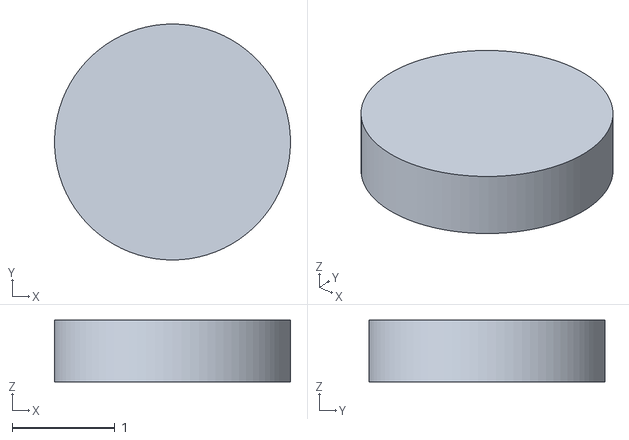
[picture p45: CAD file, 2026-11-08]
hardware/models/enclosure/korpus-v4-esp32-vkladysh.stl
2.29 x 2.29 x 0.6
