Amir10202010/neuromove/hardware/models/enclosure/print-ready/korpus-v3-datchik-korpus-G-38mm.step

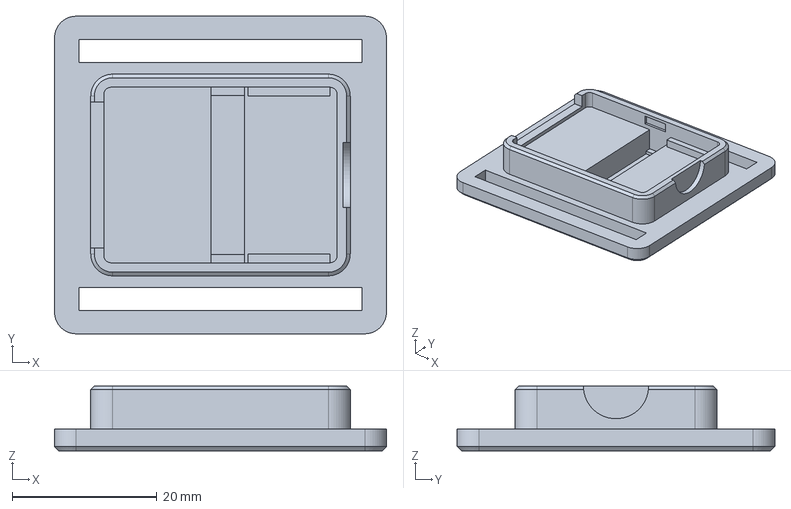
[picture p46: CAD file, 2026-10-29]
hardware/models/enclosure/print-ready/korpus-v3-datchik-korpus-G-38mm.step
45.8 x 43.8 x 8.94 mm
