Amir10202010/neuromove/hardware/models/enclosure/korpus-v4-datchik-vkladysh-PR.stl

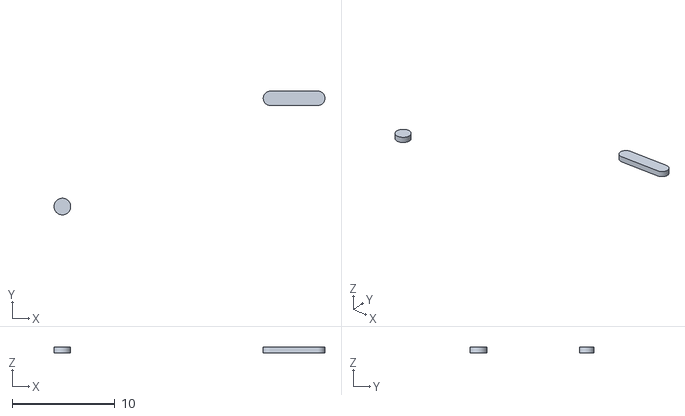
[picture p47: CAD file, 2026-11-08]
hardware/models/enclosure/korpus-v4-datchik-vkladysh-PR.stl
26.3 x 12.0 x 0.6
