Amir10202010/neuromove/hardware/models/enclosure/print-ready/A1-1-proba-ready.3mf

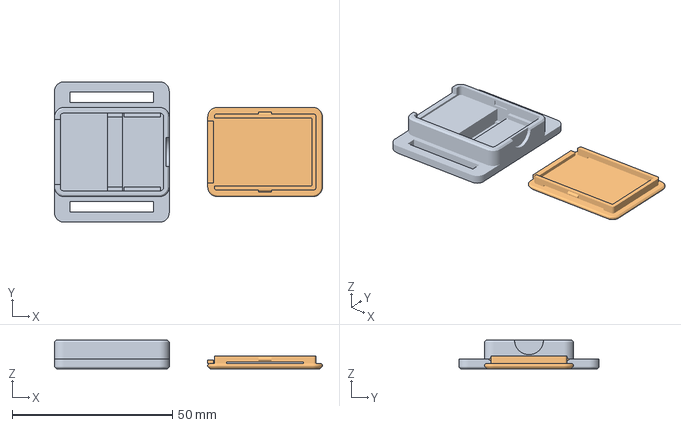
[picture p48: CAD file, 2026-10-29, an earlier design]
hardware/models/enclosure/print-ready/A1-1-proba-ready.3mf
83.6 x 43.8 x 8.94 mm
1-korpus-v3-datchik-korpus
2-korpus-v3-datchik-kryshka-P
