Amir10202010/neuromove/hardware/models/enclosure/print-ready/A1-3-esp32-ready.3mf

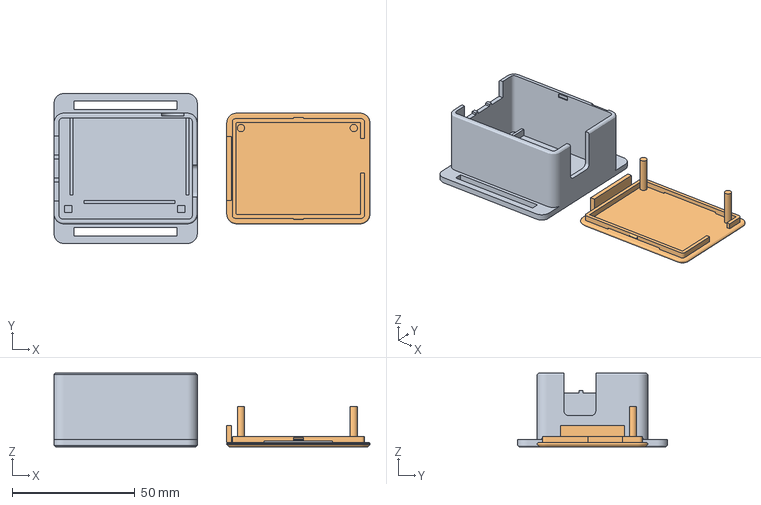
[picture p49: CAD file, 2026-10-29, an earlier design]
hardware/models/enclosure/print-ready/A1-3-esp32-ready.3mf
128.8 x 61.1 x 30.0 mm
1-korpus-v3-esp32-korpus
2-korpus-v3-esp32-kryshka
