Amir10202010/neuromove/(list of files, cad)

Other CAD files:
hardware/models/enclosure/korpus-v4-datchik-kryshka-P.step
hardware/models/enclosure/korpus-v4-datchik-kryshka-G.step
hardware/models/enclosure/korpus-v4-datchik-vkladysh-P.stl
hardware/models/enclosure/korpus-v3-datchik-korpus.stl
hardware/models/enclosure/korpus-v3-datchik-kryshka-G.stl
hardware/models/enclosure/korpus-v3-datchik-kryshka-P.stl
hardware/models/enclosure/korpus-v3-datchik-kryshka-PR.stl
hardware/models/enclosure/korpus-v3-esp32-korpus.stl
hardware/models/enclosure/korpus-v3-esp32-kryshka.stl
hardware/models/enclosure/korpus-v4-datchik-korpus.stl
hardware/models/enclosure/korpus-v4-datchik-kryshka-G.stl
hardware/models/enclosure/korpus-v4-datchik-kryshka-P.stl
hardware/models/enclosure/korpus-v4-datchik-kryshka-PR.stl
hardware/models/enclosure/korpus-v4-esp32-korpus.stl
hardware/models/enclosure/korpus-v4-esp32-kryshka.stl
hardware/models/enclosure/print-ready/korpus-v3-datchik-korpus-G-38mm.stl
