Amir10202010/neuromove/hardware/models/enclosure/print-ready/PRINT-STATUS.md

# Статус печати — 8 ноября 2026

**v4 готов к печати, не печатался.** Проекты `A1-v4-*-ready.3mf` нарезаны в Bambu Studio без ошибок. Настройки те же, что у печатавшегося `A1-3-esp32-ready.3mf`.

1. Сначала `A1-v4-1-proba-ready.3mf` — проба, 41 мин. Вложить датчик с колодкой и закрыть крышку: должна щёлкнуть.
2. После удачной пробы — `A1-v4-2-datchiki-ready.3mf`, 105 мин. Все три датчика одинаковые, под ремешок 5 см.
3. Затем `A1-v4-3-esp32-ready.3mf`, 89 мин (корпус с полкой и крышка). Перед ним замерить выступ гнезда USB-C за край платы.

Подробности — [`../ПЕЧАТЬ-v4.md`](../ПЕЧАТЬ-v4.md). Ниже — статус v3, для истории.

# Последний подтверждённый статус печати v3 — 27 октября 2026

- **Пробный корпус** `A1-1-proba-ready.3mf` на Space1 завершил печать: Bambu Studio показал 100%, 45/45 слоёв и статус Finished. Перед следующим столом нужно проверить, что MPU6050 с кабелем входит в корпус, а крышка защёлкивается и держится; затем очистить стол.
- **Корпус ESP32** `A1-3-esp32-ready.3mf` отправлен на принтер «бамбу2». Подтверждены запуск задания и слой 1/150. Не отправлять его повторно.
- **Комплект датчиков с нагрудным корпусом под ремень 38 мм** `A1-2-datchiki-G38-ready.3mf` нарезан в Bambu Studio без ошибок: 44 мин 18 с, 16,52 г PLA, зазор между деталями 7 мм. Отправлять только после положительной проверки пробного корпуса.

| Файл | Состояние | Следующий шаг |
|---|---|---|
| `A1-1-proba-ready.3mf` | печать завершена | физически проверить посадку датчика и крышку |
| `A1-2-datchiki-G38-ready.3mf` | нарезан, не отправлен | дождаться проверки пробы |
| `A1-3-esp32-ready.3mf` | печать началась, слой 1/150 подтверждён | дождаться завершения, не дублировать задание |

Настройки готовых проектов: Bambu Lab A1, сопло 0,4 мм, Generic PLA, профиль 0.20mm Standard @BBL A1, 3 стенки, заполнение 20%, поддержки выключены, масштаб 100%. Для отправленных заданий включены Auto Bed Leveling и Flow Dynamics Calibration.

`A1-2-datchiki-template.3mf` — технический шаблон для `make_chest_38.py`, не отправлять на печать. Итоговый STL и STEP корпуса под ремень 38 мм находятся рядом с готовыми проектами.
