Amir10202010/neuromove/website/docs/MCSE_GUIDE.md

# Лаборатория координации и стратегий (MCSE) — внутренний гид

Для разработчиков и тестировщиков NeuroMove. Что это, зачем, где на сайте, как читать каждый экран,
откуда берутся данные, как устроен код, как тестировать и что считать ошибкой.

Версия движка: `nm-lab-coord 1.0.0` (константа `COORD_VERSION` в `src/lab/version.ts`). Гид написан 8 ноября 2026.

Связанные документы (подробности и доказательства):
- научный отчёт — [research/mcse-report.md](../../research/mcse-report.md);
- что датчики могут и не могут измерить — [research/coordination-feasibility.md](../../research/coordination-feasibility.md);
- проверка на синтетике, критерии, провалы — [research/mcse-validation.md](../../research/mcse-validation.md);
- сравнение с эталонными библиотеками — [research/algorithm-benchmarking.md](../../research/algorithm-benchmarking.md).

---

## Содержание

1. [Что это простыми словами](#1-что-это-простыми-словами)
2. [Чего это НЕ делает](#2-чего-это-не-делает)
3. [Где это на сайте](#3-где-это-на-сайте)
4. [Словарь терминов](#4-словарь-терминов)
5. [Откуда берутся данные](#5-откуда-берутся-данные)
6. [Экран по частям: что показано и как читать](#6-экран-по-частям)
7. [Все вердикты и что они значат](#7-все-вердикты)
8. [Коды причин (reasons) и сообщения](#8-коды-причин-и-сообщения)
9. [Как это устроено внутри (для разработчиков)](#9-как-это-устроено-внутри)
10. [Правила, которые нельзя нарушать](#10-правила-которые-нельзя-нарушать)
11. [Как тестировать (для тестировщиков)](#11-как-тестировать)
12. [Команды](#12-команды)
13. [Известные ограничения и провалы](#13-известные-ограничения-и-провалы)
14. [Частые вопросы и неполадки](#14-частые-вопросы-и-неполадки)

---

## 1. Что это простыми словами

Раньше NeuroMove про каждое повторение знал по сути **одно число**: на сколько градусов поднялась рука
(объём движения, ROM), плюс плавность и максимальный наклон туловища.

Но одинаковый результат можно получить **разными способами**. Пример, который движок умеет различать:

| | Способ 1 «за счёт руки» | Способ 2 «с участием туловища» |
|---|---|---|
| Рука относительно туловища | поднята на 120° | поднята на 102° |
| Туловище | прямо | отклонено назад на 18° |
| **Рука относительно вертикали (что видит клинический тест)** | **120°** | **120°** |

Клинический тест покажет 120° в обоих случаях. MCSE видит, что движение **организовано по-разному**.

MCSE (Motor Coordination & Strategy Discovery Engine) отвечает на три вопроса:

1. **Как движение распределено между сегментами** — туловищем, плечом, предплечьем, локтем — и в какие моменты
   каждый включается.
2. **Есть ли у ребёнка разные «способы» (стратегии)** выполнять одно и то же движение, особенно при одинаковом
   результате. Если данных мало или различий нет — движок **честно говорит «не определено»**.
3. **Как эти способы меняются от сеанса к сеансу** при практике — отдельно от того, как меняется сам результат.

Главная функция — **«Диссоциация выполнения и стратегии»** (Performance–Strategy Dissociation, PSDA): берём
повторения с **одинаковым** результатом и проверяем, отличается ли их организация сильнее, чем обычный разброс
между повторениями; показываем, **где** (какой сегмент, какая часть движения) и **насколько надёжно**.

---

## 2. Чего это НЕ делает

Это важно и для разработки, и для текстов на экране, и для разговора с врачами.

- **Не измеряет мышцы, мозг, «нейронные синергии».** У нас только инерциальные датчики (IMU), нет ЭМГ.
  Мы говорим «компоненты координации» (кинематические), никогда «мышечные синергии».
- **Не ставит диагноз и не оценивает.** Стратегии называются нейтрально — «Стратегия A», «Стратегия B».
  Нельзя писать «компенсаторная», «патологическая», «правильная», «хуже/лучше».
- **«Вклад туловища» — это наблюдаемое отношение углов**, а не признак компенсации. Ребёнок может наклоняться
  по многим причинам, движок их не различает.
- **Не считает поворот корпуса вокруг вертикали (курс), положение кисти, суставные углы плеча по ISB.**
  Датчики 6-осевые, магнитометра нет — эти величины физически не наблюдаемы.
- **Не утверждает ничего о реальных детях** по результатам проверки: вся проверка — на синтетике (раздел 13).
- **Не придумывает данные.** Если сырых кадров нет — сеанс помечается «только агрегаты» и в анализ не идёт.

---

## 3. Где это на сайте

### Как попасть

`Исследования → Лаборатория двигательного научения → плитка «Лаборатория координации и стратегий»`

Прямой адрес: `#/research/coordination`. Можно с параметрами:
`#/research/coordination?p=<id пациента>&ex=shoulder_flexion` (`ex` — `shoulder_flexion`, `shoulder_abduction`,
`elbow_flexion`).

### Место среди страниц лаборатории

Чтобы тестировщик понимал, чем эта страница отличается от соседних:

| Страница | Адрес | Для чего | Данные |
|---|---|---|---|
| Обзор лаборатории | `#/research/lab` | карта всех участников: сколько сеансов, сколько с сырыми данными, вход во все инструменты | метаданные |
| Обозреватель научения | `#/research/learning` | как **результат** (ROM и др.) меняется от сеанса к сеансу; сравнение моделей обучения | агрегаты повторений |
| Вычислительный двойник | `#/research/twin/<id>` | индивидуальная модель изменения результата, прогнозы, сценарии; там же **переключатель записи практики** | агрегаты + попытки практики |
| Лаборатория анализа движения | `#/research/movement` | **один датчик**, сырые 100 Гц: качество сигнала, скорость, события движения, признаки | сырые кадры одного сеанса или файл |
| Дизайнер исследований | `#/research/designer` | протоколы исследований с заранее заданным анализом | — |
| Отчёты | `#/research/runs` | замороженные воспроизводимые анализы | — |
| Готовность к фундаментальной модели | `#/research/readiness` | чего не хватает в данных для обучения модели | — |
| **Лаборатория координации и стратегий** | `#/research/coordination` | **все датчики сразу**: как движение организовано между сегментами, стратегии, диссоциация, изменение стратегий во времени | **сырые кадры многих сеансов одного участника** |

Коротко: «Анализ движения» — один сегмент и один сеанс; «Координация» — все сегменты и все сеансы участника.

---

## 4. Словарь терминов

| Термин | Что значит |
|---|---|
| **Сырые кадры (raw frames)** | Числа прямо с датчиков: 100 раз в секунду по 6 чисел (ускорение XYZ, угловая скорость XYZ) с каждого датчика. Хранятся в IndexedDB, хранилище `raw` |
| **Канал** | Величина во времени, посчитанная из сырых кадров: например `trunk_pitch` (наклон туловища вперёд-назад) |
| **Наблюдаемый / измеренный / оцениваемый канал** | Measured — прямо с датчика (угловая скорость). Observable — однозначно вычисляется (наклон по гравитации). Estimated — оценка с допущениями (только `humerothoracic`) |
| **Поза калибровки** | 3 секунды неподвижно, руки вдоль тела, в начале каждого сеанса. От неё отсчитываются все углы |
| **Повторение** | Одно движение «туда и обратно». Грубо находится тем же правилом, что в клиническом тесте (порог с гистерезисом) |
| **Фазы** | Внутри повторения: начало → разгон → пик скорости → торможение → **достижение** (рука пришла) → удержание → **уход** (начало возврата) → возврат → конец |
| **Ориентиры (landmarks)** | Начало (0 %), достижение (45 %), уход (55 %), конец (100 %). По ним разные повторения «растягиваются» на общую шкалу «% движения» |
| **Неопределённость границы** | Каждая граница фазы считается несколькими способами (пороги 3/5/10 % и метод точки изменения); на графике — серая полоса |
| **Экскурсия** | Насколько канал изменился от момента начала повторения (в градусах) |
| **Результат (outcome)** | Клиническая величина повторения: насколько поднялась рука (для плеча) или согнулся локоть (для локтя), от начала до максимума |
| **Поправка на результат (performance-adjusted)** | Перед поиском стратегий из траекторий вычитается та часть, которая объясняется просто высотой подъёма. Иначе «высокие» и «низкие» повторения выглядели бы как разные стратегии |
| **Компоненты координации (C1, C2…)** | Главные направления, по которым повторения отличаются друг от друга (PCA по траекториям всех каналов). Не мышечные синергии |
| **Пространство координации** | Каждое повторение — точка с координатами C1, C2 |
| **Стратегия** | Группа повторений с похожей организацией движения, найденная статистически (смесь гауссиан). Только если прошла все проверки |
| **Апостериорная вероятность (posterior)** | Насколько уверенно повторение отнесено к стратегии. Ниже 0,8 — «неуверенно», такое повторение не считается |
| **Сигнатура стратегии** | Средние кривые, экскурсии, тайминги, разброс внутри стратегии — «портрет» стратегии |
| **Эквивалентность результатов** | 90 % доверительный интервал разницы результатов целиком внутри ±5° |
| **p_FWE** | p-значение с поправкой на множественные сравнения по всем каналам и всем точкам движения |
| **Допуск на переустановку датчиков (re-placement margin)** | 2,5°: насколько могут отличаться средние траектории двух сеансов только из-за того, что датчики сняли и надели заново. Предварительный, получен на симуляторе |
| **Манифест сырых данных** | Запись при сохранении сеанса: сколько кадров, какие датчики, SHA-256 содержимого, временная шкала. Позволяет проверить, что сырые данные не менялись |
| **Синтетика** | Данные из генератора с известной «истиной». Участники `SYN-…`. Всегда с пометкой |

---

## 5. Откуда берутся данные

### 5.1 Какие записи анализируются

| Запись | Есть сырые кадры? | Анализируется MCSE? |
|---|---|---|
| Сеанс с датчиками (USB, Bluetooth) | да (если хватило места в браузере) | **да** |
| Сеанс на симуляторе в демо-пространстве, проведённый вручную | да | да, с пометкой «смоделировано» |
| Заготовленная демо-история (сеансы, которые есть в демо сразу) | **нет** | нет — «только агрегаты» |
| Сеанс, сохранённый, когда кончилось место | нет (`hasRaw = false`) | нет |
| Сеанс валидации гониометром | нет | нет |
| Занятие в детском режиме (практика) **с включённой записью и согласием** | да (с 8.11.2026) | **да** |
| Занятие в детском режиме без включённой записи | нет | нет |
| Файл imu-csv в «Анализе движения» | только в памяти вкладки | нет |

### 5.2 Манифест и неизменность

- При сохранении нового сеанса (`sessionController.finalize`) к сеансу пишется `rawManifest`: число кадров,
  диапазон `seq` и времени, датчики, **SHA-256** сырого потока, модель синхронизации, временная шкала
  (конец калибровки, начало/конец каждого шага), версии ПО.
- Перед анализом движок пересчитывает хэш. Если не совпал — запись **отклоняется** («raw stream does not match its
  manifest»), числа по ней не считаются.
- Сеансы до 8.11.2026 манифеста не имеют — анализируются, но в колонке «Манифест» будет «нет манифеста».

### 5.3 Запись сырых данных практики

1. Открыть `Вычислительный двойник` участника → блок практики → **«Записывать попытки практики»**.
   В клинике нужно **активное согласие** участника (в демо — не нужно).
2. Провести занятие в детском режиме (Реабилитация → участник → детский режим → живая практика).
3. При остановке сохраняются попытки и — только при включённой записи — сырые кадры под id набора попыток.
4. Сырые кадры практики **остаются на устройстве** (сервер принимает сырые куски только для сеансов).

### 5.4 Сколько данных нужно

| Что хотим | Минимум | Реалистично |
|---|---|---|
| Компоненты координации | 10 повторений | 15+ |
| Поиск стратегий | **12 повторений** одного движения одной руки | ≥ 24 (мощность 0,65–0,95 на синтетике) |
| Диссоциация между двумя наборами | 5 в каждом после подбора по результату | ≈ 24 в каждом (мощность 0,95) |
| Модели изменения во времени | 3 сеанса | 5+ |

Обычный клинический тест — **3 повторения** на движение. Поэтому на одном-двух сеансах увидеть стратегии нельзя,
и движок это покажет как «недостаточно данных». Это **правильное поведение**, а не баг.

### 5.5 Поддерживаемые движения

`shoulder_flexion` (подъём вперёд), `shoulder_abduction` (подъём в сторону), `elbow_flexion` (сгибание локтя).
Поворот предплечья **не поддерживается** (другая структура повторения: туда-обратно через ноль).

---

## 6. Экран по частям

Сверху вниз, как на странице.

### 6.1 Панель управления

| Элемент | Что делает |
|---|---|
| **Участник** | выбор пациента текущего пространства (демо или клиника) |
| **Движение** | одно из трёх поддерживаемых |
| **Рука** | правая / левая. Анализируется одна рука за раз |
| **Анализировать записи** | читает сырые кадры всех подходящих сеансов и занятий участника и запускает движок. Неактивна, если сырых записей нет |
| **Синтетическая демонстрация** | генерирует участника `SYN-DEMO` с известной истиной и анализирует его. Ничего не сохраняет |

Анализ идёт в фоновом потоке (Web Worker): страница не зависает. Время — несколько секунд на ~50 повторений.

### 6.2 «Доступные данные»

Счётчики **до** анализа: сеансов с этим движением, сколько из них с сырыми кадрами, сколько с проверенным
манифестом, сколько «только агрегаты», занятий практики. Если «с сырыми кадрами: 0» — анализировать нечего.

### 6.3 Плашка синтетики

Оранжевая плашка **«СИНТЕТИЧЕСКАЯ демонстрация — не участник»** или **«Смоделированные записи»**. Должна быть
всегда, когда в анализе есть сгенерированные данные. Если её нет при синтетике — это **критический баг**.

### 6.4 «Записи и происхождение данных»

Одна строка — одна запись (сеанс или занятие).

| Колонка | Что значит | На что смотреть |
|---|---|---|
| Запись | дата; бейдж «смоделировано» | — |
| Источник | сеанс / занятие / файл / синтетика | — |
| Манифест | проверен / нет манифеста / хэш не совпадает / … | «хэш не совпадает» → запись отклонена |
| Качество сигнала | high / medium / low / unusable | unusable → отклонена |
| Калибровка | калибровка сеанса / первый период покоя / нет | «нет» → отклонена (не нашли 3 с неподвижности) |
| Повторений найдено / полных | сколько нашёл сегментатор и сколько годятся | полные < найденных — смотри «исключено» |
| Граница дрейфа относительного курса, °/с | оценка ухода гироскопа после калибровки | обычно сотые доли; > 0,5 °/с — оценка `humerothoracic` ненадёжна |
| Недоступные каналы | каналы, которых нет из-за отсутствующего датчика | например, без датчика груди нет `trunk_*` и `humerothoracic` |

Ниже строка: каналы представления, каналы «только для показа», сколько повторений использовано и исключено.

### 6.5 «Компоненты координации»

**Что это.** Повторения раскладываются на несколько главных «способов отличаться». C1 — самое сильное различие
между повторениями, C2 — следующее и т. д.

**Таблица:**

| Колонка | Как читать |
|---|---|
| Объяснённая дисперсия | какую долю всех различий описывает компонента |
| Дисперсия / 95 % параллельного анализа | компонента должна быть **больше** второго числа (иначе это неотличимо от случайности) |
| Конгруэнтность (бутстреп) | насколько форма компоненты повторяется на случайных подвыборках; нужно ≥ 0,85 |
| RMSE реконструкции | ошибка, если описывать повторения только первыми k компонентами (проверка на отложенных повторениях) |
| Сохранена | «да» — компонента прошла все три условия |

Строка «Причины» объясняет, почему следующая компонента не сохранена (см. раздел 8).

**Графики компонент.** Заголовок вроде `C1 — trunk_pitch 95 % · …` — какие каналы участвуют в компоненте.
Кривая — средняя траектория канала, полоса — как кривая меняется при движении вдоль компоненты (±2 SD).
Широкая полоса у канала = компонента в основном про этот канал.

Пример синтетического демо: **C1 на 95 % — наклон туловища** (стратегии отличаются туловищем), C2 — локоть и
предплечье (естественный разброс).

**Чувствительность к выравниванию** — совпадение компонент при двух способах выравнивания времени. Около 1 —
вывод не зависит от выравнивания; низкое — осторожно.

### 6.6 «Пространство координации»

Каждая отметка — одно повторение. **Цвет** — стратегия (синий A, оранжевый B, зелёный C, жёлтый D, серый —
неуверенно или стратегий нет). **Форма** — сеанс (круг, квадрат, треугольник, ромб по кругу).
**Щелчок по точке** выбирает повторение для сравнения (до двух; номер 1 и 2 рядом с точкой).
Если компонент нет — оси показывают результат.

### 6.7 «Двигательные стратегии»

- **Бейдж вердикта** — см. раздел 7.
- **Строка BIC** — качество модели при K = 1…4 группах, выбранное K, ΔBIC (выигрыш против «одной группы»),
  бутстреп ARI, Jaccard каждой группы, согласие с кластеризацией Уорда, разделение в SD. Пороги — в разделе 7.
- **Последовательность стратегий** — плашки по времени, промежуток = новый сеанс, бледность = меньше уверенность,
  «?» = неуверенно. Щелчок выбирает повторение для сравнения.
- **Таблица паттернов** — сигнатура каждой стратегии: n, средняя уверенность, результат, экскурсии каждого канала,
  вклад туловища, задержка включения туловища относительно руки, длительности «туда/обратно», разброс внутри.
  Если стратегий нет — одна строка **«все повторения (описательно)»**: это не стратегия, а просто описание.
- **Графики по каналам** — средняя кривая каждой стратегии ± SD по шкале «% движения» с отметками начала,
  достижения, ухода, конца. `humerothoracic` подписан «оцениваемый канал».
- **Таблица переходов** (если стратегий ≥ 2) — сколько раз за повторением стратегии X шло повторение стратегии Y,
  с вероятностями и 95 % достоверными интервалами; частота смен; p теста устойчивости (маленькое — стратегии
  «держатся», меняются реже случайного); вновь появляющиеся стратегии.
- **Внутри повторений** — отдельный поиск по фазе «туда» и по фазе «обратно»: одинаково ли организованы обе половины.

### 6.8 «Диссоциация выполнения и стратегии»

Карточка на каждую пару: «Стратегия A против B» и «first session против last session».

Строка параметров:
- `n = 20 / 20 (отброшено при подборе по результату: 8 / 0)` — сколько повторений сравнивается после подбора
  пар с похожим результатом;
- `результат 120.4° против 119.1°, Δ −1.3° [90 % CI −3.7, 1.2] эквивалентны` — **сначала проверяется, что
  результат одинаковый**; если нет — дальше не идём (вердикт «результаты не эквивалентны»);
- `pFWE` — значимость различия траекторий с учётом всех каналов и точек;
- `max|t| (критическое)` — наибольшее различие и порог;
- `RMS` — общее различие средних траекторий в градусах;
- `воспроизведение на половинах` — доля случайных разбиений, где различие значимо в обеих половинах (1,0 — отлично).

Таблица по каналам: RMS-различие с доверительным интервалом, **доля различия** (где оно), значимые участки
(«8–95 % (18.3°)» — с 8 по 95 % движения, пик 18,3°). Ниже — доля по фазам и различия компонент (d Коэна).
Графики «среднее различие B − A», жёлтым — значимые участки.

**Как читать на демо:** туловище даёт 93 % различия, результат одинаковый, p_FWE 0,0005 → «диссоциация»:
одинаковый результат, разная организация, различие в наклоне туловища.

Для сравнения **между сеансами** различие должно ещё и превышать допуск на переустановку датчиков (2,5°),
иначе вердикт «в пределах допуска на переустановку».

### 6.9 «Сравнение двух повторений»

Выберите две точки (в пространстве координации или в последовательности). Показывается:
- результат каждого и их разница («в пределах ±5°» или нет);
- общее RMS-различие;
- **перцентиль среди опорных пар**: как это различие соотносится с различиями между повторениями **одной и той
  же стратегии (или одного сеанса) с похожим результатом**. Выше 95-го перцентиля → «превышает типичную
  вариабельность»;
- где различие (доли по каналам);
- для каждого канала: две кривые на шкале «% движения» и исходные сигналы во времени («с от начала») с
  границами фаз и серыми полосами их неопределённости.

Это главный инструмент «показать, почему движок считает два повторения разными» — исследователь видит сами
траектории, а не только число.

### 6.10 «Изменение стратегий во времени»

Одна строка — один сеанс участника:

| Колонка | Смысл |
|---|---|
| Результат (выполнение) | средний результат ± SD — **выполнение**, отдельно от координации |
| Стратегия A, B, …, неуверенно | сколько повторений каждой стратегии |
| Энтропия стратегий | разнообразие используемых стратегий (0 — одна стратегия, 1 бит — две поровну) с 95 % ДИ |
| Вариабельность координации | средний разброс повторений вокруг средней траектории сеанса, ° |
| Расстояние от исходного уровня | насколько средняя траектория сеанса отличается от первого сеанса, с ДИ и p; **«изменилось»** — только если p < 0,05 **и** больше допуска 2,5° |
| От предыдущего | различие с прошлым сеансом |

Под таблицей — выбор модели изменения (существующий движок обучения) отдельно для результата, расстояния от
исходного уровня и вариабельности. «stationary» = изменений не видно; при < 3 сеансах модели не строятся.

Важно: **меньшая вариабельность не считается «лучше»**, частая стратегия тоже не «лучше».

### 6.11 «Допущения и версии»

Раскрывающийся блок: все допущения, при которых верны числа, версии компонентов, тип представления. Этот блок
обязан быть у каждого результата.

---

## 7. Все вердикты

### Компоненты координации

| Статус | Значение |
|---|---|
| подтверждено (`supported`) | есть хотя бы одна компонента, прошедшая все проверки |
| нет структуры (`no_structure`) | различия между повторениями неотличимы от случайных |
| недостаточно данных (`insufficient_data`) | меньше 10 повторений |

### Стратегии

| Вердикт | Значение | Правило |
|---|---|---|
| несколько стратегий (`multiple_strategies`) | найдено ≥ 2 устойчивых группы | ΔBIC ≥ 10 **и** все проверки ниже |
| один паттерн (`single_pattern`) | данные лучше описываются одной группой | BIC выбирает K = 1 или выигрыш < 10 |
| не определено (`inconclusive`) | модель предлагает группы, но хотя бы одна проверка провалена | причины перечислены |
| недостаточно данных (`insufficient_data`) | меньше 12 повторений | — |

Проверки для «несколько стратегий»: самая маленькая группа ≥ max(3, 10 % повторений); бутстреп ARI ≥ 0,8;
Jaccard каждой группы ≥ 0,75; согласие с Уордом ARI ≥ 0,7; разделение ≥ 2 SD; при нескольких сеансах — группы
**встречаются вместе хотя бы в одном сеансе** (иначе нельзя отличить стратегию от переустановки датчиков).
K выбирается как наименьшее, чей BIC не хуже минимума больше чем на 6.

### Диссоциация

| Вердикт | Значение |
|---|---|
| диссоциация | результаты эквивалентны, траектории значимо различаются (и для разных сеансов — больше допуска 2,5°) |
| нет различия координации | результаты эквивалентны, значимого различия траекторий нет |
| в пределах допуска на переустановку | различие значимо, но между сеансами и не больше 2,5° |
| результаты не эквивалентны | результаты различаются — сравнивать организацию «при одинаковом результате» нельзя |
| недостаточно данных | меньше 5 повторений в группе после подбора |

---

## 8. Коды причин и сообщения

Движок пишет причины кодами (в интерфейсе — как есть). Расшифровка:

**Компоненты**

| Код | Значение |
|---|---|
| `only_N_repetitions` | повторений меньше 10 |
| `component_K_within_parallel_null` | компонента K не сильнее случайности |
| `component_K_not_reproducible` | форма компоненты K не повторяется на подвыборках |
| `component_K_needs_more_repetitions` | для K компонент нужно ≥ 5·K + 5 повторений |

**Стратегии**

| Код | Значение |
|---|---|
| `no_coordination_components` | нет компонент — искать группы не в чем |
| `only_N_repetitions_(minimum_12)` | мало повторений |
| `bic_prefers_one_pattern` / `bic_gain_X_below_10` | данные не поддерживают несколько групп |
| `smallest_cluster_X_below_Y` | одна из групп слишком мала |
| `bootstrap_ari_X_below_0.8` | разбиение неустойчиво |
| `cluster_K_jaccard_X_below_0.75` | группа K «разваливается» на подвыборках |
| `ward_agreement_X_below_0.7` | другой метод кластеризации не подтверждает |
| `separation_Xsd_below_2` | группы слишком близки |
| `clusters_coincide_with_sessions_(...)` | группы совпадают с сеансами — может быть переустановка датчиков |

**Диссоциация**

| Код | Значение |
|---|---|
| `after_outcome_matching_A_and_B_repetitions_(minimum_5_each)` | после подбора по результату мало пар |
| `outcomes_do_not_overlap:_...` | результаты не пересекаются вовсе |
| `outcome_difference_ci90_[a,b]_not_within_±5` | разница результатов не доказана малой |
| `cross_session_rms_X°_not_above_replacement_margin_2.50°` | различие между сеансами в пределах допуска |
| `p_fwe_X` | различие траекторий незначимо |

**Записи и повторения**

| Код / текст | Значение |
|---|---|
| `raw stream does not match its manifest (...)` | сырые данные изменились или повреждены — запись отклонена |
| `no calibration window (no 3 s still period)` | не нашли позу калибровки |
| `signal quality unusable` | сигнал непригоден |
| `missing_samples`, `onset_not_found`, `offset_not_found`, `peak_at_window_end` | повторение неполное (разрыв, край записи) |
| `landmarks_out_of_order` | границы фаз в неправильном порядке |
| `representation_channel_missing` | у повторения нет одного из каналов представления |

**Сообщения анализа**

| Код | Значение |
|---|---|
| `exercise_X_not_supported_...` | движение не поддерживается |
| `no_complete_repetitions_of_this_exercise_in_the_raw_recordings` | в сырых записях нет полных повторений этого движения |
| `channel_X_not_in_representation_(...)` | канал есть меньше чем в 90 % повторений |
| `channel_elbow_flex_not_validated_for_shoulder_abduction_(display_only)` | локоть при отведении не прошёл проверку точности — только показ |
| `several_participants_pooled...` | в анализ попало несколько участников |
| `strategy_transitions_not_estimated_(...)` | меньше двух стратегий — переходы не считаются |
| `fewer_than_3_sessions:_learning_models_not_fitted` | мало сеансов для моделей изменения |

---

## 9. Как это устроено внутри

### 9.1 Конвейер

```
сырые кадры (int16, 100 Гц, IndexedDB 'raw')
  │  provenance.ts — проверка манифеста (SHA-256)            → отказ при несовпадении
  ▼
channels.ts — каналы
  │  quality.ts (существующий) — качество сигнала
  │  калибровка: окно сеанса (3 с до calibration_done) или первые 3 с покоя
  │  GravityTracker (существующий) → наклоны trunk/upper/fore
  │  elbowFlexion (существующий) → локоть; NaN, если ось шарнира ближе 30° к вертикали
  │  quat.ts (Madgwick 6D) → humerothoracic (только оценка, только внутри повторений)
  ▼
segment.ts — повторения (countReps, существующий) + фазы с неопределённостью границ
  ▼
align.ts — выравнивание по ориентирам → 101 точка на канал; исходные сигналы сохраняются
  ▼
components.ts — поправка на результат → fPCA (SVD из ml-matrix) → правило выбора числа компонент
  ▼
strategy.ts — смесь гауссиан + BIC + проверки устойчивости → стратегии или отказ
  ▼
coordination.ts — описатели повторений и сигнатуры стратегий
  ▼
dissociation.ts — PSDA (подбор по результату, эквивалентность, перестановочный тест, вклады, репликация)
  ▼
longitudinal.ts — по сеансам + переходы + существующий lab/fit.ts compareModels
  ▼
engine.ts → McseResult (версии, допущения, происхождение) → mcse.worker.ts → CoordinationPage.tsx
```

### 9.2 Файлы

Движок — `src/lab/coord/` (чистый TypeScript, без React и без сети):

| Файл | За что отвечает |
|---|---|
| `channels.ts` | каталог каналов (`CHANNELS`: единицы, датчики, наблюдаемость, допущения) и расчёт каналов |
| `quat.ts` | кватернионы, фильтр Madgwick (6 осей) |
| `segment.ts` | повторения, фазы, неопределённость границ, начала каждого сегмента |
| `align.ts` | выравнивание по ориентирам/линейное, DTW, вектор признаков |
| `components.ts` | PCA/fPCA, правило числа компонент, поправка на результат, доли по каналам |
| `strategy.ts` | смесь гауссиан (EM), BIC, Уорд, правила отказа (`STRATEGY_RULE`) |
| `coordination.ts` | описатели повторения (экскурсии, вклад туловища, корреляции, задержки), сигнатуры |
| `dissociation.ts` | PSDA, сравнение пары, `REPLACEMENT_MARGIN_DEG` |
| `longitudinal.ts` | метрики по сеансам, марковские переходы, интеграция с `lab/fit.ts` |
| `engine.ts` | оркестровка `runMcse()`, поддерживаемые движения, каналы представления |
| `provenance.ts` | манифест сырых данных, проверка хэша, временная шкала из событий |
| `inputs.ts` | адаптеры: сеанс → вход движка, занятие практики → вход движка |
| `linalg.ts`, `stats.ts` | обёртка ml-matrix; бутстреп, ARI, энтропия, Дирихле |
| `synthetic.ts` | генератор синтетических движений с известной истиной |
| `demo.ts` | синтетический участник `SYN-DEMO` для кнопки на странице |
| `validation.ts` | набор проверок V1–V11 и критерии (`CRITERIA`) |
| `mcse.worker.ts` | фоновый поток для страницы |

Интерфейс — `src/features/motorlab/coordination/`: `CoordinationPage.tsx`, `charts.tsx`, `i18n.ts`; стили
`src/styles/coord.css` (все классы с префиксом `co`).

Изменения в общих файлах (минимальные): маршрут `labCoordination` в `src/app/router.ts`, `App.tsx`,
`Workspace.tsx`, `layout/AppShell.tsx`, `features/motorlab/MotorLabRoute.tsx`, плитка в `LabOverviewPage.tsx`;
`rawManifest` в `data/models.ts` (Session) и `lab/records.ts` (PracticeTrialSet); запись манифеста в
`state/sessionController.ts`; сырые кадры практики в `lab/practice.ts` и `features/rehab/LivePractice.tsx`.

### 9.3 Типовые задачи разработчика

**Добавить канал.** Добавить id в `CHANNEL_IDS` и описание в `CHANNELS` (единица, датчики, наблюдаемость,
допущения) → посчитать в `buildChannels` (NaN там, где величина не наблюдаема) → если канал должен участвовать в
представлении, добавить в `REPRESENTATION_CANDIDATES` (`engine.ts`; только наблюдаемые каналы в градусах) →
проверить точность на синтетике (добавить истину в V2) → поднять `COORD_VERSION` → прогнать полную проверку.

**Поддержать новое движение.** `taskChannel()` в `segment.ts` (какой канал — «результат»),
`SUPPORTED_EXERCISES` в `engine.ts`, при необходимости `NOT_VALIDATED_FOR`, генератор в `synthetic.ts`, проверки.

**Изменить правило или порог.** Только с научным обоснованием, **не** чтобы результаты «стали лучше». Затем:
поднять `COORD_VERSION`, прогнать полную проверку, записать изменение в историю запусков
`research/mcse-validation.md` §2, оставив прежние результаты.

**Добавить строку интерфейса.** Ключ — английский текст в `ct('…')`; русский и казахский перевод обязательно
в `coordination/i18n.ts` (типы требуют казахский для каждого ключа). Тест `coord-i18n.node.test.ts` упадёт, если
ключа нет. Строки лаборатории (`motorlab/i18n.ts`) не трогать — это отдельный словарь.

**Версии.** `COORD_VERSION` — отдельно от `LAB_VERSIONS`, чтобы изменения MCSE не помечали замороженные анализы
обучения как «посчитанные другим движком». Любое изменение, которое может изменить числа при тех же данных →
новая версия.

### 9.4 Детерминизм

Все случайные процедуры (бутстреп, перестановки, генератор) идут от фиксированных зёрен. Одинаковые данные +
одинаковая версия = одинаковые числа. Если тестировщик видит разные числа при повторном анализе тех же данных —
это баг.

---

## 10. Правила, которые нельзя нарушать

1. Синтетика и симулятор **всегда помечены**; в клинические данные не попадают.
2. Нельзя называть стратегии оценочно (компенсаторная, патологическая, правильная, эффективная).
3. Нельзя писать про мышцы, мозг, нейронные синергии, выздоровление.
4. Нельзя подменять недоступный канал оценкой — только «недоступен» с причиной.
5. Нельзя подкручивать пороги ради красивых результатов; любые изменения — с новой версией и перезапуском проверки.
6. Сырые данные неизменны; манифест не переписывается.
7. Данные участников не отправляются ни в какие внешние сервисы (движок работает в браузере).
8. Каждый результат показывает допущения, версии и происхождение данных.

---

## 11. Как тестировать

### 11.1 Сценарий A — синтетическая демонстрация (основной, 2 минуты)

1. Открыть `#/research/coordination` (любое пространство).
2. Нажать **«Синтетическая демонстрация»**, подождать 5–15 с.

Ожидается (числа детерминированы, должны совпадать при каждом запуске):

| Где | Ожидаемое |
|---|---|
| Плашка | «СИНТЕТИЧЕСКАЯ демонстрация — не участник» |
| Записи | 4 строки, источник «синтетика», «нет манифеста», качество high, «калибровка сеанса», 12 / 12 |
| Дрейф курса | сотые доли °/с |
| Компоненты | «подтверждено», сохранены C1 и C2; C1 ≈ 84 %, в C1 `trunk_pitch` ≈ 95 % |
| Стратегии | «несколько стратегий», выбрано K = 2, ΔBIC ≈ 60, бутстреп ARI 1.00, Ward ARI 1.00 |
| Сигнатуры | Стратегия A: n = 28, `trunk_pitch` ≈ −18°, `humerothoracic` ≈ 103°, вклад туловища ≈ 0,15; Стратегия B: n = 20, `trunk_pitch` ≈ 0°, `humerothoracic` ≈ 120°, вклад ≈ 0,01. Результат у обеих ≈ 120° |
| Последовательность | сеанс 1 — 12 × A; затем по сеансам A/B: 9/3, 5/7, 2/10 (это и есть «истина» генератора) |
| Диссоциация A против B | «диссоциация», результаты эквивалентны (Δ ≈ −1°), p_FWE ≈ 0,0005, `trunk_pitch` ≈ 90 % различия, воспроизведение ≈ 1,00 |
| Изменение во времени | сеансы 3 и 4 «изменилось»; сеанс 2 — p < 0,05, но без пометки (меньше допуска 2,5°) |

3. В последовательности щёлкнуть повторение `syn-SYN-DEMO-0#6` (A, ≈ 121°) и `syn-SYN-DEMO-1#7` (B, ≈ 120°).
   Ожидается в «Сравнении двух повторений»: разница результатов ≈ −1° «в пределах ±5°», перцентиль ≈ 100 %,
   **«превышает типичную вариабельность»**, `trunk_pitch` ≈ 98 % различия. Графики времени показывают границы фаз.
4. Повторный щелчок снимает выбор; третий выбор заменяет первый.

### 11.2 Сценарий B — настоящая запись через симулятор (проверка пути сохранения)

1. Демо-пространство → новый тест → устройство «Симулятор» → протокол, например стандартный → провести до конца.
2. Открыть страницу координации, выбрать этого пациента и движение.
3. «Доступные данные»: с сырыми кадрами ≥ 1, **с проверенным манифестом ≥ 1**.
4. «Анализировать записи» → в таблице записей «проверен», «калибровка сеанса», найдено ≈ 3 повторения.
5. Стратегии: **«недостаточно данных»** (3 повторения — так и должно быть).
6. Для ≥ 12 повторений: протокол «Выносливость: локоть» (60 с сгибаний поражённой рукой) или несколько сеансов подряд, движение
   «Сгибание локтя». Ожидается «один паттерн» или «не определено» (виртуальный пациент делает одно и то же).

### 11.3 Сценарий C — практика с записью

1. Двойник участника → «Записывать попытки практики» (в клинике — нужно активное согласие).
2. Детский режим → живая практика → несколько повторений → стоп.
3. На странице координации «занятий: N (с сырыми кадрами: N)». Анализ включает занятие с источником «занятие».
4. Выключить запись → новое занятие сырых кадров **не** сохраняет.

### 11.4 Отрицательные проверки

| Действие | Ожидается |
|---|---|
| Участник демо без своих тестов | с сырыми кадрами: 0, кнопка «Анализировать» неактивна |
| Движение `forearm_rotation` через адрес `?ex=forearm_rotation` | подставляется сгибание плеча (движение не поддерживается) |
| Меньше 12 повторений | стратегии «недостаточно данных» |
| Отведение плеча | сообщение `channel_elbow_flex_not_validated_for_shoulder_abduction_(display_only)`, локоть только в показе |
| Подмена сырых данных | покрыто автотестом (`coord.test.ts`): «хэш не совпадает», запись отклонена |
| Запись без датчика груди | `trunk_*`, `humerothoracic` в «недоступных каналах»; страница не падает |

### 11.5 Общие проверки интерфейса

- Языки: русский, казахский, английский (Настройки). Не должно быть английских «дыр» в русском/казахском, кроме
  кодов причин и имён каналов.
- Узкий экран (телефон): таблицы прокручиваются внутри карточек, страница без горизонтальной прокрутки.
- Тёмная тема, если включена: графики читаемы.
- Клавиатура: точки на графике и плашки последовательности выбираются Tab + Enter/пробел.
- Консоль браузера: без ошибок.
- Во время анализа страница отвечает (анализ в фоне).

### 11.6 Что считать багом

- Нет пометки синтетики/симуляции при таких данных.
- Числа синтетического демо отличаются между запусками или от таблицы 11.1.
- Стратегия названа оценочно.
- Канал показан, хотя датчика нет.
- Запись с несовпадающим манифестом проанализирована.
- «Диссоциация» при «результаты не эквивалентны».
- Падение страницы на любом сочетании участника/движения/руки.

---

## 12. Команды

Из папки `website/`:

```bash
npm run dev
```

```bash
npx vitest run src/lab/coord src/features/motorlab/coordination
```

Быстрая проверка (детерминированные критерии, ≈ 13 с) входит в обычный `npm test`.

Полная проверка (≈ 12 мин, в bash — скрипт `npm run coord:validate` не работает в cmd Windows):

```bash
COORD_VALIDATE_FULL=1 COORD_VALIDATE_NOASSERT=1 COORD_VALIDATE_OUT=../research/data/mcse-validation.json npx vitest run src/lab/coord/validation.node.test.ts
```

Сравнение с эталонными библиотеками (нужен Python с numpy, scipy, scikit-learn, tslearn, ahrs):

```bash
COORD_BENCH_OUT=../research/benchmarks/ts-outputs.json npx vitest run src/lab/coord/bench.node.test.ts
```

```bash
python -I ../research/benchmarks/compare.py ../research/benchmarks/ts-outputs.json ../research/benchmarks/results.json
```

Проверки перед коммитом:

```bash
npx tsc -b
```

```bash
npx eslint .
```

```bash
npm run check:api
```

Автотесты MCSE:

| Тест | Что проверяет |
|---|---|
| `coord.test.ts` | ориентация, каналы и их знаки, сегментация, отказы, логика диссоциации, манифест |
| `recording.test.ts` | путь настоящей записи: SessionEngine → сырые кадры → манифест → анализ |
| `fixtures.node.test.ts` | файлы прошивки отклоняются, а не анализируются |
| `validation.node.test.ts` | быстрая проверка V1–V4, V10 (V2d — задокументированный провал) |
| `coord-i18n.node.test.ts` | у каждого ключа есть русский и казахский перевод |
| `router.test.ts` | маршрут `labCoordination` |

---

## 13. Известные ограничения и провалы

| Что | Почему важно |
|---|---|
| **Нет анализа реальных детей** | в рабочей среде не было записей с сырыми кадрами; все цифры качества — синтетические |
| Проверка: 16 из 19 критериев | провалены V2d, V7a, V8b (ниже) |
| V2d: локоть при отведении, ошибка 7,1° (> 4°) | гравитация не несёт информации о локте, когда ось шарнира вертикальна → локоть исключён из анализа отведения |
| V7a: мощность диссоциации 0,60 при ≈ 12 повторениях на группу | нужно ≈ 24 (0,95 в дополнительном прогоне) |
| V8b: ложное «изменилось» 0,15 (> 0,10) | допуск 2,5° получен на симуляторе; нужно исследование повторного надевания датчиков |
| Курс (поворот вокруг вертикали) не наблюдаем | `humerothoracic` — только оценка внутри повторения |
| Перекос между датчиками внутри кадра 2–4 мс | оценён по времени шины, не измерен; разрешение задержек 10 мс |
| Сырые кадры практики не уходят на сервер | хранятся только в браузере |
| Сырые кадры практики не удаляются сбросом демо | ключ — id набора попыток, а не сеанса |
| Казахские строки | без проверки носителем языка |
| Тест `server/ai-and-access.test.ts` | иногда падает по таймауту при параллельном прогоне; отдельно проходит (было и до MCSE) |

---

## 14. Частые вопросы и неполадки

**Кнопка «Анализировать записи» неактивна.** У участника нет сеансов этого движения и этой руки с сырыми кадрами.
Заготовленная демо-история сырых кадров не имеет — проведите тест на симуляторе или нажмите синтетическую
демонстрацию.

**Везде «недостаточно данных».** Нормально для 1–3 клинических сеансов (3 повторения на движение). Нужно ≥ 12
повторений одного движения одной руки (лучше 24+): практика с записью или протокол «Выносливость: локоть».

**«Нет манифеста».** Сеанс записан до 8.11.2026 или это синтетика — анализируется, но неизменность не проверена.

**«Хэш не совпадает».** Сырые данные в браузере изменились или повреждены. Запись намеренно не анализируется.
Сообщить разработчикам; данные не исправлять.

**Почему «один паттерн», хотя ребёнок «явно делает по-разному»?** Различие может быть меньше обычного разброса,
или групп слишком мало повторений. Движок обязан не выдумывать стратегии. Посмотрите «Пространство координации» и
сравните пару повторений вручную.

**Почему «не определено» с причиной `clusters_coincide_with_sessions`?** Группы разделяют целые сеансы — это может
быть из-за того, что датчики надели немного по-другому. Нужны сеансы, где обе стратегии встречаются вместе.

**Почему наклон туловища «назад» — это стратегия, повышающая подъём руки?** Угол руки считается от вертикали.
Откинувшись назад на 18°, ребёнок поднимает руку в мире на 18° выше при том же движении в плече
(`docs/ENGINEERING_10H/COORDINATES.md` §4).

**Что за `humerothoracic` и почему «только для показа»?** Угол между плечом и туловищем. Для него нужен
относительный курс двух датчиков, который без магнитометра берётся интегрированием гироскопа и «уплывает».
Поэтому он оценка внутри одного повторения и в поиске стратегий не участвует.

**Анализ долгий.** ~50 повторений — несколько секунд. Сотни повторений — дольше (бутстреп и перестановки).
Страница при этом не зависает. Если зависает — баг.

**Где посмотреть научные детали?** `research/mcse-report.md` (что сделано и что заимствовано),
`research/mcse-validation.md` (критерии и результаты), `research/prior-art-analysis.md` (откуда методы).
