Amir10202010/neuromove/website/docs/BUILD_EXECUTION.md

# NeuroMove — ход работ сессии 1 октября 2026

Сессия на компьютере B (macOS), начало — 20:35 (+05). Задание: довести существующий MVP
до самого сильного честного состояния за ~3 часа: аудит, исследование, исправления, проверка,
документы. Этот файл — журнал и бэклог; итог — в конце.

## 1. Факты: что есть на старте (проверено)

| Что | Факт | Как проверено |
|---|---|---|
| Продукт | Объективная оценка движений рук у детей с ДЦП: IMU-датчики → углы, симметрия, плавность (SPARC), наклон туловища → отчёт и динамика курса | `README.md`, питч, код `src/core` |
| Пользователи по документам | врач-реабилитолог, инструктор ЛФК, исследователь (роли в онбординге); семья — «Отчёт для семьи» | `OnboardingPage.tsx`, `FamilyReportPage.tsx` |
| Стек | Vite 7, React 19, TypeScript 6 strict, Zustand, IndexedDB (`idb`), Vitest | `package.json` |
| Сервер | **нет**. Всё в браузере, данные в IndexedDB этого компьютера | `src/data/db.ts`, поиск `fetch|XMLHttpRequest|WebSocket` — пусто |
| Железо | **нет**. Симулятор MPU-6050 + модель тела; USB (Web Serial) и Bluetooth написаны по контракту imu-csv v1 и не проверены на устройстве | `src/devices`, `src/simulation` |
| Разделение демо и клиники | два пространства; `Session.demo`, `device.simulated`; симулятор только в демо; «ДЕМО» в отчётах и печати | `models.ts`, `SessionSetupPage.tsx` |
| Вход | пароля нет: «пространство клиники» — локальный профиль специалиста | `OnboardingPage.tsx` |
| Базовая проверка | `typecheck` — 0 ошибок; `lint` — 0; `npm test` — 90/90; `npm run build` — ок (JS 760 КБ, gzip 226 КБ); `npm audit` — 0 уязвимостей | запуск 20:36 |
| Живой путь | лендинг → «Попробовать демо» → P01 → новый тест → датчики → калибровка → тест вживую; перезагрузка посреди теста → «Сеанс был прерван» → продолжить | браузер, 1280×800 |

## 2. Допущения (не проверены, решения обратимы)

- Демо-день инкубатора 11 декабря 2026 — главный показ; до него приложение остаётся без сервера.
- Клиника-партнёр будет работать в Chrome или Edge на компьютере (вопрос 6 к центру в `README.md`).
- Кто-то, кроме специалиста, может иметь доступ к тому же компьютеру — поэтому про отсутствие пароля говорим прямо.
- Казахский текст новых строк — без проверки носителем, как и прежний.

## 3. Найдено при аудите

| # | Что | Почему важно | Приоритет |
|---|---|---|---|
| A1 | `csvCell` не обезвреживает формулы: строка, начинающаяся с `=`, `+`, `-`, `@`, попадёт в Excel как формула. Код пациента из формы ограничен `[A-Z0-9-]`, но из архива JSON — любая строка | CSV/formula injection (OWASP) при открытии выгрузки в Excel | P0 |
| A2 | Повтор записи (`ReplayDevice`) не смотрит на паспорт `demo=yes`: выгрузку из демо можно проиграть в пространстве клиники и сохранить как настоящий замер ребёнка | демо выглядит как настоящие данные | P0 |
| A3 | Файлы записи и архива читаются целиком без проверки размера; значения вне int16 молча заворачиваются | зависание вкладки; искажённые числа без ошибки | P1 |
| A4 | Архив JSON: код пациента и тексты не ограничены ни шаблоном, ни длиной | вход для A1, раздувание хранилища | P0 (вместе с A1) |
| A5 | На фото первого экрана нет подписи «концепт» (снята 29 сентября); «Надеваются за минуту», «подписывает заключение», «сразу видно, если датчик сполз» — про то, чего ещё нет | обещания без доказательств на первом экране | P0 |
| A6 | «Войти» в шапке лендинга — пароля нет, это локальный профиль; в онбординге не сказано, что данные видит любой у этого браузера | ложное ощущение защиты | P0 |
| A7 | Знак `/brand/neuromove-logo.svg` — абсолютный путь: в `demo/NeuroMove.html` с диска и в подпапке GitHub Pages картинка не грузится; знак занимает ~⅓ холста — в шапке 14 px | сломанная картинка на показе без интернета | P1 |
| A8 | Нет политики безопасности контента (CSP): обещание «данные не уходят с компьютера» держится только на том, что в коде нет сетевых вызовов | обещание не закреплено технически | P1 |
| A9 | Гид демо живёт только в памяти: обновили страницу посреди показа — гид пропал | срыв показа | P1 |
| A10 | Имена файлов выгрузки не говорят, демо это или нет; в CSV метрик нет источника данных (симулятор, файл, USB) | файл на диске можно спутать с настоящим | P1 |
| A11 | Нет сквозных тестов в браузере, нет проверки ширины экрана и доступности автоматически | регрессии видны только руками | P1 |
| A12 | Нет документов: исследование с источниками, стратегия, архитектура с диаграммами, безопасность, развёртывание, сценарий демо, план | показ инкубатору и врачам | P1 |

## 4. Бэклог с критериями приёмки — статус на конец сессии

✓ — сделано и проверено; ◐ — сделано частично; ✗ — не делали, причина в строке.

### P0

| ID | Задача | Статус | Чем проверено |
|---|---|---|---|
| P0-1 | CSV без формул; код пациента и длина текстов в архиве | ✓ | `export.test.ts`, `backup.test.ts`; OWASP — ещё перевод строки и широкие `＝＋－＠` |
| P0-2 | Повтор выгрузки из демо в клинике — отказ; смоделированный сеанс не сохраняется в клинику никаким путём | ✓ | юнит-тесты; e2e на сконструированном файле и на настоящей выгрузке из демо |
| P0-3 | Честные подписи на лендинге, три языка | ✓ | e2e видит «Фото — концепт…»; ручной просмотр 375 px |
| P0-4 | «Клиника» вместо «Войти»; «Пароля нет» в онбординге, «Настройках», на лендинге | ✓ | e2e проходит онбординг |

### P1

| ID | Задача | Статус | Чем проверено |
|---|---|---|---|
| P1-1 | Предел размера файлов; int16 вне диапазона — ошибка | ✓ | юнит-тест int16 |
| P1-2 | Знак: обрезан, через `import`, иконка вкладки | ✓ | e2e: демо с диска, все картинки загружены |
| P1-3 | CSP в обеих сборках | ✓ | e2e: `fetch` заблокирован |
| P1-4 | Гид переживает перезагрузку | ✓ | e2e на компьютере и телефоне |
| P1-5 | `DEMO` в именах файлов, столбец `source` | ✓ | юнит-тест; e2e: имя `neuromove-DEMO-P01-…-raw.csv` |
| P1-6 | Сквозные тесты, ширины, axe | ✓ | 22 теста; найденные дефекты и исправления — `docs/TEST_REPORT.md`, раздел 2 |
| P1-7 | Документы | ✓ | `npm run docs:check` — диаграммы рендерятся; источники открыты |
| P1-8 | Пересобрать `demo/NeuroMove.html` | ✓ | e2e открывает его с диска |

### Добавлено по ходу — найдено циклом «что сломается на показе и на стенде»

| ID | Задача | Статус |
|---|---|---|
| N-1 | Меню «Сбои» обрезалось на телефоне — портал над панелью | ✓ e2e на Pixel 7 |
| N-2 | Контраст текста по WCAG AA на всех экранах и лендинге | ✓ axe |
| N-3 | Таблица печатного отчёта и отчёт для семьи на 320 px; казахские кнопки печати | ✓ e2e на трёх языках |
| N-4 | Заголовок вкладки по экрану (WCAG 2.4.2) | ✓ e2e |
| N-5 | «Запись из файла» на отчёте и в печати | ✓ |
| N-6 | Поток USB: куски, мусор, перезагрузка платы, 16-битный seq | ✓ юнит-тесты; на железе — нет |
| N-7 | Проверка точности по отметкам эталона (`core/validation.ts`) и экран для неё | ✓ юнит- и e2e-тесты на записи станка из симулятора |
| N-8 | Запись с датчиков с отметками эталона в приложении — вместо `record.py` | ✓ e2e на симуляторе; на стенде — нет |
| N-9 | WCAG 2.2: размер цели 24 × 24 px и «фокус не перекрыт» на компьютере и телефоне | ✓ axe и свой e2e |
| N-10 | «Пример: станок на симуляторе» — метод проверки точности за один клик для показа | ✓ e2e |

### P2 — не делали в этой сессии

| ID | Задача | Почему нет |
|---|---|---|
| P2-1 | Шифрование данных клиники паролем | риск потерять данные при забытом пароле; сначала решение центра (`docs/ROADMAP.md`, раздел 4) |
| P2-2 | Срок хранения | решает центр |
| P2-3 | Сервер, роли, журнал доступа | нужен ответ юриста о месте хранения (ст. 12 закона № 94-V) |
| — | CI в GitHub Actions | расходует минуты аккаунта — нужно согласие Амирхана |
| — | Деление кода лендинга и приложения | замер: лендинг ~0.1 с, выигрыш только на медленной сети |

## 5. Журнал — время по часам компьютера

| Время | Что |
|---|---|
| 20:35 | `git fetch`, статус чистый, на одном уровне с `origin/main` |
| 20:36 | базовые проверки — все зелёные (раздел 1) |
| 20:37–20:41 | живой проход в браузере; чтение кода данных, выгрузки, повтора записи, лендинга; бэклог |
| 20:41–20:56 | P0-1…P0-4, знак, CSP, гид, имена файлов; Playwright; первый прогон — 9 из 11, исправлены ширины и контраст |
| 20:56 | контрольная точка 1 (`80f20d9`) |
| 20:57–21:06 | исследование: 28 источников, каждый открыт; PubMed, MDPI, Wiley, adilet — через браузер |
| 21:06–21:19 | меню «Сбои» на телефоне, «Запись из файла», архитектура (диаграммы проверены рендером), безопасность, стратегия |
| 21:19 | контрольная точка 2 (`72c476b`) |
| 21:19–21:41 | заголовки вкладок, казахский на 320 px, развёртывание, сценарий показа, план, отчёт о тестах; поток USB; проверка точности |
| 21:41 | контрольная точка 3 (`67102ca`) |
| 21:41–21:48 | запись с датчиков с отметками эталона |
| 21:48 | контрольная точка 4 (`9bdc8f0`) |
| 21:48–21:53 | предел записи 15 минут, документы, финальная регрессия, журнал в `log/` |
| 21:54 | контрольная точка 5 (`721dd3e`), push в `origin/main` |
| 21:54–21:56 | ревью своего кода: три дефекта состояния в «Проверке точности» исправлены; e2e — водяной знак демо в печати и отчёте для семьи, путь повтора лабораторной записи в клинике |
| 21:57–22:07 | WCAG 2.2: размер цели (axe) и «фокус не перекрыт» — проход Tab по экранам; `scroll-padding`, первый экран лендинга; e2e — 22 теста |
| 22:07–22:12 | «Пример: станок на симуляторе», отведение руки в проверке точности; страховка «не Safari» в сценарии показа; финальная регрессия — 112 юнит, 23 e2e |

## 6. Итог

Работающий путь: лендинг → демо → карточка → тест вживую (обрыв связи, перезагрузка посреди теста)
→ отчёт → карточка с динамикой → все пациенты; отчёт для семьи и печать; пространство клиники
с честным онбордингом; повтор записи с отказом для демо-файлов; проверка точности по отметкам
эталона и запись для неё. Всё — на симуляторе: настоящего железа и измерений на людях нет.

Что проверено и как — `docs/TEST_REPORT.md`. Что не закрыто — `docs/SECURITY_PRIVACY.md`, раздел 3,
и `docs/ROADMAP.md`. Решения, которые принимает не программист, — в отчёте сессии
(`log/2026-10-01-neuromove-продакшн-проход.md`).
