Amir10202010/neuromove/firmware/test/fixtures/drop-and-return.csv

# imu-csv v1
# device=NM-01 fw=0.1 rate_hz=100 acc_g=4 gyro_dps=1000 sensors=trunk,upper_r,fore_r
# board=esp32s3 i2c_hz=100000 arm=right
# id_trunk=5A4C6311 id_upper_r=5A4C6322 id_fore_r=5A4C6333
seq,trunk_ax,trunk_ay,trunk_az,trunk_gx,trunk_gy,trunk_gz,upper_r_ax,upper_r_ay,upper_r_az,upper_r_gx,upper_r_gy,upper_r_gz,fore_r_ax,fore_r_ay,fore_r_az,fore_r_gx,fore_r_gy,fore_r_gz
0,-8192,0,50,-3,0,0,-8192,100,47,-3,0,1000,-8192,200,44,-3,0,2000
1,-8191,-1,50,-2,-1,0,-8191,99,47,-2,-1,1000,-8191,199,44,-2,-1,2000
2,-8190,-2,50,-1,-2,0,-8190,98,47,-1,-2,1000,-8190,198,44,-1,-2,2000
# fore_r: 10 чтений подряд без ответа — перезапускаю шину 1
# fore_r: 10 чтений подряд без ответа — перезапускаю шину 1
# fore_r: 10 чтений подряд без ответа — перезапускаю шину 1
# fore_r: не отвечает после 3 перезапусков — убираю из потока; вернётся сам, когда ответит
# imu-csv v1
# device=NM-01 fw=0.1 rate_hz=100 acc_g=4 gyro_dps=1000 sensors=trunk,upper_r
# board=esp32s3 i2c_hz=100000 arm=right
# id_trunk=5A4C6311 id_upper_r=5A4C6322
seq,trunk_ax,trunk_ay,trunk_az,trunk_gx,trunk_gy,trunk_gz,upper_r_ax,upper_r_ay,upper_r_az,upper_r_gx,upper_r_gy,upper_r_gz
33,-8159,-33,50,2,-33,0,-8159,67,47,2,-33,1000
34,-8158,-34,50,3,-34,0,-8158,66,47,3,-34,1000
35,-8157,-35,50,-3,-35,0,-8157,65,47,-3,-35,1000
36,-8156,-36,50,-2,-36,0,-8156,64,47,-2,-36,1000
37,-8155,-37,50,-1,-37,0,-8155,63,47,-1,-37,1000
38,-8154,-38,50,0,-38,0,-8154,62,47,0,-38,1000
39,-8153,-39,50,1,-39,0,-8153,61,47,1,-39,1000
40,-8152,-40,50,2,-40,0,-8152,60,47,2,-40,1000
# imu-csv v1
# device=NM-01 fw=0.1 rate_hz=100 acc_g=4 gyro_dps=1000 sensors=trunk,upper_r,fore_r
# board=esp32s3 i2c_hz=100000 arm=right
# id_trunk=5A4C6311 id_upper_r=5A4C6322 id_fore_r=5A4C6333
seq,trunk_ax,trunk_ay,trunk_az,trunk_gx,trunk_gy,trunk_gz,upper_r_ax,upper_r_ay,upper_r_az,upper_r_gx,upper_r_gy,upper_r_gz,fore_r_ax,fore_r_ay,fore_r_az,fore_r_gx,fore_r_gy,fore_r_gz
540,-8151,-41,50,3,-41,0,-8151,59,47,3,-41,1000,-8189,197,44,0,-3,2000
541,-8150,-42,50,-3,-42,0,-8150,58,47,-3,-42,1000,-8188,196,44,1,-4,2000
542,-8149,-43,50,-2,-43,0,-8149,57,47,-2,-43,1000,-8187,195,44,2,-5,2000
