Amir10202010/neuromove/website/docs/TEST_REPORT.md

# NeuroMove — отчёт о проверке

## 18 октября 2026, ночь, Apple — движение стартовой как на презентациях Apple

Что менялось: появление текста по замерам apple.com; сцена «Датчики» с раскрытием фото во весь
экран; модель «Как это работает», рука на листе отчёта и хронофотография — от прокрутки; планшет
поднимается и встаёт; карточки «Проверки» поднимаются без прозрачности; панель полупрозрачная
(`DESIGN_SYSTEM.md`, раздел 7). Перед этим откат ночного прохода «как у Neuralink» (`d5a703d`).
Приложение, алгоритмы и числа демо не менялись.

| Проверка | Команда | Итог |
|---|---|---|
| Типы и линтер | `npm run typecheck`, `npm run lint` | 0 / 0 |
| Юнит-тесты | `npm test` | 258 из 258 |
| Сквозные тесты, Chrome | `npm run e2e` | **40 из 40**, компьютер и Pixel 7. Новые: текст ждёт линии 82 % и поднимается на 30 px; фото датчика раскрывается прокруткой, заголовок поднимается поверх; модель разбирается вместе с прокруткой и стоит, если прокрутки нет; рука на шкале идёт к 144° вместе с прокруткой; прокрутка «проигрывает» хронофотографию |
| Диаграммы | `npm run docs:check` | 18 из 18 |
| Демо одним файлом | `npm run build:demo` | 1,85 МБ; с диска открывается, ошибок нет |
| Скорость, рабочая сборка | `scripts/perf-landing.mjs` | телефон: LCP 2,45 с (фото первого экрана), CLS 0; компьютер: LCP 0,98 с — заголовок первого экрана теперь появляется подъёмом, как у Apple (было 0,12 с); длинных задач на сценах нет |

Вживую: видео непрерывной прокрутки всей страницы (1280 × 800), кадры через 0,75 с; снимки сцен
«Датчики» и «Как это работает» в 8–10 точках прокрутки на 1440 и 390 px.

## 18 октября 2026, поздно вечером — светлые секции белые

Что менялось: светлые секции стартовой страницы — `#ffffff` вместо «бумаги» `#f3f1eb`, серые на
них нейтральные (текст `#0b0b0c`, абзац `#55555c`, подпись `#6e6e76`), тема `paper` убрана из кода.
Приложение не менялось.

| Проверка | Команда | Итог |
|---|---|---|
| Типы и линтер | `npm run typecheck`, `npm run lint` | 0 / 0 |
| Юнит-тесты | `npm test` | 258 из 258 |
| Сквозные тесты, Chrome | `npm run e2e` | **35 из 35**, компьютер и Pixel 7; axe — без нарушений контраста на новых серых |
| Демо одним файлом | `npm run build:demo` | 1,85 МБ; с диска: «Сегодня», «Семьям», подвал и шапка белые, ошибок нет |

Вживую: снимки 1440 × 900 (вся страница, первый экран, «Сегодня», «Семьям», подвал) и 390 × 844.

## 18 октября 2026, вечер — рисунки, инфографика и анимации стартовой страницы

Что менялось: тест вживую с туром и подсветкой части экрана, «Отчёт» слит с «Семьям» (на листе
шкала угла), «Специалистам» — хронофотография движений из модели, «Проверка» и «Данные» —
карточки с инфографикой, анимации у каждого рисунка свои (`DESIGN_AUDIT.md`, раздел «18 октября,
вечер»). Приложение, алгоритмы и числа демо не менялись.

| Проверка | Команда | Итог |
|---|---|---|
| Типы и линтер | `npm run typecheck`, `npm run lint` | 0 / 0 |
| Юнит-тесты | `npm test` | 258 из 258, 20 файлов (+7: `studyData.test.ts` — кадры через 0,1 с, пик, повторяемость, помощь корпусом; сверка 60 / 55 / 5 с файлом прогона в `proofData.node.test.ts`) |
| Сквозные тесты, Chrome | `npm run e2e` | **35 из 35**, компьютер и Pixel 7 (+2: тур под планшетом, рисунки «Специалистам») |
| Доступность | axe в `e2e/layout-a11y.spec.ts` и отдельно стартовая на ru, kk, en | нарушений нет. Первый прогон нашёл подпись «Интернет» с контрастом 3,4:1 — исправлено |
| Диаграммы | `npm run docs:check` | 18 из 18 |
| Демо одним файлом | `npm run build:demo` | 1,85 МБ; с диска открывается, четыре рисунка движений, 60 точек, клин 41° → 1,6°, шкала на листе отчёта; ошибок в консоли нет |
| Скорость, рабочая сборка | `scripts/perf-landing.mjs` | телефон: LCP 2,42–2,44 с, CLS 0,003; компьютер: LCP 0,12 с; длинных задач нет |

Первый полный прогон сквозных тестов дал 5 падений: 4 — `ENOENT` у файлов трассировки, потому что
я параллельно запустил второй прогон Playwright, и он очистил общую папку `e2e-results`; пятое —
контраст подписи «Интернет». Повторный прогон без параллельного запуска: 35 из 35.

Вживую: снимки каждой секции 1440 × 900 на ru, kk, en и 390 × 844 на ru и kk, раскадровка
анимаций хронофотографии и клина ошибки. На телефоне число «41°» налезало на подпись карточки — исправлено.

## 18 октября 2026, утро — сцена с моделью вернулась, чёрный фон, типографика как у Neuralink

Что менялось: по просьбе Амирхана снят прибор «Из сигнала в градусы» и возвращена сцена «Как это
работает» с разборной моделью датчика; тёмные секции чисто чёрные; заголовки, подписи разделов
и меню по замерам neuralink.com (`DESIGN_AUDIT.md`, раздел «18 октября»). Приложение, алгоритмы
и числа демо не менялись.

| Проверка | Команда | Итог |
|---|---|---|
| Типы и линтер | `npm run typecheck`, `npm run lint` | 0 / 0 |
| Юнит-тесты | `npm test` | 251 из 251, 19 файлов (−6 вместе с прибором: файл `signalTrace.test.ts` удалён) |
| Сквозные тесты, Chrome | `npm run e2e` | **33 из 33**, компьютер и Pixel 7 (−2: тест прибора на компьютере и телефоне) |
| Диаграммы | `npm run docs:check` | 18 из 18 |
| Демо одним файлом | `npm run build:demo` | 1,85 МБ; с диска открывается, сцена с моделью на чёрном, живой угол идёт, ошибок в консоли нет |
| Скорость, рабочая сборка | `scripts/perf-landing.mjs` | телефон: LCP 2,39–2,41 с, CLS 0,003; компьютер: LCP 0,11 с; длинных задач за 10 с на сцене с моделью нет |

Вживую: снимки каждой секции на 1440 × 900 и телефона 375 × 812. Меню над чёрными секциями
становится чёрным, когда секция доходит до середины его высоты.

## 18 октября 2026, ночь — стартовая страница «Протокол измерения», прибор, скорость

> Прибор из этой записи снят утром 18 октября (запись выше).

Что менялось: прибор «Из сигнала в градусы» вместо разборной модели, секции «Проверка» и «Данные»,
четыре движения у «Специалистам», экран теста на странице по раскладке приложения, телефонный первый
экран, моно-шрифт с казахскими буквами, подпись метода локтя, экраны приложения отдельным куском
сборки, предзагрузка фото, фокус в окнах (`DESIGN_AUDIT.md`). Алгоритмы, движок и числа демо не менялись.

| Проверка | Команда | Итог |
|---|---|---|
| Типы и линтер | `npm run typecheck`, `npm run lint` | 0 / 0 |
| Юнит-тесты | `npm test` | 257 из 257, 20 файлов (+13: прибор и сверка графика «Проверки» с файлами прогона) |
| Сквозные тесты, Chrome | `npm run e2e` | **35 из 35**, компьютер и Pixel 7: 27 прежних и 5 новых в `e2e/landing.spec.ts` (три из них — и на телефоне) |
| Диаграммы | `npm run docs:check` | 18 из 18 |
| Демо одним файлом | `npm run build:demo` | 1,86 МБ; с диска открывается, прибор считает и идёт, «Попробовать демо» ведёт в карточку, ошибок в консоли нет |
| Скорость, рабочая сборка | `scripts/perf-landing.mjs` | ниже |

Скорость стартовой страницы (`vite preview`, Chrome; телефон — 375 × 812, процессор ×4, 150 мс,
1,6 Мбит/с, как профиль Lighthouse):

| | До правок скорости | После |
|---|---|---|
| LCP, телефон | 2,96 с (фото ждёт весь скрипт) | **2,42–2,45 с** в трёх замерах подряд |
| CLS за прокрутку всей страницы, телефон, первое открытие | 0,32 | **0,006** |
| LCP, компьютер 1440 × 900 без замедления | 0,15 с (заголовок) | 0,15 с |
| Скрипт первого экрана | 857 КБ (257 КБ сжатого) | 629 КБ (197 КБ); экраны приложения — 231 КБ отдельно, в свободное время |
| Длинные задачи за 10 с работы прибора | — | 0 |

Как найдены и проверены новые ошибки:

- Сравнение «на глаз / NeuroMove» не показывалось никогда (A1). Новый сквозной тест на старом коде
  падает, на исправленном проходит — проверено откатом.
- Фокус уходил из окна вступления демо на экран под ним (B3) — было и до прохода: сверено на файле
  демо из прошлого коммита. Новый сквозной тест: после «Попробовать демо» и Tab фокус в окне.
- Тест прибора дважды падал с первого прогона из-за неверного эталона, критерии не менялись — история
  в шапке `src/features/welcome/signalTrace.test.ts`.

Вживую в браузере: стартовая страница на 1440, 1280, 1180, 1100, 1024, 768, 390 и 375 px; казахский
и английский на 1440 и 390; «уменьшить движение»; прибор — перетаскивание по графику, Home/End, стрелки,
пробел. Снимки делались Playwright в полном разрешении.

## 17 октября 2026 — имена вместо кодов, простой вид

Что менялось: дети в демо названы по именам (Алихан, Айша, Нурислам, Томирис, Данияр, Амина),
в клинике поле «Код» стало «Имя»; лишние строки убраны, второстепенное ушло за «Показать
подробности» (`EXPERIENCE.md`, раздел «Имена вместо кодов и простой вид»). Алгоритмы не менялись,
числа демо прежние: внутренний ключ P01–P06 остался зерном движений.

| Проверка | Команда | Итог |
|---|---|---|
| Типы и линтер | `npm run typecheck`, `npm run lint` | 0 / 0 |
| Юнит-тесты | `npm test` | 244 из 244, 18 файлов; все прежние проверки чисел демо прошли без правки ожиданий |
| Сквозные тесты, Chrome | `npm run e2e` | **27 из 27** с первого прогона, компьютер и Pixel 7 |
| Диаграммы | `npm run docs:check` | 18 из 18 |
| Демо одним файлом | `npm run build:demo` | 1,81 МБ |

Новые проверки: имя в заголовке вкладки («Алихан · NeuroMove»), имя в файле выгрузки
(`neuromove-DEMO-Алихан-…-raw.csv`), в подсказке гида нет строки «Нажмите», имя с пробелом
проходит через паспорт записи CSV, архив принимает имя и старый код `P07`, но не формулу и не
строку длиннее 40 знаков; в клинике новый пациент создаётся с полем «Имя». Путь с гидом пройден
вживую на 1440×900 и 390×844, ошибок в консоли нет.

## 15 октября 2026 — «демо» говорит одна полоса, тексты без длинного тире

Что менялось: пометки «Демо-данные», «Симулятор», «Демо» и пояснения про симуляцию убраны с экранов
демо, о демо говорит только тёмная полоса сверху; водяной знак «ДЕМО» остался только на бумаге;
гид и вступление не зовут пациента кодом; в словарях ru, kk, en нет длинного тире (`EXPERIENCE.md`,
раздел «„Демо“ говорит одна полоса»). Алгоритмы и числа демо не менялись: зерно движений прежнее.

| Проверка | Команда | Итог |
|---|---|---|
| Типы и линтер | `npm run typecheck`, `npm run lint` | 0 / 0 |
| Юнит-тесты | `npm test` | 240 из 240, 18 файлов, числа демо прежние |
| Сквозные тесты, Chrome | `npm run e2e` | **27 из 27**, компьютер и Pixel 7 |
| Диаграммы | `npm run docs:check` | 18 из 18 |
| Демо одним файлом | `npm run build:demo` | 1,83 МБ |

Новые проверки в сквозных тестах: во вступлении нет «демо», «симуляц», «P01» и «—»; в карточке
пациента, подсказках гида и отчёте сеанса нет «демо» и «симуляц»; полоса «Демо» на месте;
водяной знак скрыт на экране и виден при печати (`emulateMedia`); в пространстве клиники нет ни
полосы, ни знака. Первый прогон упал на одном тесте проверки точности: фраза «…в начале записи —
без калибровки…» стала двумя предложениями, «Без» с заглавной, а шаблон теста искал строчную.
Поведение то же, шаблон поправлен, повторный прогон зелёный.

## 15 октября 2026 — гид демо стал подсказкой у элемента

Гид переделан: подсветка блока и подсказка рядом, действие — настоящей кнопкой приложения
(`EXPERIENCE.md`, раздел «Демо»). Сквозные тесты демо нажимают настоящие кнопки, на которые
показывает гид, и проверяют, что своей кнопки у гида на шаге действия нет. Итоги прогона — ниже,
в таблице 14 октября, обновлены после этой правки.

## Прогон 14 октября 2026, 23:15 (+05) — после редизайна «Инструмент»

Что менялось: система рисунков `src/figures/`, каркас и токены, экраны теста, вступление и итог демо,
пустые состояния (`EXPERIENCE.md`). Алгоритмы, движок, хранилище и устройства не менялись.

| Проверка | Команда | Итог |
|---|---|---|
| Типы и линтер | `npm run typecheck`, `npm run lint` | 0 / 0 |
| Юнит-тесты | `npm test` | 240 из 240, 18 файлов |
| Сквозные тесты, Chrome | `npm run e2e` | **27 из 27**, компьютер и Pixel 7: + полный путь гида до «Демо пройдено», «Вернуться к шагу» и «Пройти ещё раз» (≈60 с, тест вживую идёт в реальном времени); вступление к демо в первом тесте; axe WCAG 2.1 AA и правила 2.2 AA; ширины 320–1440 px на трёх языках; фокус не прячется под панелями |
| Диаграммы | `npm run docs:check` | 18 из 18 |
| Демо одним файлом | `npm run build:demo` | 1,82 МБ; лаборатория рисунков `#/lab` в файл не попадает |

Найдено и исправлено по ходу: класс `.sheet` выезжающей панели (нигде не используется) ограничивал
высоту листа печати и отчёта для семьи до 85 % окна — на невысоком экране низ листа обрезался;
фокус с клавиатуры на телефоне мог уйти под нижнюю навигацию — теперь `scroll-padding` учитывает
закреплённые панели; «В этом сеансе нет замеров» при измеренной другой руке — теперь фраза называет,
что измерено; неизмеренная рука на рисунке строки отчёта больше не рисуется как «0°».

Не проверено и сейчас: настоящая плата и датчики, люди, Firefox и WebKit, экранный диктор,
казахские тексты нового вступления и гида — носителем языка.

---

## 0. Прогон 2 октября 2026, 09:40 (+05) — после инженерного прохода

Подробности, сырые числа и находки — [`ENGINEERING_10H/`](ENGINEERING_10H/). Здесь — итог проверок.

| Проверка | Команда | 1 октября | 2 октября, 09:40 |
|---|---|---|---|
| Типы и линтер | `npm run typecheck`, `npm run lint` | 0 / 0 | 0 / 0 |
| Юнит-тесты | `npm test` | 120, 10 файлов | **240, 18 файлов**; в них независимый эталон (самопроверка, оси, 60 сценариев в быстром режиме), свойства и fuzz, хранилище на fake-indexeddb, инварианты движка |
| Эксперименты, полный прогон | `npm run experiments` | — | **60 сценариев, 8 датчиков**, критерии записаны до прогона: 55 выполнены, 5 — известные ограничения F2, F3, F4 (`EXPERIMENTS.md`) |
| Мутации | `npm run mutate` | — | **16 из 16 убиты** |
| Сквозные тесты, Chrome | `npm run e2e` | 23 | **25**: + предпросмотр архива, + сбой «датчик плеча отвалился» |
| Прошивка на компьютере | `firmware/test/run.sh` | 76 | **108**: + отпечаток модуля, модель времени шины, образцы протокола |
| Сборка прошивки | `pio run` | 5 целей | 5 целей, ядра 2.0.17 и 3.3.12, 0 предупреждений в коде стенда |
| Корпус | `python ../hardware/models/enclosure/korpus_v3.py и proverka_v3.py` | сетки замкнуты | сетки замкнуты **и кабель не задевает крышку** (первая версия эту проверку не прошла бы — F15) |
| Диаграммы | `npm run docs:check` | 18 из 18 | 18 из 18 |
| Зависимости | `npm audit` | 0 | 0 (+ dev: fake-indexeddb 6.2.5) |
| Демо одним файлом | `npm run build:demo` | 1,84 МБ | 1,96 МБ |

Не проверено и сейчас: настоящая плата и датчики, люди, Firefox и WebKit, экранный диктор,
казахский текст носителем (`ENGINEERING_10H/BLOCKERS.md`).

---

Ниже — отчёт 1 октября без изменений.

Финальный прогон 1 октября 2026, 22:09–22:11 (+05), macOS, Node.js 24.14.1, Google Chrome
(установленный), последнее состояние сессии 1 октября. Здесь только то, что **действительно запущено**;
не проверенное — в разделе 4.

## 1. Автоматические проверки

| Проверка | Команда | Результат |
|---|---|---|
| Типы, TypeScript strict | `npm run typecheck` | 0 ошибок |
| Линтер, ESLint + правила хуков React | `npm run lint` | 0 замечаний |
| Юнит-тесты, Vitest | `npm test` | **120 из 120**, 10 файлов, ~4 с (2 октября: + вывод прошивки, поправки акселерометра) |
| Прошивка стенда на компьютере, поддельные MPU-6050 | `firmware/test/run.sh` | **76 из 76**, Apple clang и GCC, `-std=c++11 -Wall -Wextra -Werror` |
| Сборка прошивки | `pio run` в `firmware` | ESP32-S3 (COM и родной USB), классический ESP32 — ядро Arduino-ESP32 2.0.17; 0 предупреждений в коде стенда |
| Сборка сайта с CSP | `npm run build` | ок; JS 786 КБ (~230 КБ gzip), CSS 101 КБ |
| Сборка демо одним файлом с CSP по хешу | `npm run build:demo` | ок; `demo/NeuroMove.html` — 1.84 МБ |
| Сквозные тесты, Playwright в Chrome | `npm run e2e` | **23 из 23**: 19 на компьютере (1440×900), 4 на телефоне (Pixel 7), ~1.8 мин |
| Диаграммы Mermaid | `npm run docs:check` | **18 из 18** отрисованы Mermaid 11; проверка ловит ошибку на заведомо сломанной диаграмме |
| Зависимости | `npm audit` | 0 уязвимостей |

На старте сессии (20:36) было: типы и линтер — чисто, 90 юнит-тестов, сборка — ок, сквозных тестов не было.

### Сквозные тесты — что именно проверяют

| Тест | Компьютер | Телефон |
|---|---|---|
| Лендинг → «Попробовать демо» → карточка P01; подпись «На фото концепт»; заголовок вкладки «P01 · NeuroMove»; во вступлении, подсказках и карточке нет «демо», «симуляц», «P01», «—»; полоса «Демо» на месте; гид переживает перезагрузку | ✓ | ✓ |
| Живой тест → хотя бы один повтор → «Завершить и сохранить» → отчёт «Неполный» без пометок «демо» → после перезагрузки отчёт на месте | ✓ | ✓ |
| Обрыв связи → «Связь потеряна» → «Связь восстановлена» → «Продолжить» → тест идёт | ✓ | ✓ |
| Перезагрузка посреди теста → «Сеанс был прерван» → «Удалить» → больше не спрашивает | ✓ | — |
| CSP: `<meta>` с `connect-src 'none'`; `fetch` со страницы заблокирован | ✓ | — |
| Клиника: онбординг, пациент; файл с `demo=yes` — отказ и неактивный старт; настоящий файл — принят, с пометкой «Запись из файла» | ✓ | — |
| Настоящая выгрузка сырых данных из демо (`neuromove-DEMO-P01-…-raw.csv`) в клинике — отказ | ✓ | — |
| `demo/NeuroMove.html` с диска: заголовок, все картинки загружены, ошибок в консоли нет | ✓ | — |
| 14 экранов × 7 ширин (320, 375, 390, 430, 768, 1024, 1440) — нет горизонтальной прокрутки | ✓ | — |
| То же на казахском и английском — 14 экранов × 320 и 390 px | ✓ | — |
| axe, WCAG 2.1 A и AA и автоматические правила 2.2 AA (размер цели): нет серьёзных и критичных нарушений на 9 главных экранах | ✓ | — |
| Клавиатура: первый Tab — «Перейти к содержимому», фокус виден | ✓ | — |
| Окно подтверждения: фокус внутри, Tab не уходит наружу, Escape закрывает и возвращает фокус | ✓ | — |
| Фокус не прячется под закреплёнными панелями (WCAG 2.2, 2.4.11): 70 нажатий Tab на лендинге, главной и карточке P01 | ✓ | ✓ |
| Проверка точности: файл станка с отметками → «Пройдено…», 5 строк таблицы, пометка «Запись симулятора» | ✓ | — |
| «Пример: станок на симуляторе» → «Посчитать» → «Пройдено…» с пометкой «проверены формулы, а не прибор» | ✓ | — |
| Запись с датчиков: симулятор → отметки 30° и 60° → файл `neuromove-DEMO-bench-…csv` с паспортом `kind=bench`, `demo=yes` → загрузка в проверку → итог или честное «без калибровки» | ✓ | — |
| Печать отчёта и отчёт для семьи из демо: водяной знак «ДЕМО · СИМУЛИРОВАННЫЕ ДАННЫЕ» скрыт на экране и виден при печати | ✓ | — |
| Клиника: повтор лабораторной записи (паспорт не демо) → тест → «Завершить и сохранить» → отчёт с «Запись из файла», без полосы «Демо» и водяного знака | ✓ | — |

Каждый тест пути заодно проверяет, что в консоли нет ошибок и исключений.

### Юнит-тесты, добавленные 1 октября (90 → 112)

| Файл | Что проверяет |
|---|---|
| `data/export.test.ts` | ячейки-формулы становятся текстом, числа не трогаются; `demo` и `source` в каждой строке CSV; `DEMO` в имени файла, безопасные имена |
| `data/backup.test.ts` | архив с кодом `=1+1`, с ФИО вместо кода и с заметкой длиннее 20 000 знаков отклоняется; смоделированный сеанс не сохраняется в клинику |
| `devices/contract.test.ts` | выгрузка из демо и запись симулятора узнаются по паспорту; int16 вне диапазона — ошибка строки; строки одинаковы при любых границах кусков (50 случайных разбиений); мусор без перевода строки не копится; 16-битный seq; перезагрузка платы с паузой 2 с; повтор строки; файл с перезагрузкой посередине |
| `devices/firmware.test.ts` (2 октября) | вывод прошивки `firmware/test/golden.csv`: паспорт, свои пары, поправки, отсчёты — тем же разбором, что USB-порт; 30 нарезок на случайные куски; испорченная строка поправок не берётся |
| `core/validation.test.ts` | с 2 октября: датчик с заводским нулём 0,05 / 0,04 / 0,03 g и масштабом 1,03 — без поправок ошибка растёт, с поправками из паспорта равна исходной; запись станка 0–120°: подъём руки вперёд, отведение и локоть — MAE меньше 3°, порог 5° пройден; эталон врёт на 10° — смещение видно, порог не пройден; тот же результат через файл с `# mark`; без неподвижной позы — «нет калибровки»; поворот и запись без отметок не считаются |

Фактические цифры инструмента проверки точности на записи станка из симулятора (3 «надевания»
с шумом, смещением гироскопа и перекосом ремешка): подъём руки — MAE 0.36, 0.97, 0.37°; локоть —
0.24, 0.18, 0.36°; наибольшая ошибка — 2.16°. Это проверка формул, а не прибора.

## 2. Что нашли тесты и что исправлено

| Нашёл | Дефект | Исправление |
|---|---|---|
| сквозной тест ширины, 320–375 px | печатный отчёт: таблица обрезалась краем листа, панель кнопок вылезала; отчёт для семьи — крупная цифра обрезалась; бейдж в «Настройках» вылезал | таблица прокручивается вбок, кнопки переносятся, блок «подъём руки» в столбик на телефоне, заголовки карточек переносятся |
| тот же тест на казахском | «Басып шығару немесе PDF сақтау» не помещалась в кнопку на 320 px | перенос текста в кнопках панели печати |
| axe | приглушённый текст 3.0–3.98:1 почти на всех экранах; на лендинге — подписи, переключатель языка, неактивные шаги «Как это работает»; просмотренные наблюдения — прозрачностью ниже 4.5:1 | `--text-3` `#7c8179` → `#5f645d`, подписи лендинга `#646a62`, на тёмном — 60% вместо 42%; при «уменьшить движение» все шаги видны полностью; просмотренные наблюдения — тише цветом, а не прозрачностью |
| сквозной тест на Pixel 7 | меню «Сбои» обрезалось нижней панелью теста (она прокручивается вбок) — на телефоне пункты не нажимались | меню — в портале над панелью; Escape закрывает |
| проверка ссылок OWASP | перевод строки и широкие `＝＋－＠` в начале ячейки CSV тоже опасны | добавлены в правило и тест |
| axe с правилами WCAG 2.2 AA | ссылка с кодом пациента в строке наблюдения — зона нажатия меньше 24 × 24 px (2.5.8) | зона нажатия увеличена, вид строки тот же |
| проход Tab по экранам (2.4.11) | на компьютере элемент с фокусом уезжал под полосу «Демо», на телефоне — под нижнюю навигацию; на лендинге кнопки первого экрана закрывала наехавшая секция | `scroll-padding` по высоте панелей; фокус на закрытой кнопке первого экрана возвращает страницу наверх |
| тот же тест на телефоне | моя первая правка лендинга возвращала страницу наверх и там, где экран не закреплён: кнопка уходила за край | наверх — только если элемент действительно закрыт после прокрутки браузера |
| ручная проверка в браузере | знак `/brand/…` по абсолютному пути: с диска и из подпапки не грузится; на светлом фоне — 14 px | знак через `import`, холст обрезан |
| ручная проверка через Playwright | `isSecureContext` на `file://` — `true`, `navigator.serial` есть: прежний README говорил, что с диска Web Serial недоступен | README и архитектура поправлены: API есть, с портом не проверено |
| чтение кода `SerialDevice` и `SessionEngine` | буфер строк USB рос без предела на мусоре; при перезагрузке платы или 16-битном seq время отсчётов шло бы назад, а учёт потерь слеп | `LineSplitter` с пределом и `SeqUnwrapper`; юнит-тесты |
| ревью записи с отметками | после 15 минут запись упирается в предел, новые отметки легли бы на старый отсчёт | отметка после предела — отказ с понятным текстом |

## 3. Ручные проверки в браузере

| Что | Где | Итог |
|---|---|---|
| Живой путь демо от лендинга до теста вживую, перезагрузка посреди теста, «Продолжить сеанс» | 1280×800 | работает |
| Знак в боковой панели и шапке | 1280×800 | виден |
| Меню «Сбои» над панелью теста | 375×812 | на месте, Escape закрывает |
| Пустые состояния клиники: «Первые шаги», «Недостаточно данных», «Сначала добавьте пациента» | 1280×800 | понятные, у каждого есть действие |
| Заголовки вкладок по экранам | 1280×800 | «Главная · NeuroMove», «P01 · NeuroMove», «Страница не найдена · NeuroMove» |
| Первый экран лендинга с подписью «фото — концепт» | 375×812 | помещается, читается |
| Скорость на собранном сайте, Chrome, этот компьютер, без ограничения сети | `vite preview` | лендинг: LCP ~0.11 с; приложение в новом браузере: ~1.4 с, из них ~1.2 с — однократная симуляция демо |

## 4. Не проверено

| Что | Почему | Риск |
|---|---|---|
| Настоящие датчики: USB (ESP32) и Bluetooth | железа нет | высокий: прошивка и разбор потока проверены только на компьютере — поддельные датчики, файлы, куски потока |
| Проверка точности на настоящей записи станка | стенда нет | высокий: инструмент проверен только на записях симулятора |
| Точность на людях | нет стенда и добровольцев | высокий: цифры точности — только симулятор |
| Safari и Firefox | показ в Chrome; Web Serial в Safari нет | средний для лендинга, низкий для показа |
| Экранный диктор (VoiceOver, NVDA) | нет времени | средний |
| Экранный диктор (VoiceOver, NVDA) — «фокус не перекрыт» проверяется эвристикой: точка в центре и углах элемента, а не глазами | нет времени | средний |
| Печать на бумагу | только вид для печати на экране | низкий |
| Медленная сеть | замеры только на этом компьютере | низкий: есть демо одним файлом |
| Казахский текст носителем языка | нет носителя в команде софта | средний для показа в казахоязычном центре |
| Хостинг по https | сайт ещё не размещён (`docs/DEPLOYMENT.md`, раздел 4) | — |

## 5. Как повторить

```bash
cd website
npm install
npm run typecheck && npm run lint && npm test
npm run e2e
npm run docs:check
```

Отчёт Playwright с трассами упавших тестов — `e2e-report/index.html` (в git не попадает).
