Amir10202010/neuromove/website/docs/ENGINEERING_10H/EXPERIMENTS.md

# Эксперименты: точность углов на независимом эталоне

Раздел «Критерии» записан **2 октября 2026 в 07:35, до первого прогона**. Результаты
дописываются ниже, критерии после прогона не меняются. Если критерий не выполнен — это
находка в `FINDINGS.md`, а не повод сдвинуть порог.

## Зачем независимый эталон

Прежняя проверка углов шла на симуляторе приложения (`src/simulation/`). Он написан тем же
человеком и с теми же допущениями, что и формулы: например, при сгибании локтя симулятор
отрывает плечо только **вперёд** — ровно то направление, при котором формула локтя верна.
Такая проверка не может найти ошибку в допущении, потому что повторяет его.

Эталон `src/verification/` построен заново:

| | Симулятор приложения | Эталон |
|---|---|---|
| Повороты | матрицы 3 × 3, `lib/vec3` | кватернионы, свой код |
| Оси мира | x вперёд, y влево, z вверх | X вправо, Y вперёд, Z вверх |
| Плечо | сгибание, затем отведение | плоскость подъёма + подъём + поворот вокруг кости (как в рекомендациях ISB) |
| Локоть | поворот вокруг оси y мира в осях плеча | шарнир с осью, закреплённой в плече, плюс угол вальгуса |
| Ускорение | вторая разность положений по отсчётам 100 Гц | центральная разность 4-го порядка по непрерывному времени |
| Гироскоп | разность матриц соседних отсчётов | производная кватерниона, 4-й порядок |
| Датчик | шум и смещение, без фильтра | модель MPU-6050 по даташиту: внутренние 1 кГц, фильтр DLPF ≈ 44 Гц с задержкой ~4,9 мс, ноль и масштаб, перекрёстная чувствительность, шум, округление, упор |
| Случайные числа | mulberry32 (`lib/random`) | xoshiro128** — свой код |

Из кода приложения эталон берёт только то, что проверяется: `MotionPipeline`, `Calibrator`,
`exerciseSample` (как в `core/validation.ts`) и `SessionEngine` для объёма движения по повторам.

## Модель датчика — числа из даташита

Источник: InvenSense, *MPU-6000/MPU-6050 Product Specification*, PS-MPU-6000A-00, rev. 3.1
(24.10.2011), разделы 6.1–6.2; *Register Map and Descriptions*, RM-MPU-6000A-00, rev. 4.0,
регистр 26 (CONFIG). PDF скачан и прочитан 2 октября 2026.

| Параметр | Даташит | В модели |
|---|---|---|
| Масштаб акселерометра ±4 g | 8 192 ед/g | 8 192 |
| Масштаб гироскопа ±1000 °/с | 32,8 ед/(°/с) | 32,8 |
| Допуск масштаба | ±3 % (оба) | равномерно ±3 % |
| Ноль акселерометра | X, Y ±50 мg; Z ±80 мg | равномерно в этих пределах |
| Ноль гироскопа | ±20 °/с | равномерно ±20 °/с |
| Перекрёстная чувствительность | ±2 % | равномерно ±2 % |
| Шум акселерометра | 400 мкg/√Гц | 400 мкg/√Гц на 1 кГц до фильтра |
| Шум гироскопа | 0,005 °/с/√Гц | 0,005 °/с/√Гц на 1 кГц до фильтра |
| Фильтр DLPF_CFG = 3 | 44 Гц, 4,9 мс (акс.); 42 Гц, 4,8 мс (гир.) | два звена первого порядка, τ = 2,45 мс: срез ≈ 42 Гц, задержка 4,9 мс |
| Чувствительность гироскопа к ускорению | 0,1 °/с/g | 0,1 °/с/g |

## Метрики

По каждому сценарию: средняя ошибка со знаком (прибор − эталон), MAE, RMSE, P95 модуля,
максимум модуля, доля отсчётов, где прибор дал угол (покрытие). Окно расчёта — после
окончания калибровки + 0,5 с. Для объёма движения — ошибка ROM по каждому повтору,
посчитанному `SessionEngine`, против максимума угла эталона в том же повторе.

## Критерии — записаны до прогона

Бюджет SMART v2 — средняя ошибка ≤ 5° против эталона. Алгоритму отдаётся не больше
1–2° этого бюджета: остальное съедят ремешок, кожа и человек с гониометром.

| # | Сценарий | Критерий |
|---|---|---|
| C1 | Покой: подъём вперёд и в сторону 0–150°, локоть 0–140° при висящем плече, поворот предплечья −80…+80° | MAE ≤ 1,0°, максимум ≤ 2,0° — на каждом |
| C2 | Медленно: 0 → 150° за 3 с и обратно, 3 повтора | RMSE ≤ 2°, ошибка ROM повтора ≤ 2° |
| C3 | Быстро: 0 → 150° за 0,6 с и обратно | RMSE ≤ 5°, ошибка ROM повтора ≤ 4° |
| C4 | Рывок выше 1000 °/с: упор гироскопа | упор посчитан, шаг помечен, нет NaN |
| C5 | Остаточное смещение гироскопа +0,5 °/с после калибровки | MAE в покое ≤ 1,0° |
| C6 | Ноль и масштаб акселерометра по краю даташита | с поправками из калибровки в 6 положениях MAE ≤ 1,0°; без поправок — записать |
| C7 | Шум × 3 | MAE ≤ 1,5° |
| C8 | Дрожание момента отсчёта, σ = 1 мс | MAE растёт не больше чем на 0,3° |
| C9 | Пропуски: 5 % случайно; пачка 0,3 с посреди движения | MAE растёт не больше чем на 0,3°; после пачки ошибка < 2° не позже чем через 1 с |
| C10 | Повтор строки (2 % отсчётов дважды) — через разбор потока | фильтр не сбрасывается; MAE растёт не больше чем на 0,1° |
| C11 | Перезагрузка платы посреди записи (seq снова с 0) | время только растёт; разрыв учтён; нет NaN |
| C12 | 10 минут, смещение гироскопа медленно гуляет | MAE последней минуты ≤ MAE первой + 0,5° |
| C13 | Локоть, плечо отклонено до 20° вперёд, назад или в сторону | ошибка ROM ≤ 5° — **или** шаг помечен как ненадёжный. Тихая ошибка > 5° недопустима |
| C14 | Поза калибровки: рука не висит вертикально (5–20°) | записать ошибку; если она больше 5° — нужно предупреждение |
| C15 | Перекос крепления до 10° | подъём MAE ≤ 1°, локоть ≤ 1,5°, поворот ≤ 3° |
| C16 | Наклон туловища назад 10° при подъёме руки | наклон туловища измерен с ошибкой ≤ 1,5° |
| C17 | Знак: супинация положительна на обеих руках | знак верный на правой и левой руке |

### Добавлено 09:03, до прогона: калибровка в 6 положениях на неровном столе

| # | Сценарий | Критерий |
|---|---|---|
| C6t | Грани калибровки стоят с наклоном 2°, 5°, 10°, 14° (стол, рука); затем подъём руки в покое | при наклоне до 5° средняя ошибка растёт не больше чем на 0,3° против ровных граней; 10° и 14° — записать. Прошивка такие грани принимает (боковые оси < 0,25 g) |

## Результаты

Сырые результаты, все полные (8 зёрен — 8 разных датчиков со своими ошибками, долгий сценарий 10 минут):

| Файл | Код | Когда |
|---|---|---|
| [`data/2026-10-02-before.json`](data/2026-10-02-before.json) | до правок этого прохода | 07:49 |
| [`data/2026-10-02-after-elbow.json`](data/2026-10-02-after-elbow.json) | после правки локтя (F1) | 08:00 |
| [`data/2026-10-02-final.json`](data/2026-10-02-final.json) | после всех правок дня | 09:38 |

Финальный прогон отличается от прогона «после локтя» одной строкой: C4 (флаг упора теперь ставится).
Все числа точности совпали до сотых — правки движка после 08:01 (пропавший датчик, переворот
датчика, поза калибровки) точность не тронули.

Таблица ниже — «до» против финала, собрана скриптом `node scripts/experiments-table.mjs`, числа
руками не переписывались. Повторить: `npm run experiments` (около минуты), результат —
`data/latest.json`. Быстрая версия (2 зерна, 2 минуты) идёт в каждом `npm test`.

Сводка по сценарию — худшее значение по зёрнам, если не сказано иное. «Нет (F…)» — известное
ограничение из `FINDINGS.md`; тест требует, чтобы оно оставалось видимым, или (для F2) проверяет
защитную границу от регрессии.

Прогон «до»: 2026-10-02T02:49:21.758Z → 2026-10-02T02:50:14.169Z, зёрен в C1: 8
Прогон «после»: 2026-10-02T04:38:37.001Z → 2026-10-02T04:39:41.938Z

| Сценарий | Критерий | До | Сводка до | После | Сводка после |
|---|---|---|---|---|---|
| C1-shoulder_flexion-ideal | MAE ≤ 1,0°, максимум ≤ 2,0° | да | worstMae 0,03; worstMax 0,18; meanMae 0,03 | да | worstMae 0,03; worstMax 0,18; meanMae 0,03 |
| C1-shoulder_flexion | MAE ≤ 1,0°, максимум ≤ 2,0° | **нет** | worstMae 1,2; worstMax 2,02; meanMae 0,62 | нет (F2) | worstMae 1,2; worstMax 2,02; meanMae 0,62 |
| C1-shoulder_abduction-ideal | MAE ≤ 1,0°, максимум ≤ 2,0° | да | worstMae 0,03; worstMax 0,16; meanMae 0,03 | да | worstMae 0,03; worstMax 0,16; meanMae 0,03 |
| C1-shoulder_abduction | MAE ≤ 1,0°, максимум ≤ 2,0° | да | worstMae 0,88; worstMax 1,52; meanMae 0,41 | да | worstMae 0,88; worstMax 1,52; meanMae 0,41 |
| C1-elbow_flexion-ideal | MAE ≤ 1,0°, максимум ≤ 2,0° | да | worstMae 0,07; worstMax 0,29; meanMae 0,05 | да | worstMae 0,04; worstMax 0,27; meanMae 0,04 |
| C1-elbow_flexion | MAE ≤ 1,0°, максимум ≤ 2,0° | да | worstMae 0,99; worstMax 1,58; meanMae 0,45 | нет (F2) | worstMae 1,03; worstMax 1,64; meanMae 0,44 |
| C1-forearm_rotation-ideal | MAE ≤ 1,0°, максимум ≤ 2,0° | да | worstMae 0,03; worstMax 0,1; meanMae 0,02 | да | worstMae 0,03; worstMax 0,1; meanMae 0,02 |
| C1-forearm_rotation | MAE ≤ 1,0°, максимум ≤ 2,0° | да | worstMae 0,86; worstMax 1,61; meanMae 0,4 | да | worstMae 0,86; worstMax 1,61; meanMae 0,4 |
| C2-slow | RMSE ≤ 2°, ошибка ROM повтора ≤ 2° | да | worstRmse 1,17; worstRomErr 0,63; minReps 3 | да | worstRmse 1,17; worstRomErr 0,63; minReps 3 |
| C3-fast | RMSE ≤ 5°, ошибка ROM повтора ≤ 4° | да | worstRmse 3,06; worstRomErr 2,11; minReps 3 | да | worstRmse 3,06; worstRomErr 2,11; minReps 3 |
| C4-flick | упор посчитан, шаг помечен «saturation», нет NaN | **нет** | minSaturated 78; flaggedAll нет | да | minSaturated 78; flaggedAll да |
| C5-gyro-drift | MAE ≤ 1,0° при +0,5 °/с после калибровки | да | worstMae 1; worstMax 1,77; meanMae 0,56 | да | worstMae 1; worstMax 1,77; meanMae 0,56 |
| C6-edge-nocal | без поправок — записать | да | worstMae 5,73; worstMax 9,8; meanMae 3,52 | да | worstMae 5,73; worstMax 9,8; meanMae 3,52 |
| C6-edge-cal | с поправками 6 положений MAE ≤ 1,0° | **нет** | worstMae 1,22; worstMax 2,07; meanMae 0,63 | нет (F2) | worstMae 1,22; worstMax 2,07; meanMae 0,63 |
| C7-noise3 | MAE ≤ 1,5° при шуме × 3 | да | worstMae 1,23; worstMax 2,09; meanMae 0,63 | да | worstMae 1,23; worstMax 2,09; meanMae 0,63 |
| C8-jitter | MAE растёт ≤ 0,3° при дрожании σ = 1 мс | да | worstDelta 0,01 | да | worstDelta 0,01 |
| C9-drops | MAE растёт ≤ 0,3° при 5 % пропусков; после пачки 0,3 с ошибка < 2° не позже 1 с | да | worstDelta 0,01; worstErrAfterBurst 1,59 | да | worstDelta 0,01; worstErrAfterBurst 1,59 |
| C10-duplicates | повтор строки не сбрасывает фильтр; MAE растёт ≤ 0,1° | да | worstDeltaParser 0; worstDeltaRawDup 0,2 | да | worstDeltaParser 0; worstDeltaRawDup 0,2 |
| C11-reset | время только растёт, разрыв учтён, нет NaN | да | allMonotonic да; anyNaN нет | да | allMonotonic да; anyNaN нет |
| C12-long | MAE последней минуты ≤ MAE первой + 0,5° | да | worstGrowth 0,01 | да | worstGrowth 0,01 |
| C13-elbow-0-5 | ошибка ROM ≤ 5° или шаг помечен | да | worstRomErr 1,13; silentOver5 нет; minReps 3 | да | worstRomErr 1,13; silentOver5 нет; minReps 3 |
| C13-elbow-0-10 | ошибка ROM ≤ 5° или шаг помечен | да | worstRomErr 1,02; silentOver5 нет; minReps 3 | да | worstRomErr 1,02; silentOver5 нет; minReps 3 |
| C13-elbow-0-15 | ошибка ROM ≤ 5° или шаг помечен | да | worstRomErr 0,92; silentOver5 нет; minReps 3 | да | worstRomErr 0,92; silentOver5 нет; minReps 3 |
| C13-elbow-0-20 | ошибка ROM ≤ 5° или шаг помечен | да | worstRomErr 0,89; silentOver5 нет; minReps 3 | да | worstRomErr 0,9; silentOver5 нет; minReps 3 |
| C13-elbow-180-5 | ошибка ROM ≤ 5° или шаг помечен | **нет** | worstRomErr 11,15; silentOver5 да; minReps 3 | да | worstRomErr 1,34; silentOver5 нет; minReps 3 |
| C13-elbow-180-10 | ошибка ROM ≤ 5° или шаг помечен | **нет** | worstRomErr 21,18; silentOver5 да; minReps 3 | да | worstRomErr 1,43; silentOver5 нет; minReps 3 |
| C13-elbow-180-15 | ошибка ROM ≤ 5° или шаг помечен | **нет** | worstRomErr 31,18; silentOver5 да; minReps 3 | да | worstRomErr 1,5; silentOver5 нет; minReps 3 |
| C13-elbow-180-20 | ошибка ROM ≤ 5° или шаг помечен | **нет** | worstRomErr 41,15; silentOver5 да; minReps 3 | да | worstRomErr 1,55; silentOver5 нет; minReps 3 |
| C13-elbow-90-5 | ошибка ROM ≤ 5° или шаг помечен | **нет** | worstRomErr 6,21; silentOver5 да; minReps 3 | да | worstRomErr 1,14; silentOver5 нет; minReps 3 |
| C13-elbow-90-10 | ошибка ROM ≤ 5° или шаг помечен | **нет** | worstRomErr 11,6; silentOver5 да; minReps 3 | да | worstRomErr 1,04; silentOver5 нет; minReps 3 |
| C13-elbow-90-15 | ошибка ROM ≤ 5° или шаг помечен | **нет** | worstRomErr 17,23; silentOver5 да; minReps 3 | да | worstRomErr 1,04; silentOver5 нет; minReps 3 |
| C13-elbow-90-20 | ошибка ROM ≤ 5° или шаг помечен | **нет** | worstRomErr 23,09; silentOver5 да; minReps 3 | да | worstRomErr 1,07; silentOver5 нет; minReps 3 |
| C14-shoulder_flexion-10 | записать ошибку против анатомического угла; если > 5° — нужно предупреждение | да | worstRomErr 10,83 | да | worstRomErr 10,83 |
| C14-shoulder_flexion-20 | записать ошибку против анатомического угла; если > 5° — нужно предупреждение | да | worstRomErr 20,65 | да | worstRomErr 20,65 |
| C14-elbow_flexion-20 | записать ошибку против анатомического угла; если > 5° — нужно предупреждение | да | worstRomErr 20,46 | да | worstRomErr 20,4 |
| C14-elbow_flexion-30 | записать ошибку против анатомического угла; если > 5° — нужно предупреждение | да | worstRomErr 30,28 | да | worstRomErr 30,23 |
| C15-flex-mis5 | подъём MAE ≤ 1° | да | worstMae 1; worstMax 1,78; meanMae 0,57 | да | worstMae 1; worstMax 1,78; meanMae 0,57 |
| C15-elbow-mis5 | локоть MAE ≤ 1,5° | да | worstMae 0,98; worstMax 1,58; meanMae 0,61 | да | worstMae 0,95; worstMax 1,57; meanMae 0,61 |
| C15-rot-mis5 | поворот MAE ≤ 3° | да | worstMae 1,14; worstMax 1,84; meanMae 0,5 | да | worstMae 1,14; worstMax 1,84; meanMae 0,5 |
| C15-flex-mis10 | подъём MAE ≤ 1° | да | worstMae 0,92; worstMax 1,64; meanMae 0,56 | да | worstMae 0,92; worstMax 1,64; meanMae 0,56 |
| C15-elbow-mis10 | локоть MAE ≤ 1,5° | да | worstMae 0,95; worstMax 1,54; meanMae 0,61 | да | worstMae 0,92; worstMax 1,53; meanMae 0,62 |
| C15-rot-mis10 | поворот MAE ≤ 3° | да | worstMae 1,17; worstMax 1,93; meanMae 0,57 | да | worstMae 1,17; worstMax 1,93; meanMae 0,57 |
| C16-trunk | наклон туловища с ошибкой ≤ 1,5° | да | worstTrunkMax 0,31; worstTrunkMae 0,11 | да | worstTrunkMax 0,31; worstTrunkMae 0,11 |
| C17-rot-right | знак верный (MAE ≤ 3°) | да | worstMae 0,86; worstMax 1,61; meanMae 0,4 | да | worstMae 0,86; worstMax 1,61; meanMae 0,4 |
| C17-rot-left | знак верный (MAE ≤ 3°) | да | worstMae 1,1; worstMax 1,88; meanMae 0,36 | да | worstMae 1,1; worstMax 1,88; meanMae 0,36 |
| C6t-tilt-0 | рост MAE против ровных граней ≤ 0,3° | — | — | да | meanMae 0,62; worstMae 1,2; growthVsFlat 0 |
| C6t-tilt-2 | рост MAE против ровных граней ≤ 0,3° | — | — | да | meanMae 0,62; worstMae 1,18; growthVsFlat 0 |
| C6t-tilt-5 | рост MAE против ровных граней ≤ 0,3° | — | — | да | meanMae 0,63; worstMae 1,13; growthVsFlat 0,01 |
| C6t-tilt-10 | записать | — | — | да | meanMae 0,66; worstMae 1,13; growthVsFlat 0,04 |
| C6t-tilt-14 | записать | — | — | да | meanMae 0,87; worstMae 2,04; growthVsFlat 0,25 |
| C13L-elbow-0-10 | ошибка ROM ≤ 5° или шаг помечен | — | — | да | worstRomErr 0,96; silentOver5 нет; minReps 3 |
| C13L-elbow-180-10 | ошибка ROM ≤ 5° или шаг помечен | — | — | да | worstRomErr 1,33; silentOver5 нет; minReps 3 |
| C13L-elbow-90-10 | ошибка ROM ≤ 5° или шаг помечен | — | — | да | worstRomErr 1,15; silentOver5 нет; minReps 3 |
| C13x-straight-shoulder-back | максимум ошибки угла ≤ 5° или шаг помечен | — | — | да | worstMax 3,37; worstMae 0,33; flaggedAll нет |
| C13x-hyperextension | максимум ошибки угла ≤ 5° или шаг помечен | — | — | нет (F3) | worstMax 20,14; worstMae 9,29; flaggedAll нет |
| C13x-stop-at-vertical | максимум ошибки угла ≤ 5° или шаг помечен | — | — | да | worstMax 3,41; worstMae 0,34; flaggedAll нет |
| C13x-carrying-pronation | максимум ошибки угла ≤ 5° или шаг помечен | — | — | нет (F4) | worstMax 11,85; worstMae 5,31; flaggedAll нет |
| C13x-strap-rotated-20 | максимум ошибки угла ≤ 5° или шаг помечен | — | — | да | worstMax 3,89; worstMae 1,42; flaggedAll нет |
| C13x-strap-rotated-30 | максимум ошибки угла ≤ 5° или шаг помечен | — | — | да | worstMax 4,5; worstMae 1,7; flaggedAll нет |
| C13x-noise3-back10 | максимум ошибки угла ≤ 5° или шаг помечен | — | — | да | worstMax 3,37; worstMae 1,18; flaggedAll нет |

### Что значат провалы

| Сценарий | Почему не проходит | Решение |
|---|---|---|
| C1-shoulder_flexion, C1-elbow_flexion, C6-edge-cal | алгоритм на идеальном датчике ошибается не больше 0,07° в среднем (строки `-ideal`); остаток до 1,03–1,13° — перекрёстная чувствительность MPU-6050 (±2 % по даташиту), её калибровка в 6 положениях не убирает (F2) | порог не меняем. Остаток укладывается в бюджет SMART (5°). Если на станке остаток окажется больше 1°, — калибровка по 12+ положениям с подгонкой эллипсоида (P2-6) |
| C1-elbow_flexion «после» | то же зерно 13: 0,99° → 1,03°; среднее по 8 датчикам стало лучше (0,45° → 0,44°), на идеальном датчике — тоже (худшее 0,07° → 0,04°) | не регрессия алгоритма; разобрано числами выше |
| C4-flick «до» | упор датчика считался, но флаг шага `saturation` нигде не ставился | исправлено (P1-5), в финальном прогоне проходит |
| C13x-hyperextension | переразгибание локтя при висящем плече по гравитации неотличимо от сгибания: +10° вместо −10° (F3). У старой формулы то же самое | ограничение метода; объём (пик) не страдает |
| C13x-carrying-pronation | вальгус 10° и пронация 60° во время сгибания: объём занижен на 8–10° (F4). У старой формулы то же самое | ограничение метода «угол от позы калибровки»; проверить на станке с поворотом предплечья |

## Производительность — базовые числа (09:19)

Сырые числа: [`data/2026-10-02-perf.json`](data/2026-10-02-perf.json), `src/verification/perf.node.test.ts`
(Node v24.14.1, MacBook разработчика). Бюджет — 10 мс на кадр (100 Гц).

| Что | Число | Доля бюджета |
|---|---|---|
| Движок сеанса, кадр трёх датчиков | 1.29 мкс | 0.013 % |
| Разбор строки imu-csv из порта | 1.24 мкс | меньше 0,02 % |
| Подготовка демо при первом запуске | 1.7 с | — |
| Сборка `dist/`: JS / CSS | 802,8 / 101,4 кБ, в gzip 239,5 / 20,5 кБ | за день +13 кБ JS |
| Демо одним файлом | 1,96 МБ | |

Узкое место не расчёт, а отрисовка: её меряли 1 октября (LCP лендинга ~0,11 с, `TEST_REPORT.md`).

## Свойства и fuzz (P2-1)

`src/verification/fuzz.test.ts`, зёрна фиксированы: 10 000 случайных строк после настоящего паспорта;
500 нарезок потока; 2 000 случайных последовательностей номеров с перезагрузками, повторами и порчей —
номера только растут, и каждая строка либо выдана ровно один раз, либо посчитана как повтор или порча;
движок на 60 с шума int16 с упорами, разрывами и пропавшими датчиками — ни исключений, ни NaN в угле;
150 порч архива — `null`, а не исключение, принятый архив цел. **Ошибок не нашлось.**

## Мутации (P2-4)

`npm run mutate` — `scripts/mutate.mjs`, итог в [`data/mutations.json`](data/mutations.json).
14 мутаций ключевых правил, **все 14 убиты**: знак шарнира и знак супинации, порог устаревания
показаний, старая формула локтя, доля фильтра, знак поправки акселерометра, слепая проверка движения
при калибровке, выброс повторов и подтверждение номера, защита ячеек CSV, запрет симуляции в клинике,
нули в выгрузке, флаги упора и калибровки с движением.
