Amir10202010/neuromove/research/algorithm-benchmarking.md

# Algorithm benchmarking: NeuroMove MCSE vs reference implementations

Reproduce (from `website/`):

```bash
COORD_BENCH_OUT=../research/benchmarks/ts-outputs.json npx vitest run src/lab/coord/bench.node.test.ts
```

```bash
python -I ../research/benchmarks/compare.py ../research/benchmarks/ts-outputs.json ../research/benchmarks/results.json
```

Reference environment (2026-11-08): Python 3.14.5, NumPy 2.5.4, SciPy 1.18.1, scikit-learn 1.9.1, tslearn 0.10.0,
ahrs 0.4.0 (isolated virtual environment, packages from PyPI). Fixtures are seeded (seed 424242) and generated by the
TypeScript side, so both sides receive identical inputs. Stored result: `research/benchmarks/results.json`
(`ts-outputs.json` is regenerated, not committed: 1.1 MB). Timings are single runs on the development laptop —
indicative only (the TypeScript side includes JIT warm-up; Python reference timings include interpreter overhead,
numba-free code paths for ahrs).

| Component | NeuroMove | Reference | Agreement | Time (TS / ref) |
|---|---|---|---|---|
| Thin SVD, 40 × 505 | `linalg.svd` (ml-matrix 6.15.1) | `numpy.linalg.svd` | max relative singular-value error 6.6 × 10⁻¹⁵; loading congruence 1.000 for components 1–3 | 43 ms / 4 ms |
| Madgwick IMU, 2 000 samples, same q₀ | `quat.madgwickSeries` (port of the reference update) | `ahrs.filters.Madgwick.updateIMU`, gain 0.033 | max orientation difference 3.0 × 10⁻⁶ ° | 2 ms / 52 ms |
| DTW unconstrained, 20 multivariate pairs, unequal lengths | `align.dtw` | `tslearn.metrics.dtw` | max \|Δ\| = 0 | 4 ms / — |
| DTW Sakoe–Chiba r = 5, equal lengths | `align.dtw(…, 5)` | tslearn `global_constraint="sakoe_chiba"` | max \|Δ\| = 0 | — |
| DTW Sakoe–Chiba r = 5, **unequal** lengths | slope-scaled diagonal ± r | tslearn: unscaled diagonal widened by \|n−m\| | up to 4.5 (different band definitions) | — |
| Diagonal GMM, K = 1…4, 90 points | `strategy.fitGmm` (EM, k-means++, 8 restarts) | `sklearn.mixture.GaussianMixture(covariance_type='diag', n_init=8)` | BIC identical for K = 1–3 (≤ 2 × 10⁻⁶); K = 4: 726.8 vs 723.1 (NeuroMove reached a worse local optimum, Δ log-lik 1.85); same BIC-selected K (3); labels at K = 3 ARI = 1.0 | 39 ms / 280 ms |
| Ward clustering, K = 3 | `strategy.wardClusters` (Lance–Williams) | `scipy.cluster.hierarchy.linkage(method='ward')` | ARI = 1.0 | — |
| Adjusted Rand index | `stats.adjustedRand` | `sklearn.metrics.adjusted_rand_score` | \|Δ\| = 0 | — |

## Disagreements investigated

1. **Banded DTW with unequal lengths.** Read `tslearn/metrics/_masks.py` (`_sakoe_chiba_mask_generic`): for
   sz1 > sz2 the band is `width = sz1 − sz2 + radius` around the unscaled diagonal; NeuroMove's band follows the
   slope-scaled diagonal i·m/n ± r. Both are used in the literature; neither is "wrong". With equal lengths the two
   definitions coincide and the results are identical. MCSE only applies DTW to equal-length (101-sample) curves,
   so the difference never affects an MCSE result. Documented in `align.ts`.
2. **GMM K = 4 local optimum.** EM is non-convex; with 8 seeded restarts the NeuroMove fit for K = 4 is 1.85
   log-likelihood units below scikit-learn's. The BIC-selected K is unaffected here because K = 4 is far from the
   minimum. In strategy discovery the consequence of a worse optimum is conservative (a higher BIC for larger K
   favours fewer strategies). Not hidden: listed as a known limitation; increasing restarts would change results
   and therefore the component version.

## What is not benchmarked against a reference

- Component-count selection, the strategy refusal rules, PSDA and the longitudinal metrics are NeuroMove workflows
  composed of the benchmarked primitives; they are validated against known ground truth instead
  (`research/mcse-validation.md`).
- The functional permutation test was not compared with spm1d (GPL-3.0, not installed). Its family-wise error
  control is checked empirically in V7b (0/20 false dissociations at n ≈ 12 and 0/20 at n ≈ 24).
