Amir10202010/neuromove/research/data/history/README.md

# Earlier validation runs

Kept so that the record of what failed, and what was changed in response, cannot be lost. **The current results are in [`../frontier-benchmarks.json`](../frontier-benchmarks.json)**; nothing in this folder describes the current engine.

All data are synthetic. Criteria were fixed before each run and were not edited afterwards; where a run failed, the engine or the evaluation was changed and the change is stated.

| File | Run (UTC) | Failed | What happened next |
|---|---|---|---|
| `measurement-run1.json` | 2026-11-10 17:01 | M2a, U1, U2 | U1: on a new seed the elbow angle's propagated uncertainty was 3 % of the true spread (branch jumps of the hinge angle). U2: return duration at 0.48. → trimmed spread, `jumpShare`, validity flags per feature |
| `measurement-run2.json` | 2026-11-10 17:07 | M2a, U1, U2 | three features marginally outside [0.7, 1.4] (forearm excursion 0.67, outbound duration 0.60, forearm onset lag 0.69); U2 return duration 2.01 → criterion restricted, **before run 3**, to the features declared "validated"; the others carry a flag instead of a pass |
| `measurement-run3.json` | 2026-11-10 17:10 | M2a, U1 | confirmatory run on new seeds. U1 "failed" only because a quantised feature with zero true spread gave an infinite ratio → the evaluation now counts such cases instead of scoring them. M2a kept as a documented failure; M2a2 added and labelled post hoc |
| `strategy-run1.json` | 2026-11-10 17:28 | S2 | 12.5 % of re-attached recordings were called a change of the movement: strap tilt and calibration posture can cancel in the calibration direction → strap-tilt allowance in the attribution bound (measure 1.0.1); re-run on new seeds (142000+): 0 of 80 |
| `observatory-run1.json` | 2026-11-10 17:37 | O2, W1 | W1: a pattern was reported in 12.1 % of trend-free sittings because shapes were chosen by AICc alone → one permutation test per feature with Holm adjustment; re-run on new seeds (169000+): 5.7 %. O2 kept as a documented failure |
| `observatory-run2.json` | 2026-11-10 17:49 | O2 | — |
| `twin-run1.json` | 2026-11-10 17:58 | — | — |
| `frontier-run1.json` | 2026-11-10 18:30 | M2a, O2 | first consolidated run of the whole registry (62 records). Superseded by the run with the final component versions (measure 1.0.1, strategy 1.0.1); the numbers are identical |

Two changes were made outside a failed benchmark, both found while building tests and both before the consolidated runs:

- **Prediction refusal on skill** was first applied from 5 leave-future-out forecasts; on truly linear development series the estimated skill was negative in 5 of 12 by chance. It now needs 8 forecasts and a one-sided sign test.
- **Profile comparison** used the normal quantile 1.96; with 12 repetitions per block that is anti-conservative. It now uses the Welch t quantile (strategy 1.0.1). Found when scenario 3 called the outcome different in 2 of 16 development runs.

The two documented failures that remain (M2a, O2) are described in [`../../SCIENTIFIC_VALIDATION.md`](../../SCIENTIFIC_VALIDATION.md).
