Amir10202010/neuromove/(commit log)

2026-10-29 Initialize NeuroMove repository
    [A1-1-proba-ready.3mf, A1-2-datchiki-G38-ready.3mf, A1-2-datchiki-template.3mf, A1-3-esp32-ready.3mf, clone-chip.csv, drop-and-return.csv, foreign-calibration.csv, golden.csv]
2026-11-07 Fix hidden clinic sessions; add research platform, offline sync and server
    Root cause: the load-time validator in data/backup.ts did not know
    protocolId 'single', so single-sensor sessions were saved to IndexedDB
    but hidden on every reload and dropped from backups. Import/clear then
    deleted the hidden records for good.
    - Single PROTOCOL_IDS source for type and validator; regression test
    - Quarantine: records failing validation are never deleted, downloadable
    - Recovery copy cleared only after the write is confirmed (flush)
    - IndexedDB v2 (additive): protocols, validation sessions, trials,
    outbox, sync state; blocked upgrade waits instead of using memory
    - Research module: goniometer valid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
2026-11-08 Add Functional Progression System for pediatric rehabilitation
    Goals → versioned programs → home and clinic practice → movement
    measurement → rule-based observations → professional review. The
    system never diagnoses, prescribes or changes a program on its own.
    - Rehab domain shared by browser and server (src/rehab): ten record
    kinds in one IndexedDB store (schema v3, additive) and one table
    (migration 0002_rehab); immutable versions enforced by a trigger;
    append-only goal history; caregiver role scoped to linked children
    - Professional workspace, family page (RU/KK/EN), child mode with
    participation rewards, break/stop, and live sensor feedback that is
    never saved as a m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
2026-11-08 Show boy or girl in figures by patient sex
    - Optional patient sex (boy / girl / not specified) in the patient form;
    records without it show the boy figure
    - Figures, charts and calibration art follow the sex of the patient on
    the open screen (figures/look.tsx); demo patients carry a sex
    - Design tokens and design system notes updated
2026-11-08 Add computational motor-learning lab
    Individual learning dynamics from repeated IMU sessions, with honest
    uncertainty, frozen reproducible results and study design. Built on the
    existing pipeline; hardware and firmware unchanged.
    - Engine (src/lab, pure TS): repetition-level measurement model; five
    candidate models incl. "no change" (linear, exponential, Kalman local
    level, dose-driven learning-retention); ML fit, profile-likelihood
    identifiability, AICc, leave-future-out, parametric bootstrap with
    small-sample correction; performance vs learning decomposition
    (within/between session, retention, transfer); raw 100 Hz quality,
    velocity events and features; trial-level dual-rate m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
2026-11-08 Sync lab records, store practice trials, add reliability and Kazakh
    - Team sync for lab records: entity lab_record, migration 0003_lab
    (nm_lab_records with an immutability trigger), one shared
    hash-checking validator for browser and server (src/lab/integrity.ts);
    demo/simulated content refused; caregivers may only add practice
    trials of a linked child
    - Consent-gated practice-trial recording from child-mode live practice
    (professional switch + active study consent; the adult sees a notice);
    trial-level models (no learning / single rate / fast + slow) on the
    Motor Twin page
    - Test-retest reliability (ICC(A,1), SEM, MDC95) from real pairs with no
    practice in between, shown on t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
2026-11-08 Add coordination & strategy engine and in-site team guide
    - Motor Coordination & Strategy Discovery Engine (src/lab/coord): multi-segment
    channels with observability status, phase segmentation with boundary
    uncertainty, landmark registration, coordination components (fPCA with
    parallel analysis + bootstrap rule), strategy discovery with refusal rules,
    performance-strategy dissociation, longitudinal strategy analysis via the
    existing learning-model engine
    - Workspace #/research/coordination (worker-based, RU/KK/EN), tile in the lab
    - Raw-stream manifest (SHA-256) for new sessions; consent-gated raw retention
    for practice sittings
    - Ground-truth synthetic generator and validation s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
2026-11-08 Clean up landing: simpler footer, quiet comparison, animated final dial
    - Remove the "For families" section (and its report sheet), the sensor
    concept caption and the hero simulator note
    - Comparison under "Today": one quiet two-column row instead of quotes
    - Footer: brand, section links and demo button, one legal line; no giant
    statement, second menu or second language switch
    - Final section: clock-style needle; needle, arc and number run 0° -> course
    angle when the dial comes into view (was scroll-bound and looked static)
    - Less empty space between the comparison and the sensor photo
2026-11-08 Compact landing footer and full nm favicon
    - Footer: medium-size "every movement has its story" statement with one
    small mark, then the legal line; drop the repeated logo, name and tagline
    - Favicon: full nm monogram with the accent dot instead of the old n mark
2026-11-08 Add v4 enclosures, new firmware pins and interactive team guide
    Enclosures v4 (hardware/models/enclosure, ПЕЧАТЬ-v4.md):
    - Snap fit derived from the teammate's Fusion edit (groove 1.0 mm), made
    stronger: 0.6 mm engagement, 10 mm bumps, 60° retention, third snap
    at the USB end on the ESP32 case; sensor bumps 8 mm.
    - Sensor pod for GY-521 20 x 15 mm, 5 cm strap tunnel, cable slot on
    the VCC/GND/SCL/SDA side, nm logo with vermilion inlay.
    - ESP32 case 10 mm longer: shelf for the cable housings cast with the
    walls, floor stop behind the breadboard, USB-C window 10.0 x 4.8 mm
    at the measured position.
    - Detailed part models, 3D viewer, sections, renders, STL/STEP and
    Bambu A1 p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
    [A1-v4-1-proba-ready.3mf, A1-v4-2-datchiki-ready.3mf, A1-v4-3-esp32-ready.3mf, korpus-v4-datchik-korpus.step, korpus-v4-datchik-korpus.stl, korpus-v4-datchik-kryshka-G.step, korpus-v4-datchik-kryshka-G.stl, korpus-v4-datchik-kryshka-P.step]
2026-11-08 Soften ESP32 lid snap to just above the teammate's and enlarge the USB-C window
    ESP32 lid: 0.5 mm engagement on both sides, 5 mm bumps, 50° retention,
    no third snap (teammate: 0.5/0.3 mm, 4 mm, 45-52°). Sensor snap unchanged.
    USB-C window 10.6 x 5.4 mm (was 10.0 x 4.8) to absorb measurement and
    print error. STL, STEP, Bambu project, viewer, renders and docs regenerated.
    [A1-v4-3-esp32-ready.3mf, korpus-v4-datchik-korpus.step, korpus-v4-datchik-kryshka-G.step, korpus-v4-datchik-kryshka-P.step, korpus-v4-datchik-kryshka-PR.step, korpus-v4-esp32-korpus.step, korpus-v4-esp32-korpus.stl, korpus-v4-esp32-kryshka.step]
2026-11-10 Add strategy profiles, flexibility and trade-off analyses, movement signature, task framework and learning observatory
2026-11-11 Add discovery layer, measurement planning, ground-truth scenarios and benchmark registry; Welch t in profile comparison
2026-11-11 Run analysis workers as site files with a main-thread fallback: the content policy blocked blob workers and the coordination analysis never finished in the built site
2026-11-13 Run every analysis in the clinic workspace: simulator allowed and labelled there, lab includes simulated sessions, one-click simulated course with raw data per patient; simulated clinic sessions stay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
2026-11-13 Show the device's own error detail under the connection error
